pepetech/iot-gateway/models/iot-gateway-box.stl

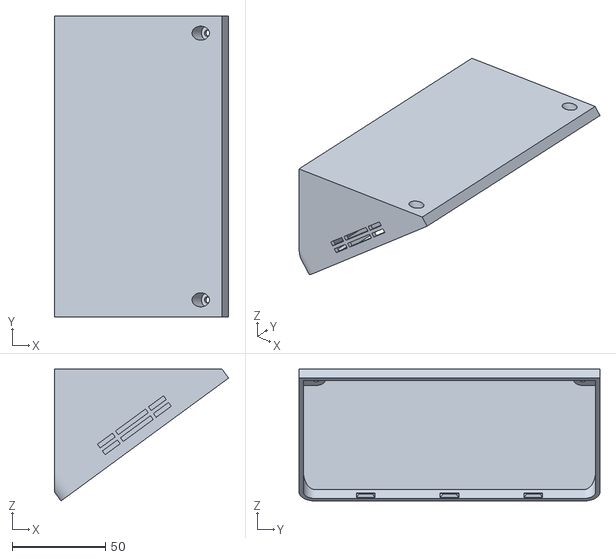
[picture p1: CAD file, 2019-12-28]
models/iot-gateway-box.stl
93.5 x 161.6 x 70.8
