pepetech/iot-gateway/models/iot-gateway-cover.stl

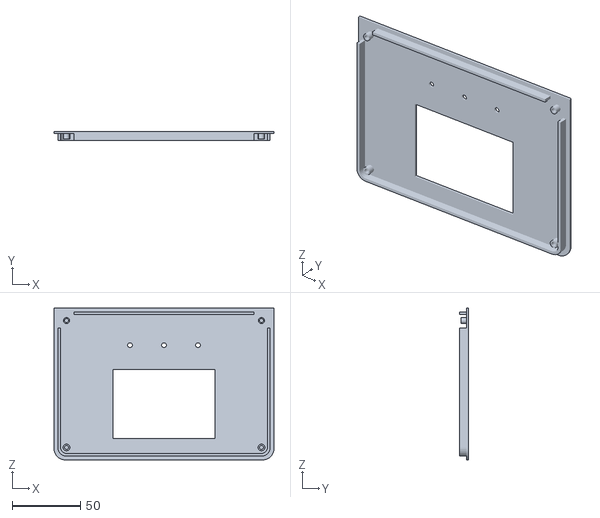
[picture p2: CAD file, 2019-12-28]
models/iot-gateway-cover.stl
161.6 x 6.70 x 111.6
