pepetech/iot-gateway/pcb/main/iot-gateway-main.pdf

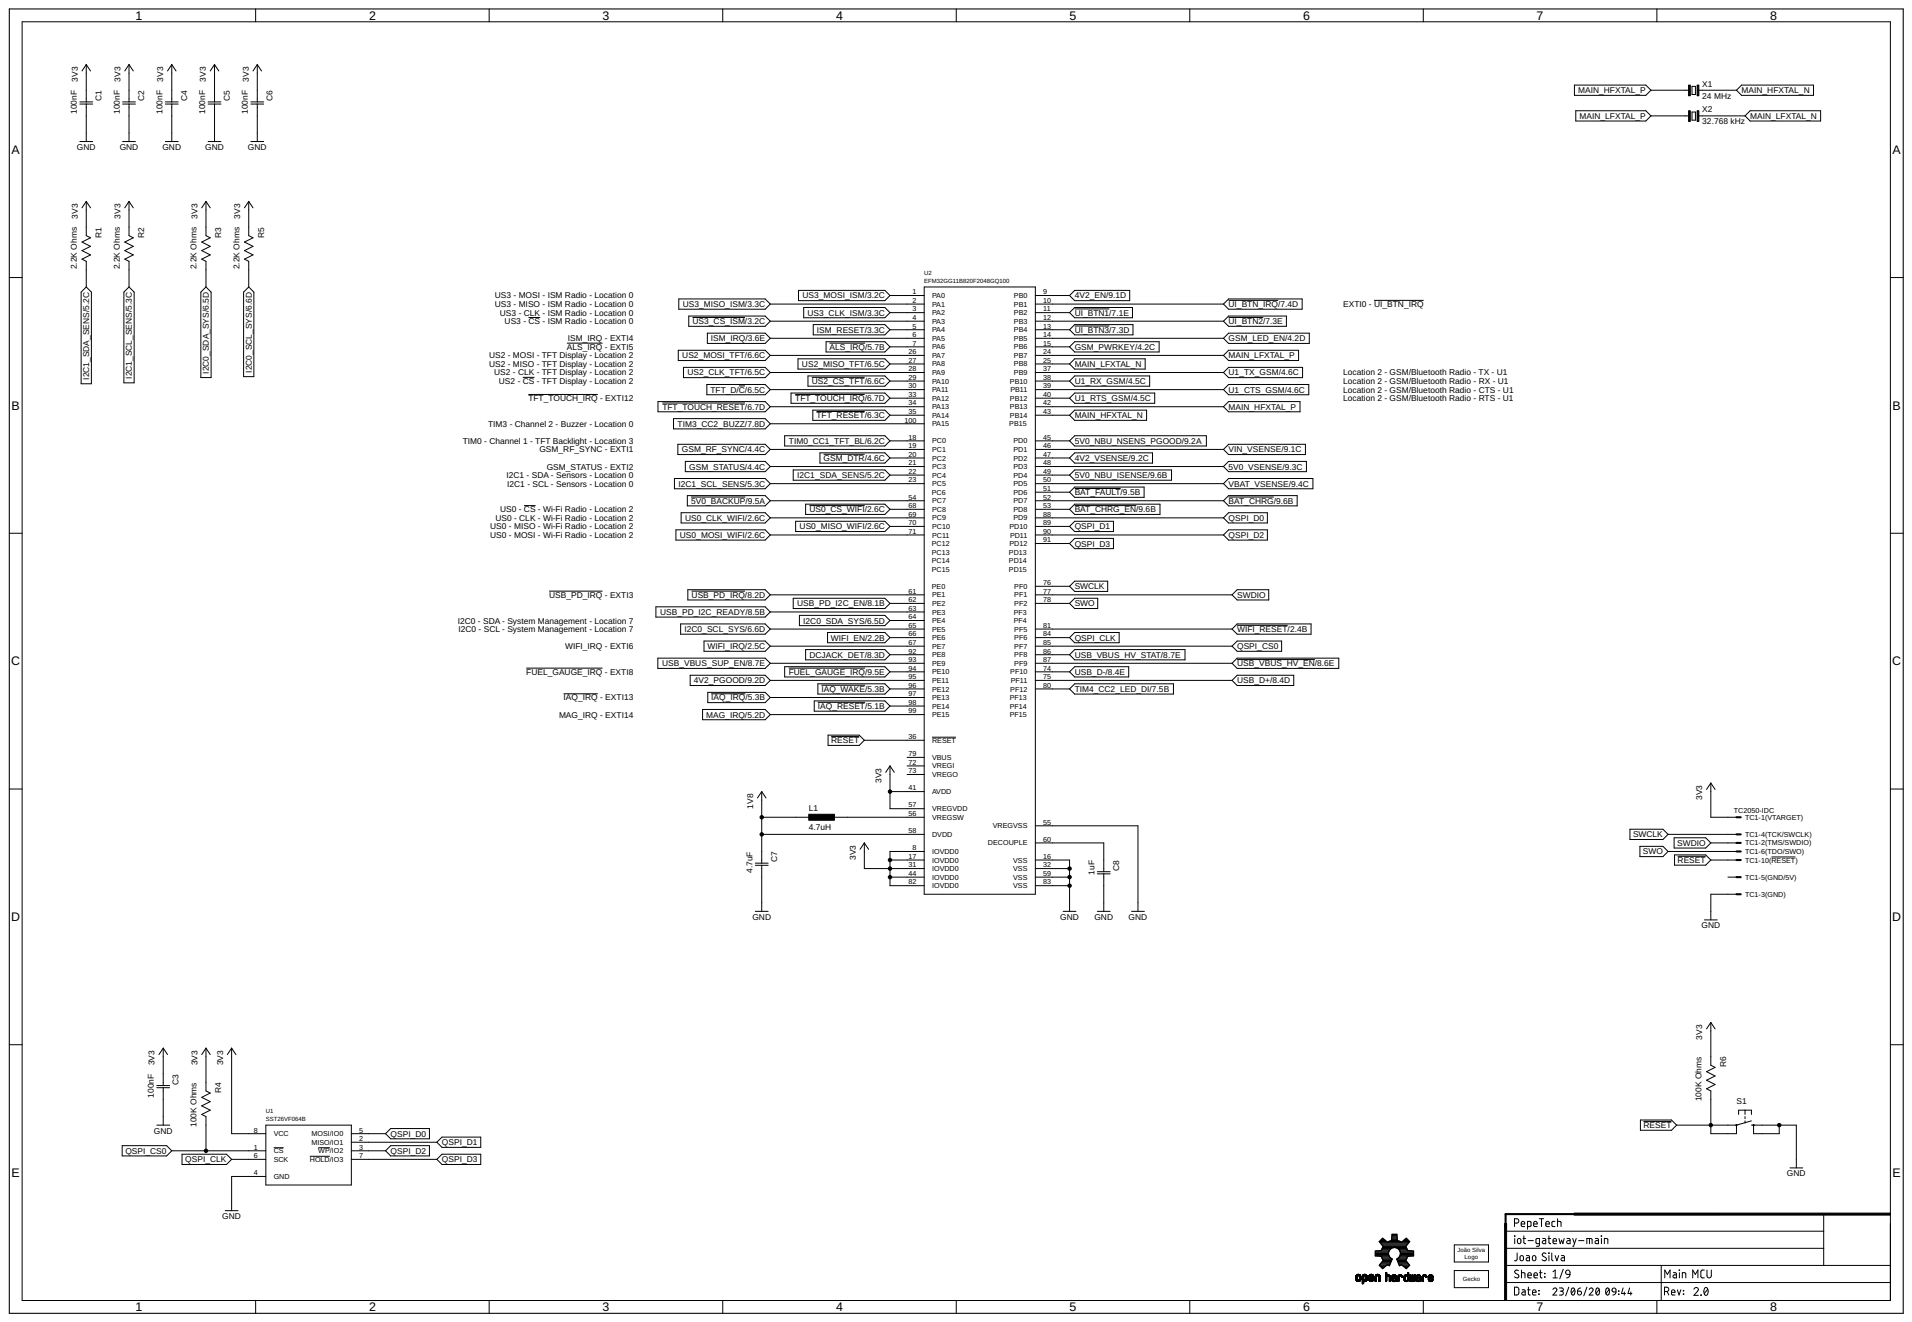
[picture p3: page 1]

US3 - MOSI - ISM Radio - Location 0
US3 - MISO - ISM Radio - Location 0
US3 - CLK - ISM Radio - Location 0
US3 - CS - ISM Radio - Location 0

US2 - MOSI - TFT Display - Location 2
US2 - MISO - TFT Display - Location 2
US2 - CLK - TFT Display - Location 2
US2 - CS - TFT Display - Location 2

Location 2 - GSM/Bluetooth Radio - TX - U1
Location 2 - GSM/Bluetooth Radio - RX - U1
Location 2 - GSM/Bluetooth Radio - CTS - U1
Location 2 - GSM/Bluetooth Radio - RTS - U1

TIM3 - Channel 2 - Buzzer - Location 0
TIM0 - Channel 1 - TFT Backlight - Location 3

US0 - CS - Wi-Fi Radio - Location 2
US0 - CLK - Wi-Fi Radio - Location 2
US0 - MISO - Wi-Fi Radio - Location 2
US0 - MOSI - Wi-Fi Radio - Location 2

I2C0 - SDA - System Management - Location 7
I2C0 - SCL - System Management - Location 7

TC2050-IDC
TC1-1(VTARGET) TC1-2(TMS/SWDIO) TC1-3(GND)

TC1-4(TCK/SWCLK) TC1-5(GND/5V) TC1-6(TDO/SWO) TC1-10(RESET)

31 | 32 VSS
44 | 59 VSS

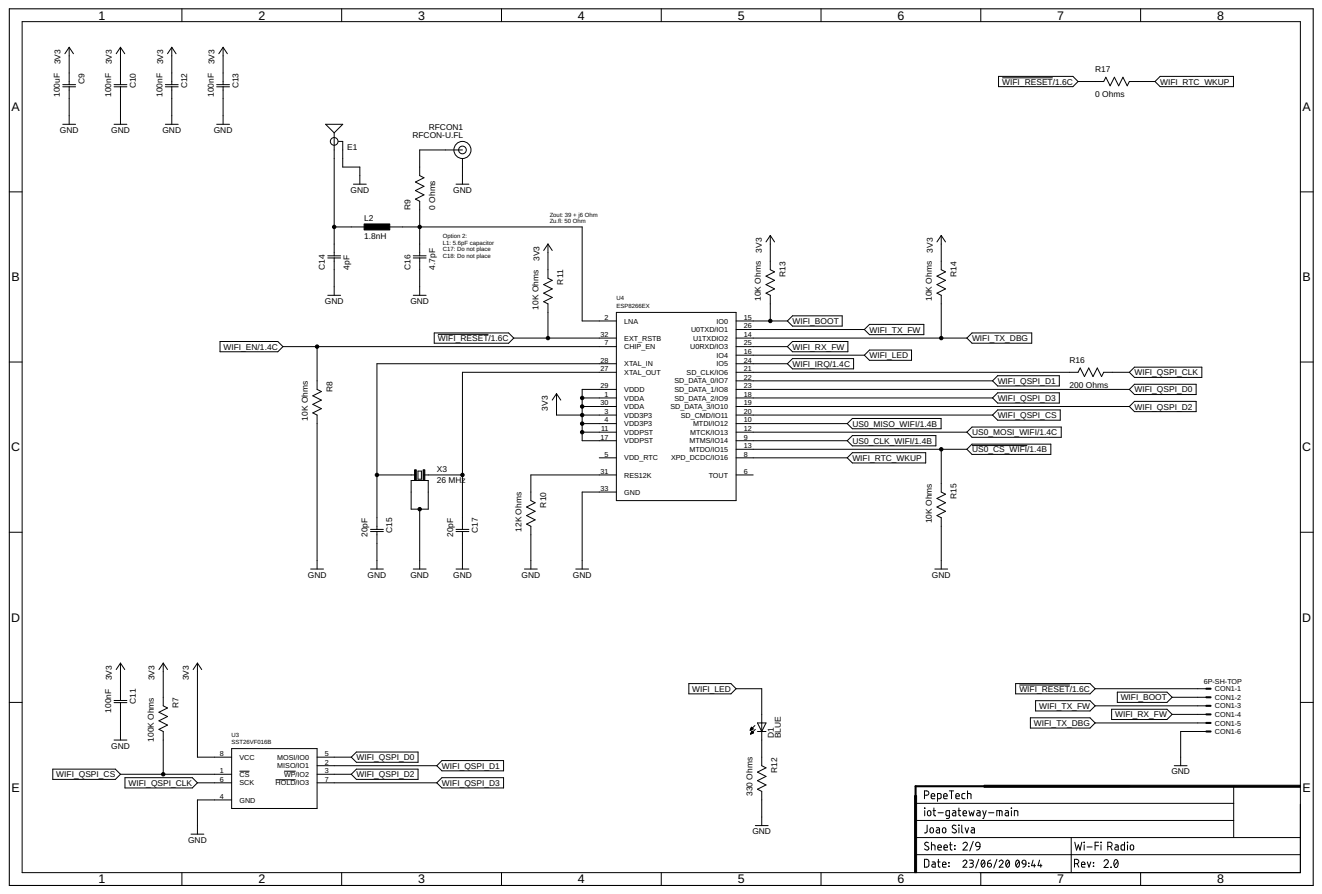
[picture p4: page 2]

Option 2: L1: 5.6pF capacitor C17: Do not place C18: Do not place

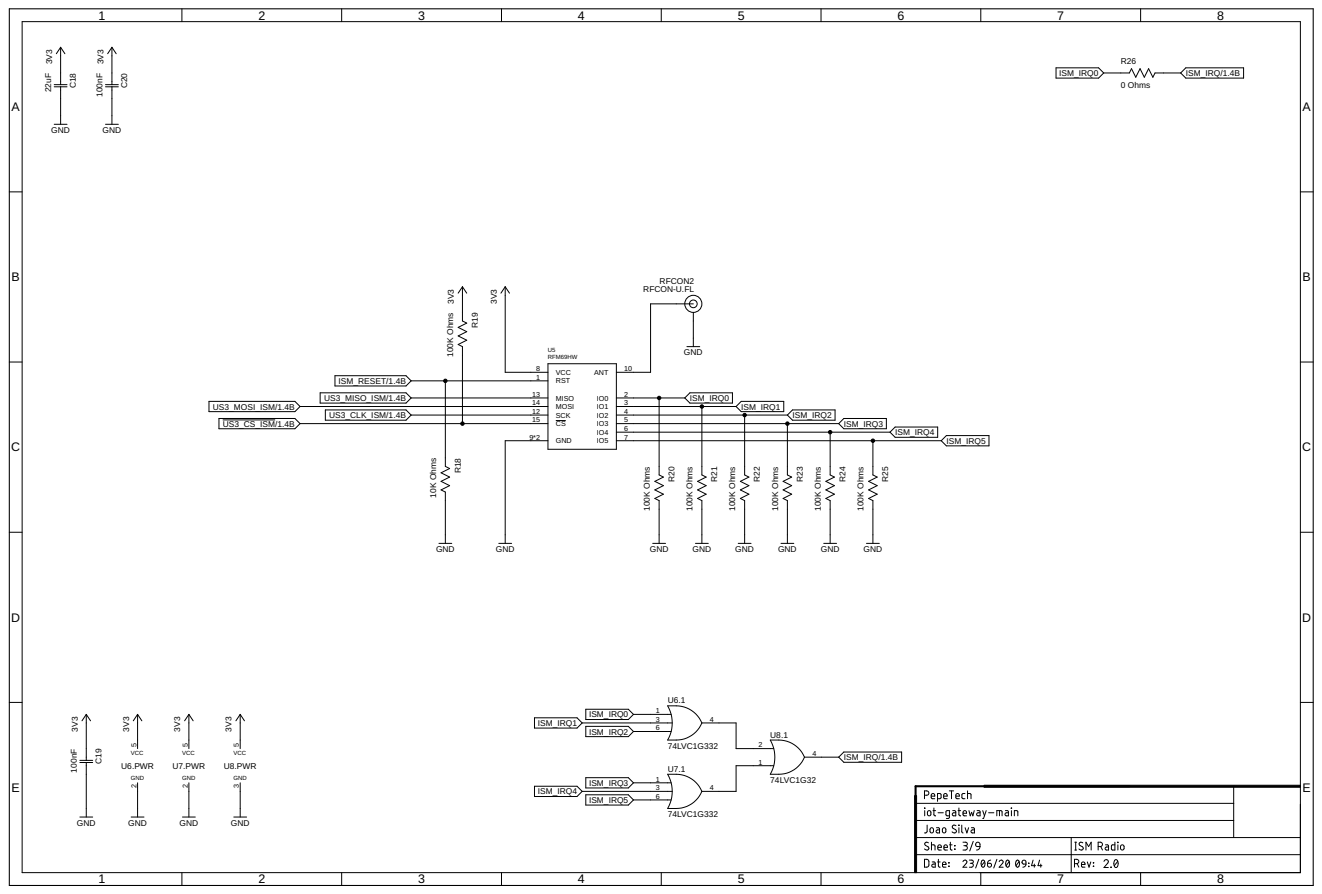
[picture p5: page 3]

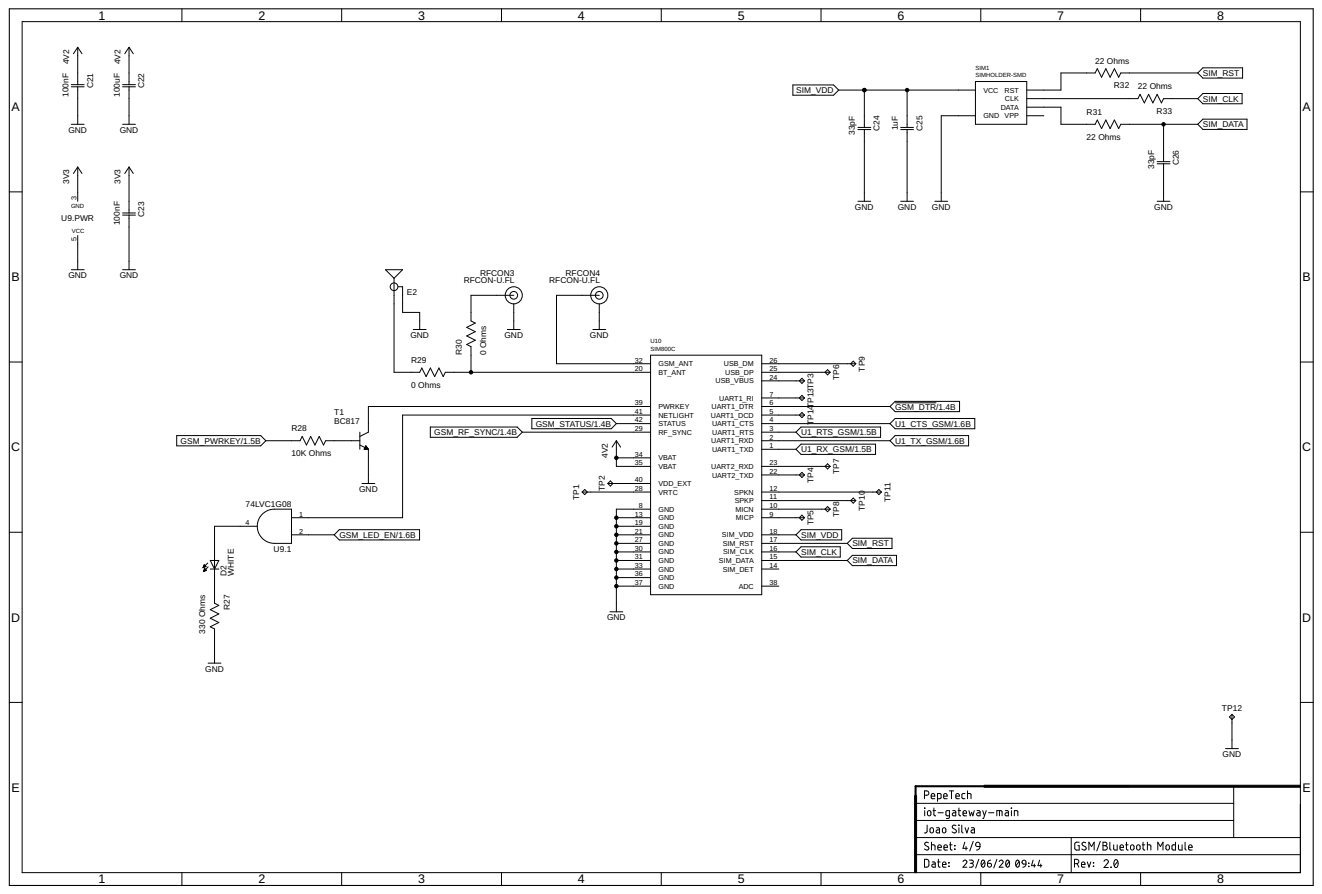
[picture p6: page 4]

SIMHOLDER-SMD
VCC RST CLK GND VPP DATA

RFCON3 RFCON4

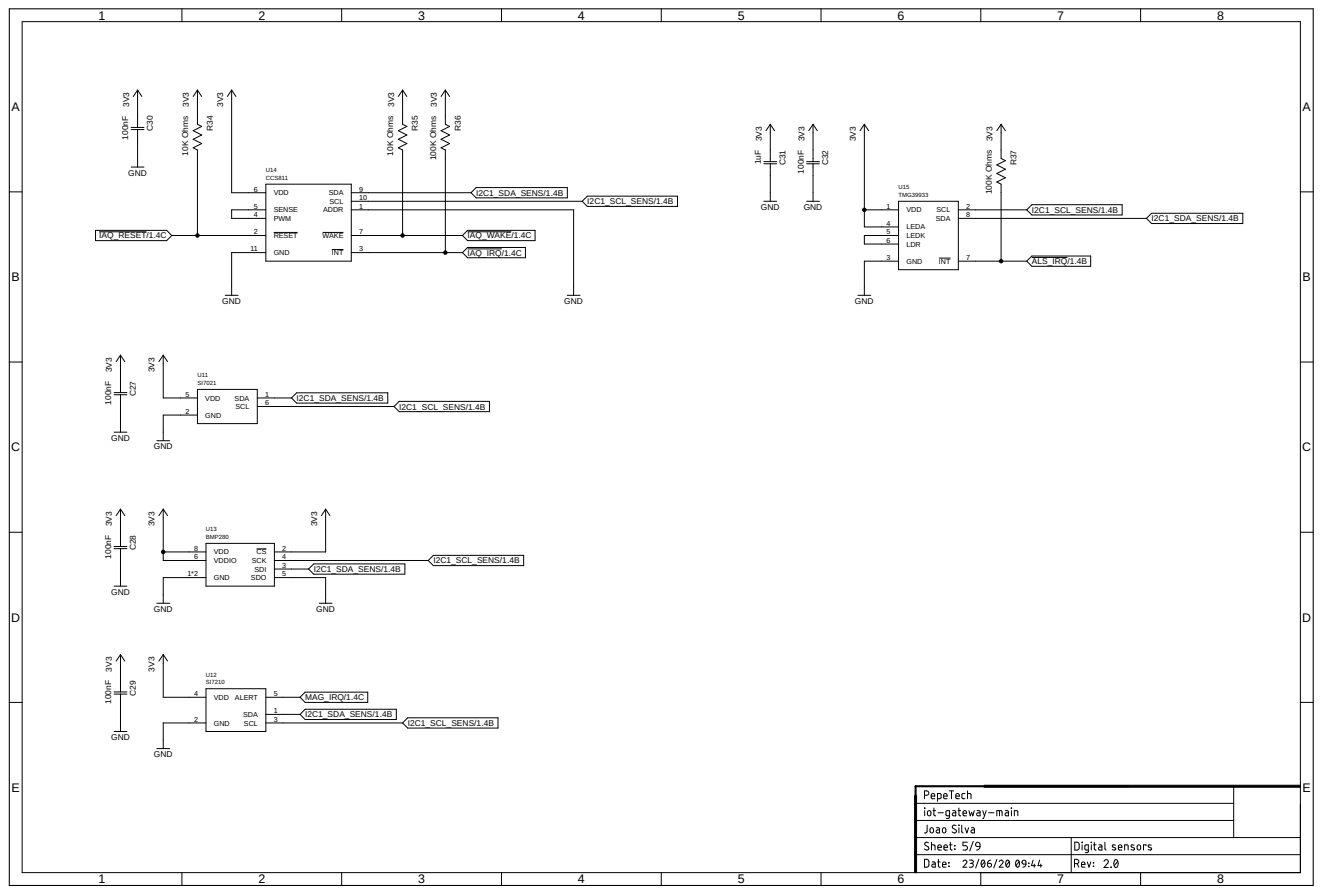
[picture p7: page 5]

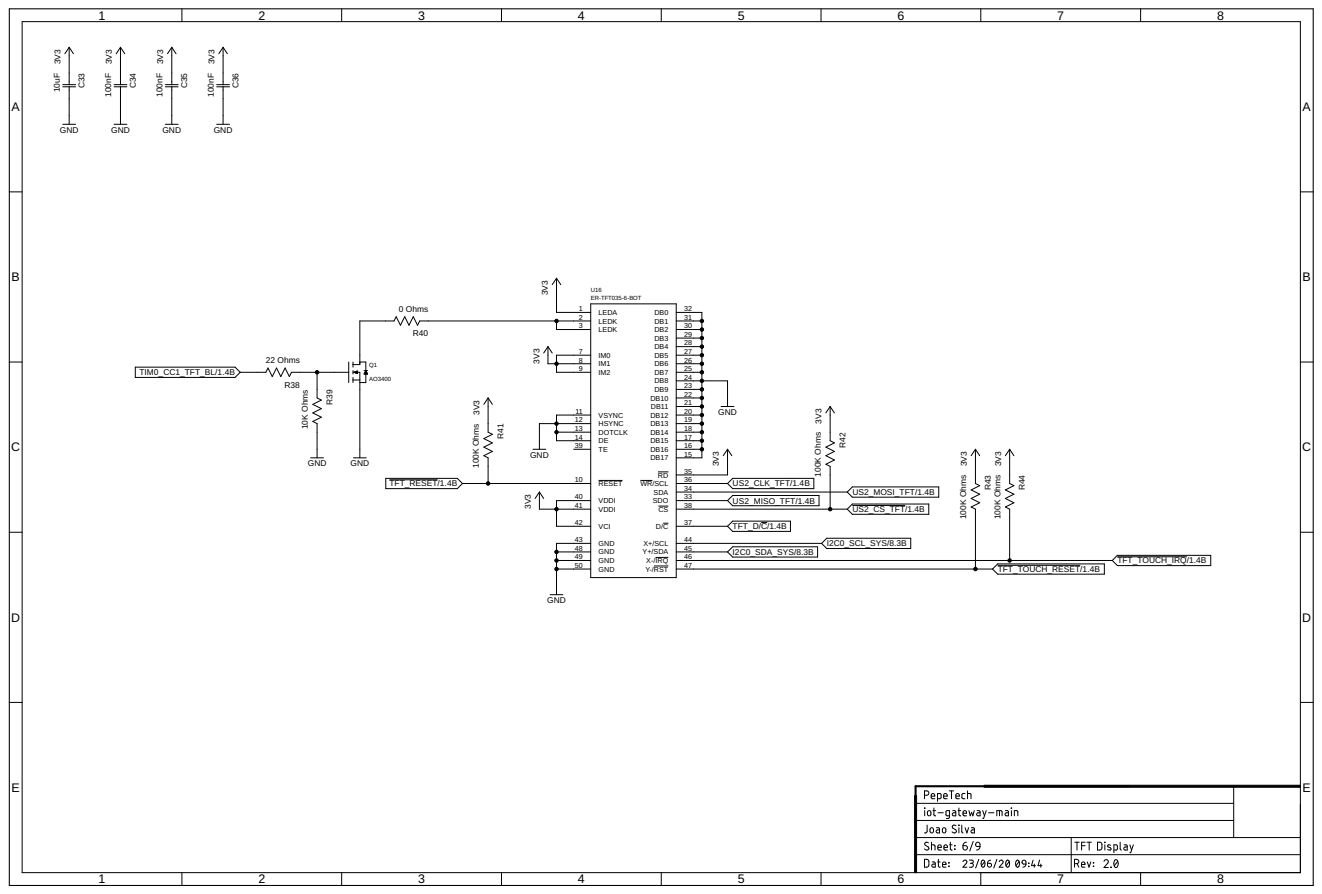
[picture p8: page 6]

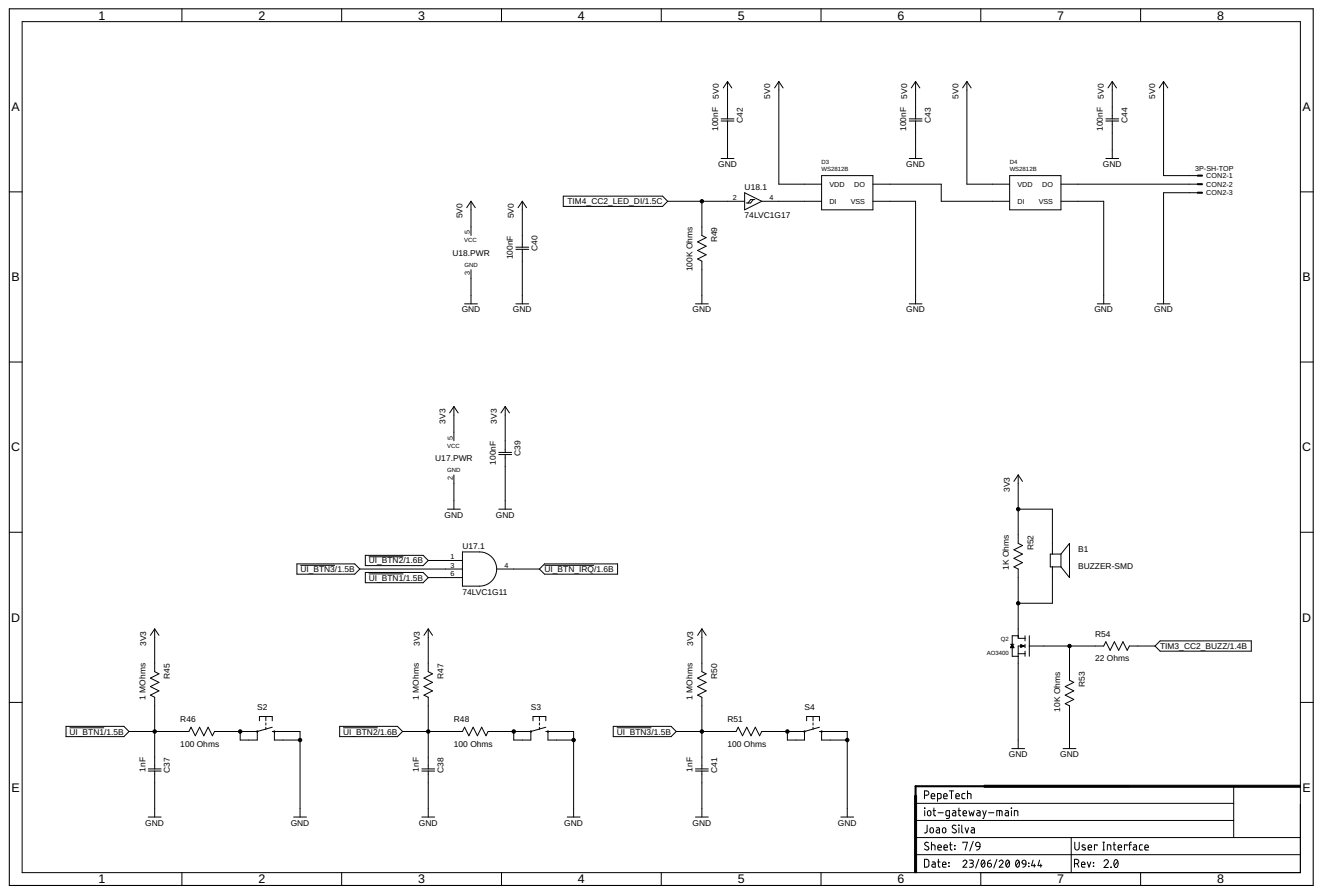
[picture p9: page 7]

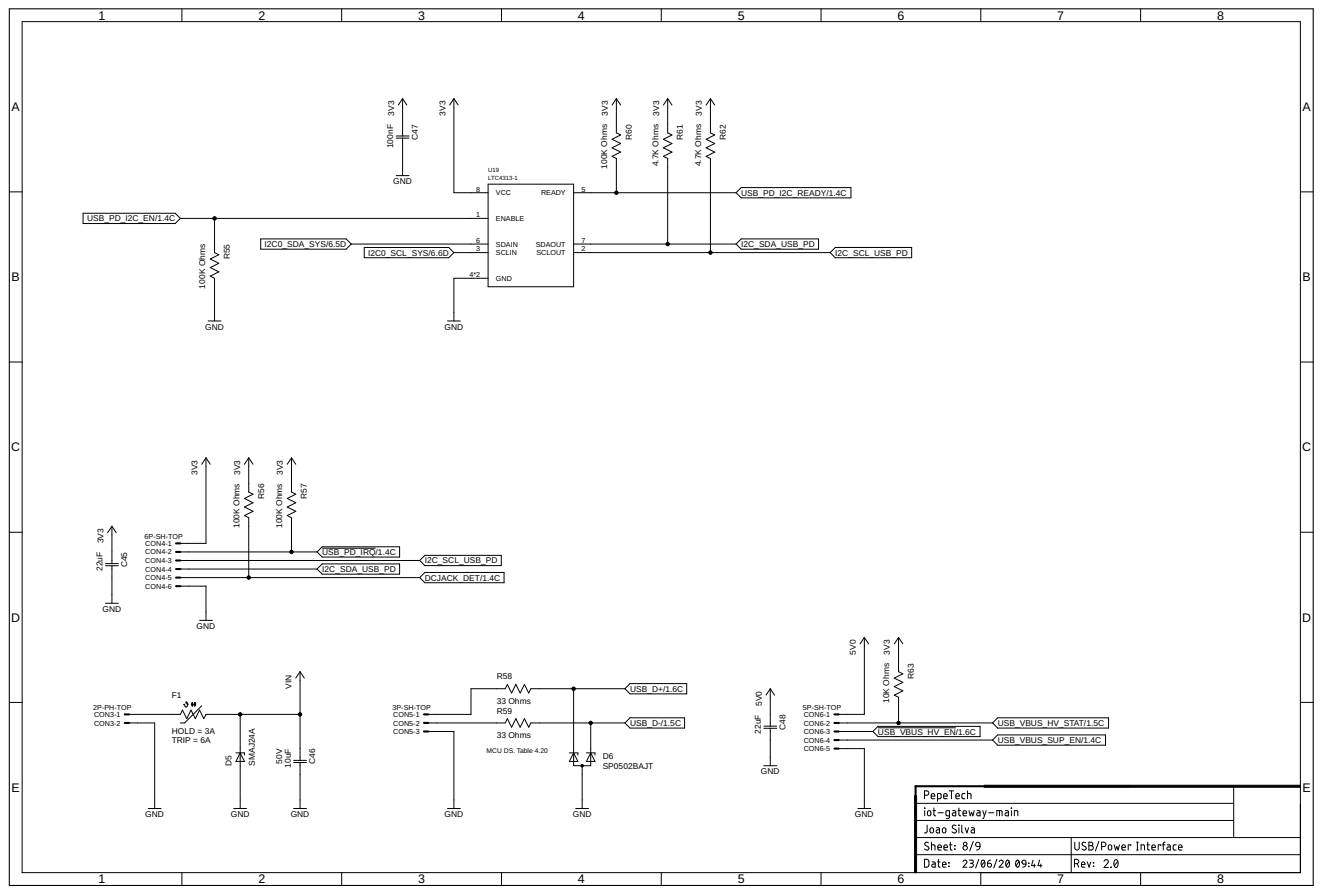
[picture p10: page 8]

MCU DS. Table 4.20 HOLD = 3A
TRIP = 6A

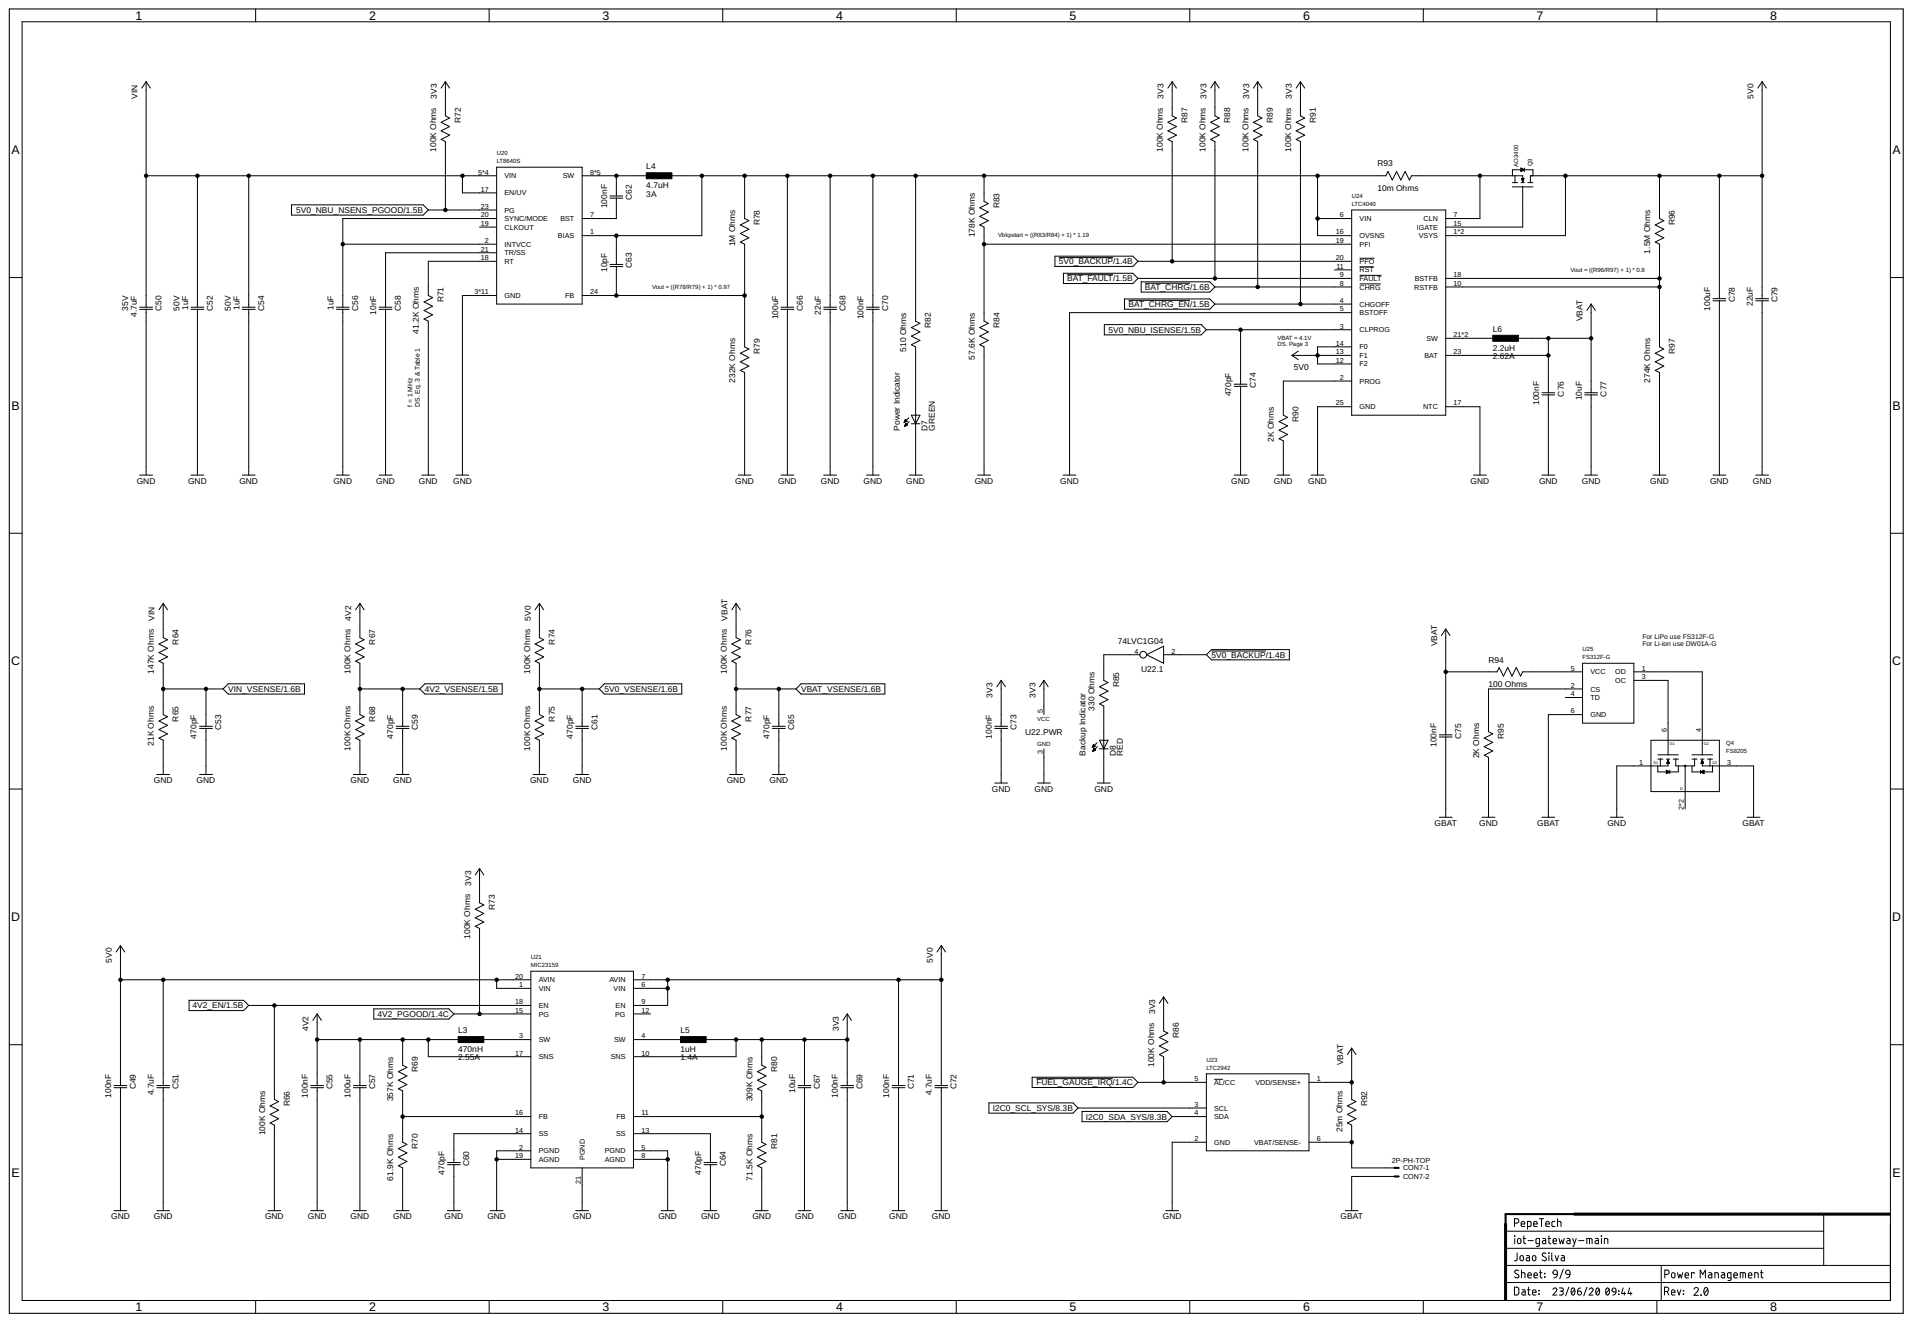
[picture p11: page 9]

4.7uF GND GND GND GND GND GND

f = 1 MHz DS. Eq. 3 & Table 1

For LiPo use FS312F-G
For Li-ion use DW01A-G

2K Ohms GND GBAT GND GBAT

100K Ohms GND GND GND
