pepetech/iot-gateway/pcb/usb-pd/iot-gateway-usb-pd.pdf

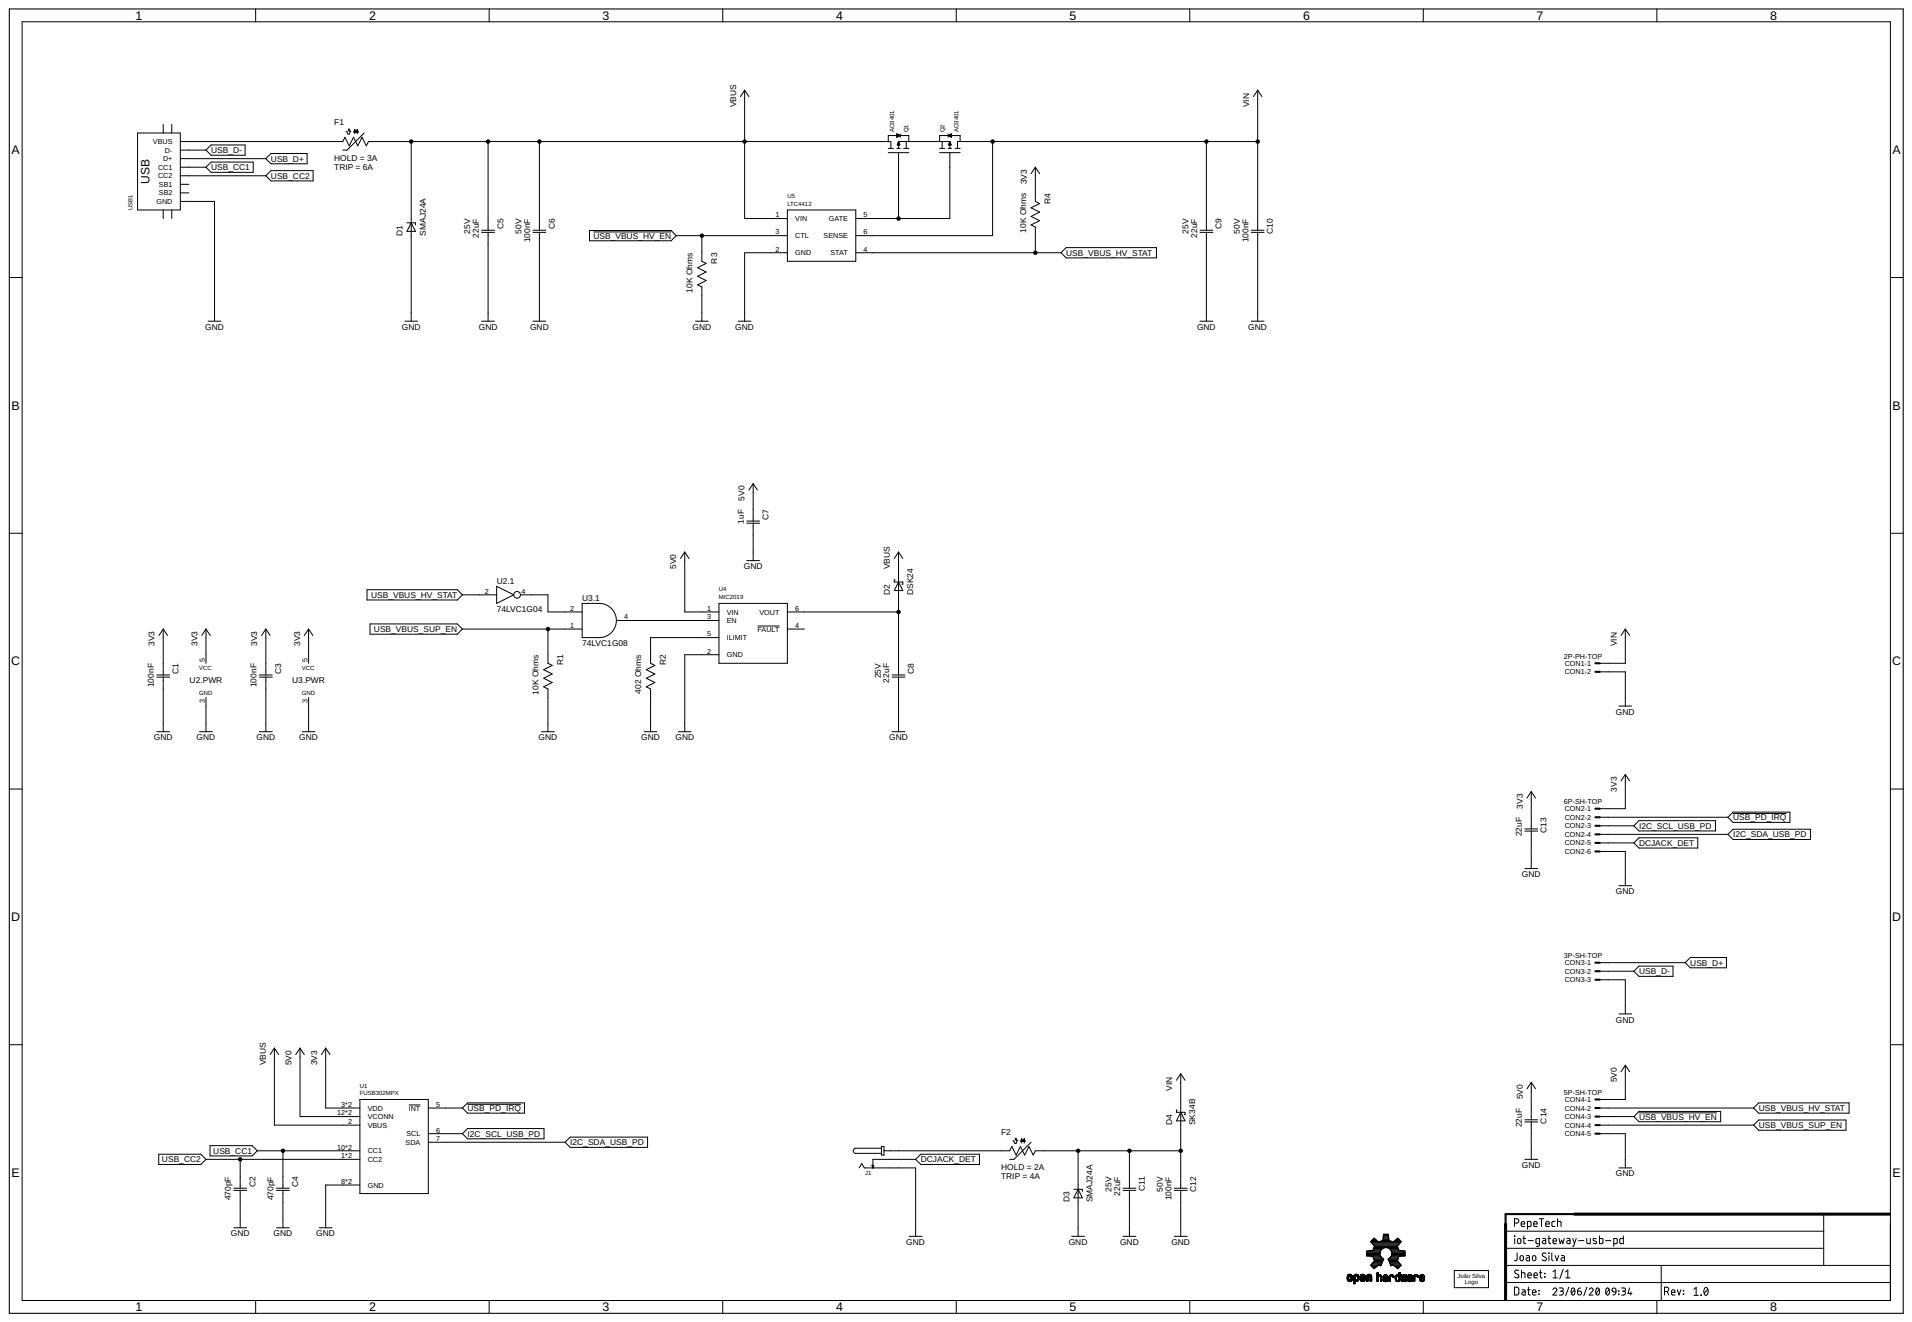
[picture p12: page 1]

10K Ohms GND GND GND
