pepetech/iot-gateway/pcb/main/iot-gateway-main.brd

## EAGLE design pcb/main/iot-gateway-main.brd (2020-08-31)

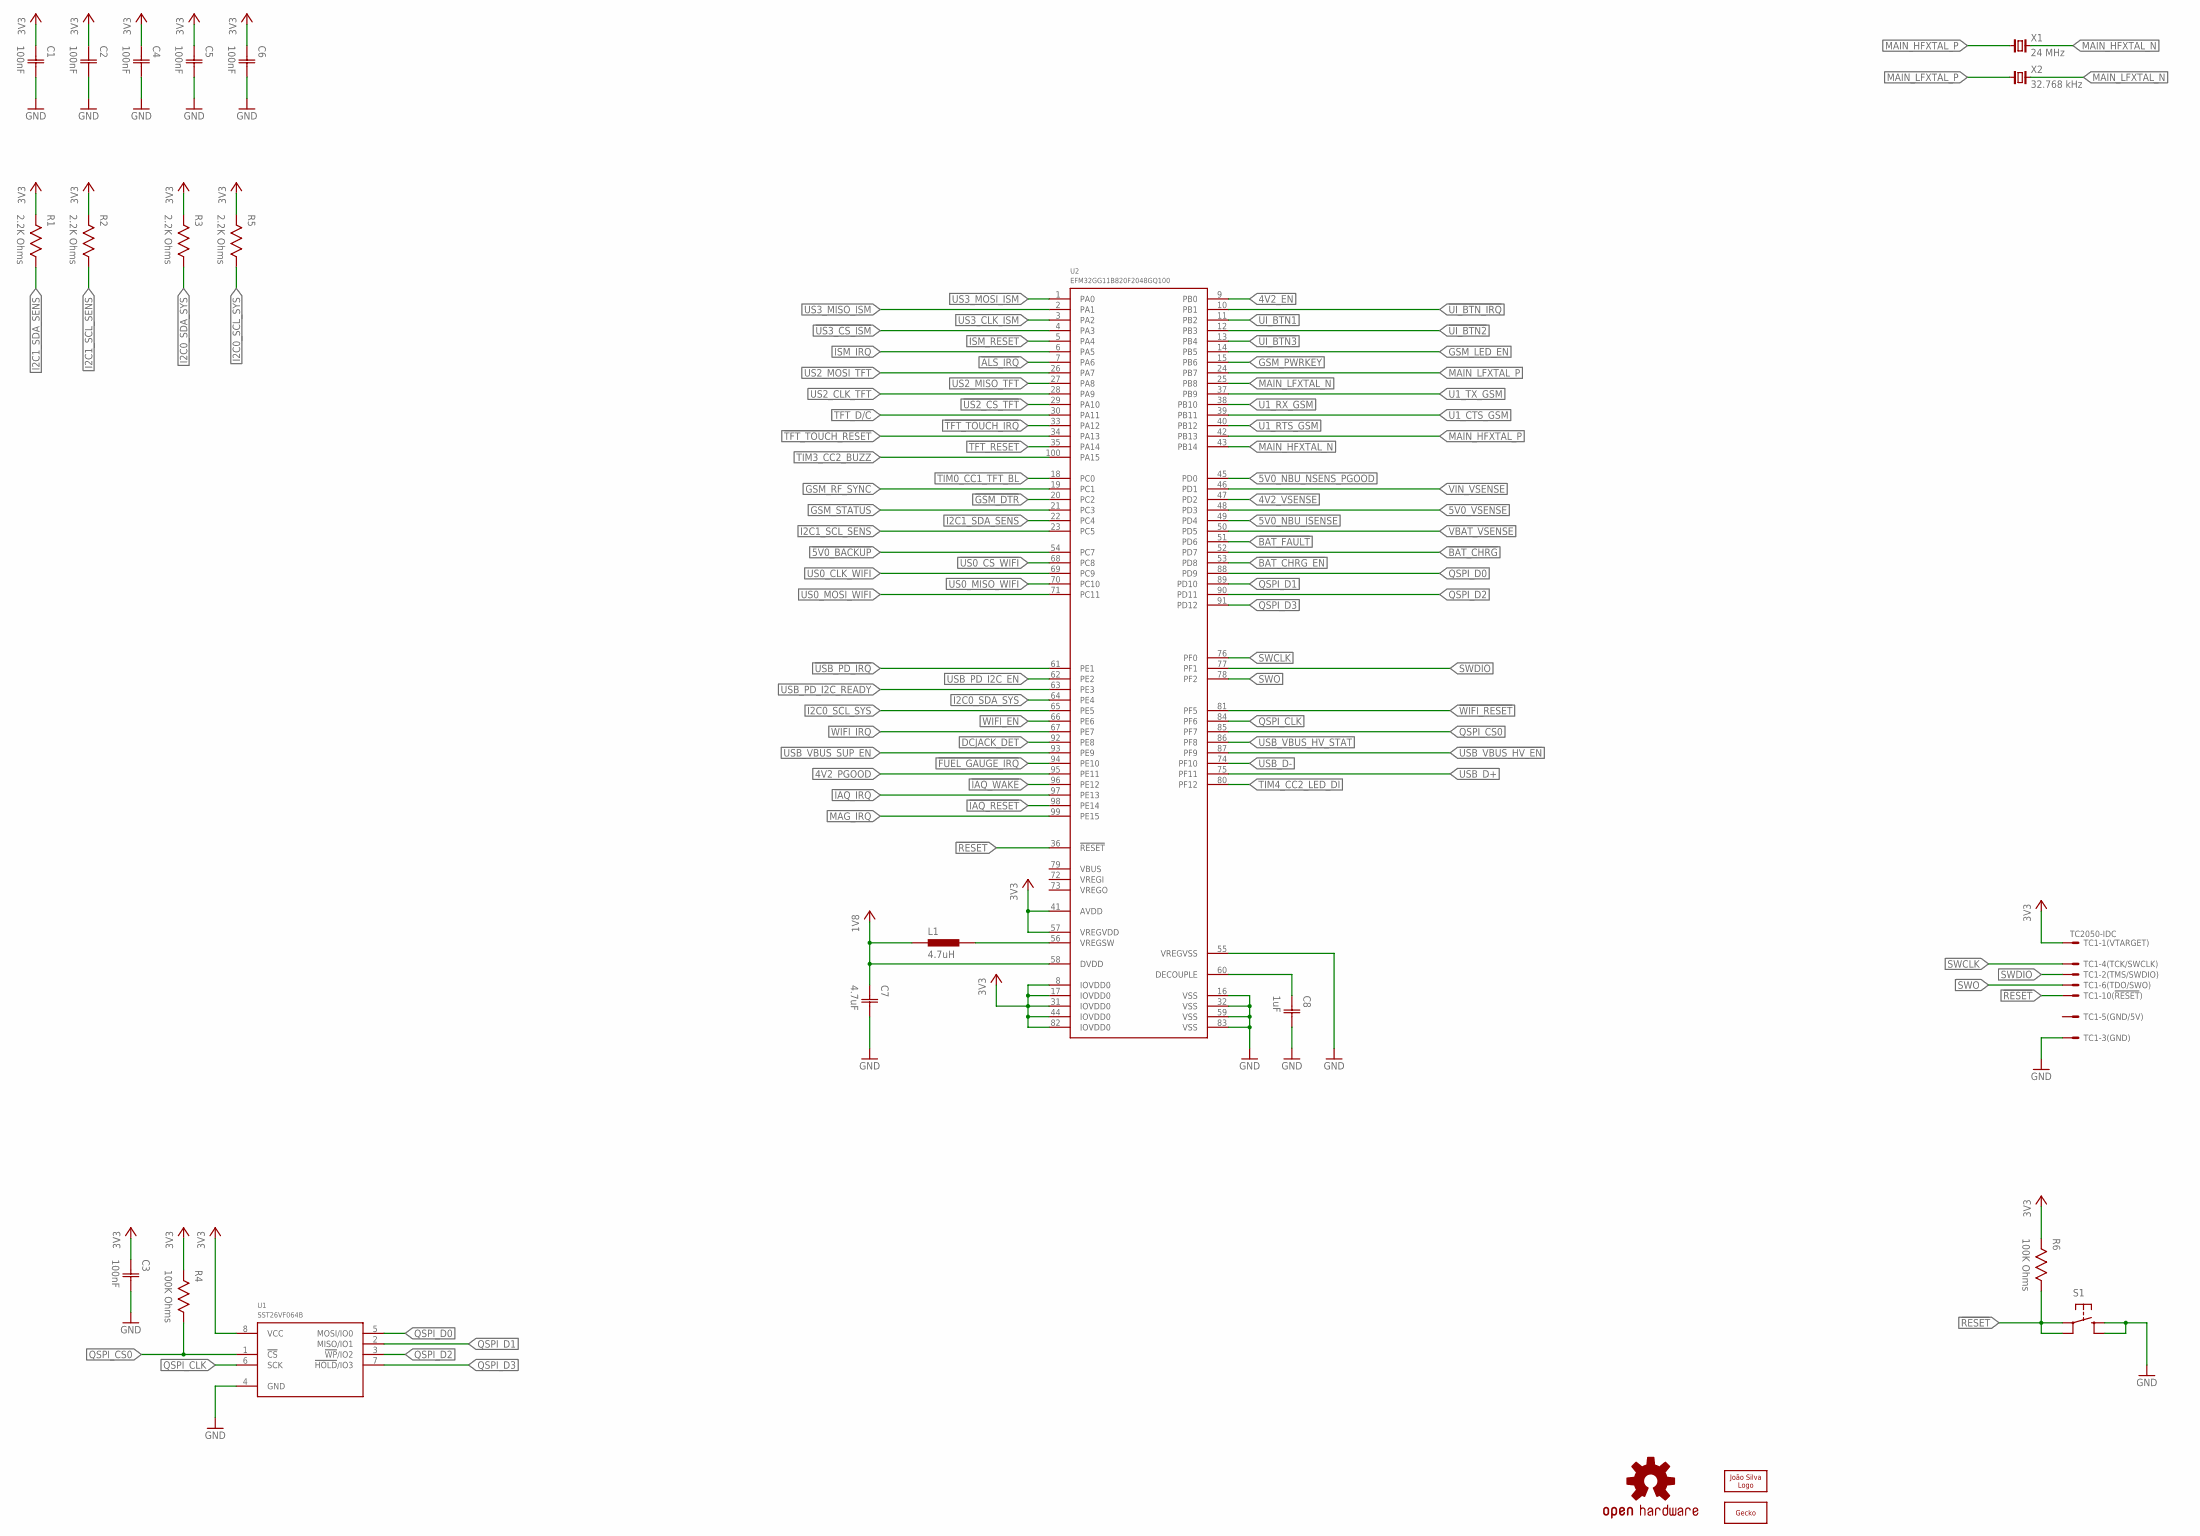
[picture p13: schematic iot-gateway-main.sch, sheet 1, Main MCU]

Parts:
C1, C2, C3, C4, C5, C6: 100nF; CAP0603
C7: 4.7uF; CAP0603
C8: 1uF; CAP0603
L1: 4.7uH; IND0603
LOGO1: OSHW-LOGOM; OSHW-LOGO-M
LOGO2: JS-10MM; JS_10MM
LOGO3: GECKO-14MM; GECKO_14MM
R1, R2, R3, R5: 2.2K Ohms; RES0603
R4, R6: 100K Ohms; RES0603
S1: TAC_SWITCHSMD; TAC_SW_SMD_RESET
TC1: TC2050-IDC
U1: SST26VF064B; WSOIC8
U2: EFM32GG11B820F2048GQ100; QFP100
X1: 24 MHz; 2-SMD-5032
X2: 32.768 kHz; 2-SMD-3215

Connections:
1V8: C7.1 (C1), L1.1, U2.58 (DVDD)
3V3: C1.1 (C1), C2.1 (C1), C3.1 (C1), C4.1 (C1), C5.1 (C1), C6.1 (C1), R1.2, R2.2, R3.2, R4.2, R5.2, R6.2, TC1.1, U1.8 (VCC), U2.8 (IOVDD0), U2.17 (IOVDD0), U2.31 (IOVDD0), U2.41 (AVDD), U2.44 (IOVDD0), U2.57 (VREGVDD), U2.82 (IOVDD0); also elsewhere on the board
4V2_EN: U2.9 (PB0); also elsewhere on the board
4V2_PGOOD: U2.95 (PE11); also elsewhere on the board
4V2_VSENSE: U2.47 (PD2); also elsewhere on the board
5V0_NBU_ISENSE: U2.49 (PD4); also elsewhere on the board
5V0_NBU_NSENS_PGOOD: U2.45 (PD0); also elsewhere on the board
5V0_VSENSE: U2.48 (PD3); also elsewhere on the board
!5V0_BACKUP: U2.54 (PC7); also elsewhere on the board
!ALS_IRQ: U2.7 (PA6); also elsewhere on the board
!BAT_CHRG: U2.52 (PD7); also elsewhere on the board
!BAT_CHRG_EN: U2.53 (PD8); also elsewhere on the board
!BAT_FAULT: U2.51 (PD6); also elsewhere on the board
!FUEL_GAUGE_IRQ: U2.94 (PE10); also elsewhere on the board
!GSM_DTR: U2.20 (PC2); also elsewhere on the board
!IAQ_IRQ: U2.97 (PE13); also elsewhere on the board
!IAQ_RESET: U2.98 (PE14); also elsewhere on the board
!IAQ_WAKE: U2.96 (PE12); also elsewhere on the board
!RESET: R6.1, S1.1, S1.2, TC1.10, U2.36 (!RESET)
!TFT_RESET: U2.35 (PA14); also elsewhere on the board
!TFT_TOUCH_IRQ: U2.33 (PA12); also elsewhere on the board
!TFT_TOUCH_RESET: U2.34 (PA13); also elsewhere on the board
!UI_BTN1: U2.11 (PB2); also elsewhere on the board
!UI_BTN2: U2.12 (PB3); also elsewhere on the board
!UI_BTN3: U2.13 (PB4); also elsewhere on the board
!UI_BTN_IRQ: U2.10 (PB1); also elsewhere on the board
!US0_CS_WIFI: U2.68 (PC8); also elsewhere on the board
!US2_CS_TFT: U2.29 (PA10); also elsewhere on the board
!US3_CS_ISM: U2.4 (PA3); also elsewhere on the board
!USB_PD_IRQ: U2.61 (PE1); also elsewhere on the board
!USB_VBUS_HV_EN: U2.87 (PF9); also elsewhere on the board
!WIFI_RESET: U2.81 (PF5); also elsewhere on the board
DCJACK_DET: U2.92 (PE8); also elsewhere on the board
GND: C1.2 (C2), C2.2 (C2), C3.2 (C2), C4.2 (C2), C5.2 (C2), C6.2 (C2), C7.2 (C2), C8.2 (C2), S1.3, S1.4, TC1.3, U1.4 (GND), U2.16 (VSS), U2.32 (VSS), U2.55 (VREGVSS), U2.59 (VSS), U2.83 (VSS); also elsewhere on the board
GSM_LED_EN: U2.14 (PB5); also elsewhere on the board
GSM_PWRKEY: U2.15 (PB6); also elsewhere on the board
GSM_RF_SYNC: U2.19 (PC1); also elsewhere on the board
GSM_STATUS: U2.21 (PC3); also elsewhere on the board
I2C0_SCL_SYS: R5.1, U2.65 (PE5); also elsewhere on the board
I2C0_SDA_SYS: R3.1, U2.64 (PE4); also elsewhere on the board
I2C1_SCL_SENS: R2.1, U2.23 (PC5); also elsewhere on the board
I2C1_SDA_SENS: R1.1, U2.22 (PC4); also elsewhere on the board
ISM_IRQ: U2.6 (PA5); also elsewhere on the board
ISM_RESET: U2.5 (PA4); also elsewhere on the board
MAG_IRQ: U2.99 (PE15); also elsewhere on the board
MAIN_HFXTAL_N: U2.43 (PB14), X1.2
MAIN_HFXTAL_P: U2.42 (PB13), X1.1
MAIN_LFXTAL_N: U2.25 (PB8), X2.2
MAIN_LFXTAL_P: U2.24 (PB7), X2.1
MAIN_VDD_CORE: C8.1 (C1), U2.60 (DECOUPLE)
MAIN_VREG_SW: L1.2, U2.56 (VREGSW)
QSPI_CLK: U1.6 (SCK), U2.84 (PF6)
QSPI_CS0: R4.1, U1.1 (!CS!), U2.85 (PF7)
QSPI_D0: U1.5 (MOSI/IO0), U2.88 (PD9)
QSPI_D1: U1.2 (MISO/IO1), U2.89 (PD10)
QSPI_D2: U1.3 (!WP!/IO2), U2.90 (PD11)
QSPI_D3: U1.7 (!HOLD!/IO3), U2.91 (PD12)
SWCLK: TC1.4, U2.76 (PF0)
SWDIO: TC1.2, U2.77 (PF1)
SWO: TC1.6, U2.78 (PF2)
TFT_D/!C!: U2.30 (PA11); also elsewhere on the board
TIM0_CC1_TFT_BL: U2.18 (PC0); also elsewhere on the board
TIM3_CC2_BUZZ: U2.100 (PA15); also elsewhere on the board
TIM4_CC2_LED_DI: U2.80 (PF12); also elsewhere on the board
U1_CTS_GSM: U2.39 (PB11); also elsewhere on the board
U1_RTS_GSM: U2.40 (PB12); also elsewhere on the board
U1_RX_GSM: U2.38 (PB10); also elsewhere on the board
U1_TX_GSM: U2.37 (PB9); also elsewhere on the board
US0_CLK_WIFI: U2.69 (PC9); also elsewhere on the board
US0_MISO_WIFI: U2.70 (PC10); also elsewhere on the board
US0_MOSI_WIFI: U2.71 (PC11); also elsewhere on the board
US2_CLK_TFT: U2.28 (PA9); also elsewhere on the board
US2_MISO_TFT: U2.27 (PA8); also elsewhere on the board
US2_MOSI_TFT: U2.26 (PA7); also elsewhere on the board
US3_CLK_ISM: U2.3 (PA2); also elsewhere on the board
US3_MISO_ISM: U2.2 (PA1); also elsewhere on the board
US3_MOSI_ISM: U2.1 (PA0); also elsewhere on the board
USB_D+: U2.75 (PF11); also elsewhere on the board
USB_D-: U2.74 (PF10); also elsewhere on the board
USB_PD_I2C_EN: U2.62 (PE2); also elsewhere on the board
USB_PD_I2C_READY: U2.63 (PE3); also elsewhere on the board
USB_VBUS_HV_STAT: U2.86 (PF8); also elsewhere on the board
USB_VBUS_SUP_EN: U2.93 (PE9); also elsewhere on the board
VBAT_VSENSE: U2.50 (PD5); also elsewhere on the board
VIN_VSENSE: U2.46 (PD1); also elsewhere on the board
WIFI_EN: U2.66 (PE6); also elsewhere on the board
WIFI_IRQ: U2.67 (PE7); also elsewhere on the board

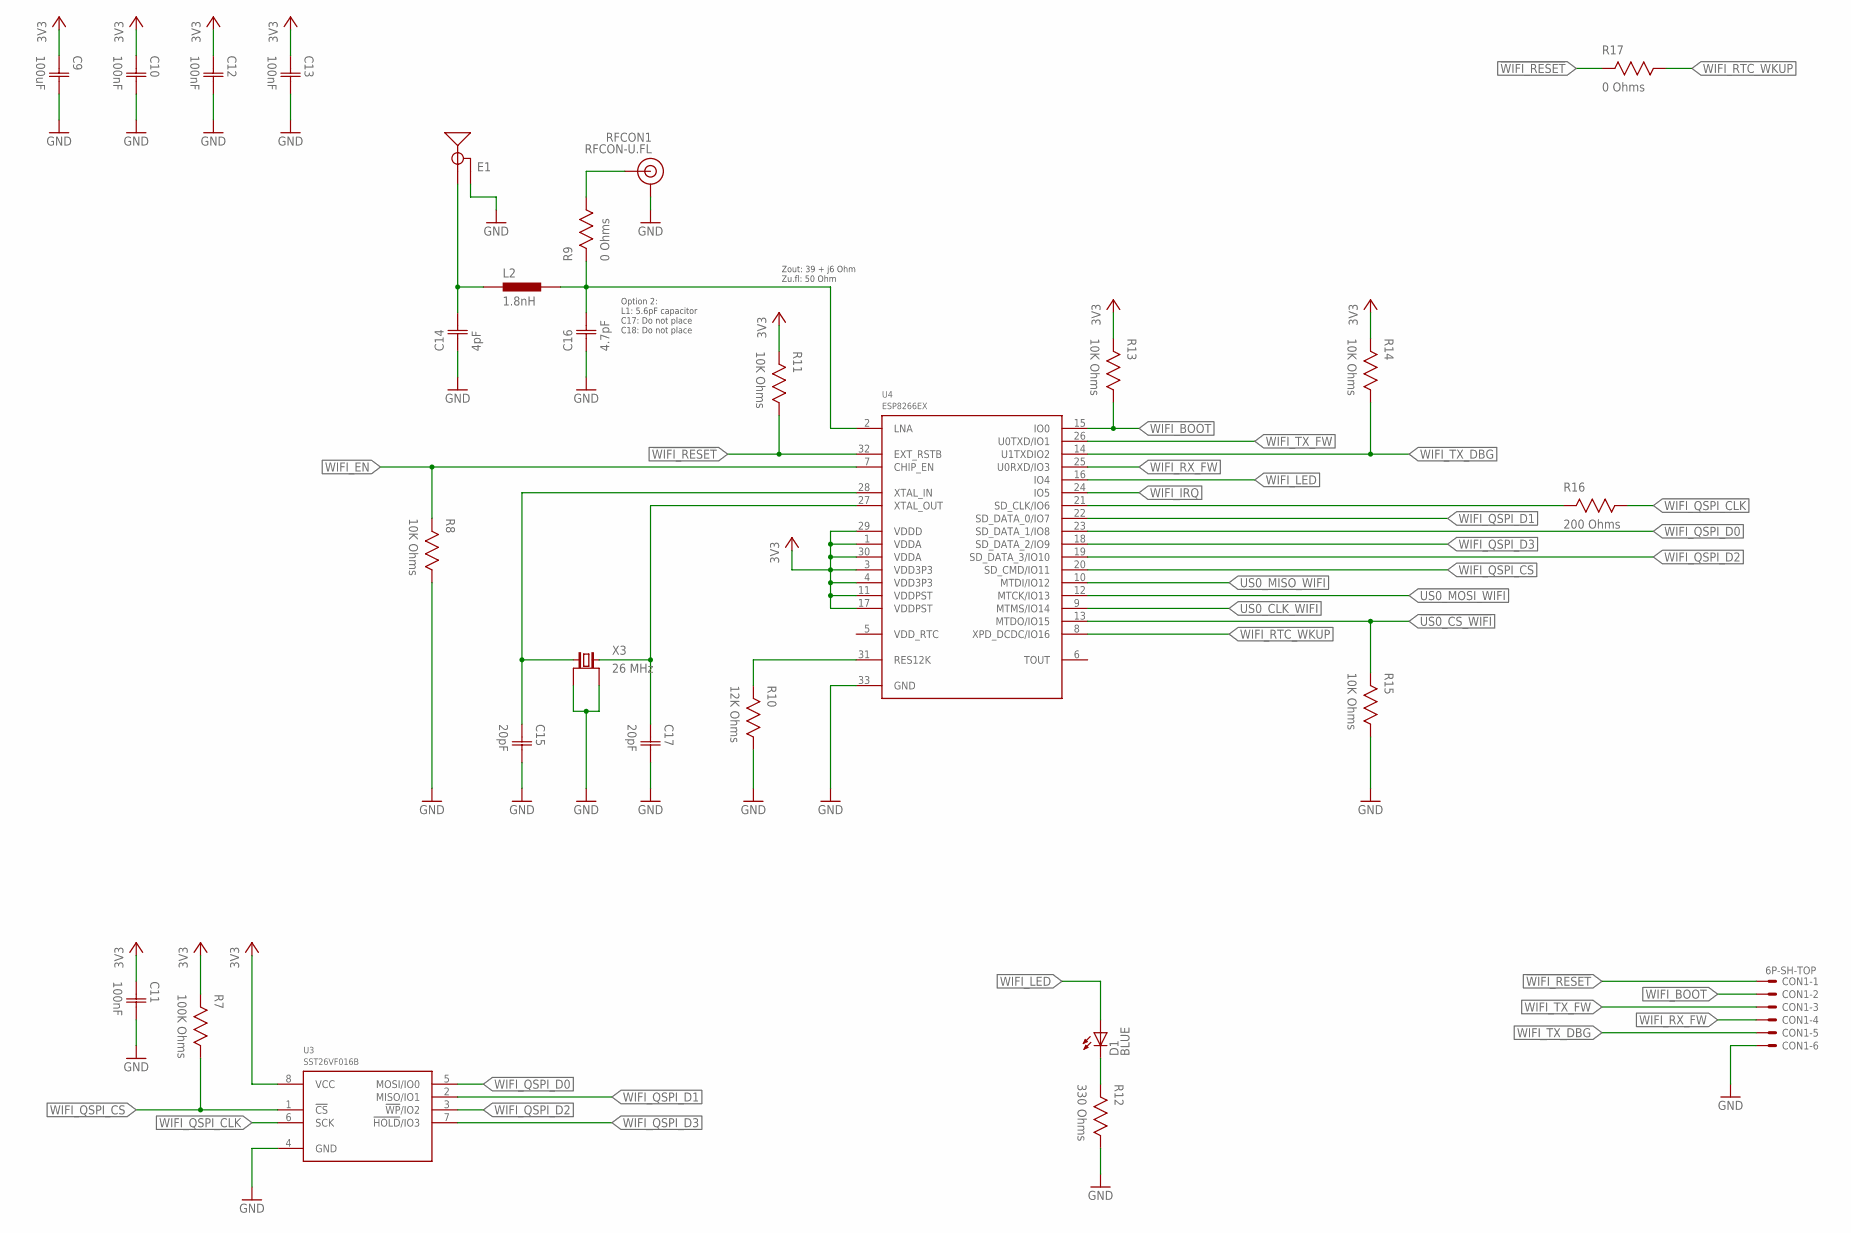
[picture p14: schematic iot-gateway-main.sch, sheet 2, Wi-Fi Radio]

Parts:
C9: 100uF; CAP1206
C10, C11, C12, C13: 100nF; CAP0603
C14: 4pF; CAP0603
C15, C17: 20pF; CAP0603
C16: 4.7pF; CAP0603
CON1: 6P-SH-TOP; SH-06-TOP
D1: BLUE; 1206_REV
E1: 2.4GHZTRACE-15.2MM; TRACE_ANTENNA_2.4GHZ_15.2MM
L2: 1.8nH; IND0603
R7: 100K Ohms; RES0603
R8, R11, R13, R14, R15: 10K Ohms; RES0603
R9, R17: 0 Ohms; RES0603
R10: 12K Ohms; RES0603
R12: 330 Ohms; RES0603
R16: 200 Ohms; RES0603
RFCON1: RFCON-U.FL; U.FL
U3: SST26VF016B; WSOIC8
U4: ESP8266EX; QFN32
X3: 26 MHz; 4-SMD-3225

Connections:
3V3: C9.1 (C1), C10.1 (C1), C11.1 (C1), C12.1 (C1), C13.1 (C1), R7.2, R11.2, R13.2, R14.2, U3.8 (VCC), U4.1 (VDDA), U4.3 (VDD3P3), U4.4 (VDD3P3), U4.11 (VDDPST), U4.17 (VDDPST), U4.29 (VDDD), U4.30 (VDDA); also elsewhere on the board
!US0_CS_WIFI: R15.2, U4.13 (MTDO/IO15); also elsewhere on the board
!WIFI_RESET: CON1.1, R11.1, R17.2, U4.32 (EXT_RSTB); also elsewhere on the board
GND: C9.2 (C2), C10.2 (C2), C11.2 (C2), C12.2 (C2), C13.2 (C2), C14.1 (C1), C15.2 (C2), C16.1 (C1), C17.2 (C2), CON1.6, E1.GND, R8.1, R10.1, R12.1, R15.1, RFCON1.P$1 (GND), RFCON1.P$2 (GND), U3.4 (GND), U4.33 (GND), X3.1 (GND), X3.3 (GND); also elsewhere on the board
unnamed: D1.C, R12.2
US0_CLK_WIFI: U4.9 (MTMS/IO14); also elsewhere on the board
US0_MISO_WIFI: U4.10 (MTDI/IO12); also elsewhere on the board
US0_MOSI_WIFI: U4.12 (MTCK/IO13); also elsewhere on the board
WIFI_ANT: C16.2 (C2), L2.2, R9.2, U4.2 (LNA)
WIFI_ANT_EXT: R9.1, RFCON1.P$3 (SIGNAL)
WIFI_ANT_FILT: C14.2 (C2), E1.ANT (SIGNAL), L2.1
WIFI_BIAS: R10.2, U4.31 (RES12K)
WIFI_BOOT: CON1.2, R13.1, U4.15 (IO0)
WIFI_EN: R8.2, U4.7 (CHIP_EN); also elsewhere on the board
WIFI_IRQ: U4.24 (IO5); also elsewhere on the board
WIFI_LED: D1.A, U4.16 (IO4)
WIFI_QSPI_CLK: R16.1, U3.6 (SCK)
WIFI_QSPI_CLK_FILT: R16.2, U4.21 (SD_CLK/IO6)
WIFI_QSPI_CS: R7.1, U3.1 (!CS!), U4.20 (SD_CMD/IO11)
WIFI_QSPI_D0: U3.5 (MOSI/IO0), U4.23 (SD_DATA_1/IO8)
WIFI_QSPI_D1: U3.2 (MISO/IO1), U4.22 (SD_DATA_0/IO7)
WIFI_QSPI_D2: U3.3 (!WP!/IO2), U4.19 (SD_DATA_3/IO10)
WIFI_QSPI_D3: U3.7 (!HOLD!/IO3), U4.18 (SD_DATA_2/IO9)
WIFI_RTC_WKUP: R17.1, U4.8 (XPD_DCDC/IO16)
WIFI_RX_FW: CON1.4, U4.25 (U0RXD/IO3)
WIFI_TX_DBG: CON1.5, R14.1, U4.14 (U1TXDIO2)
WIFI_TX_FW: CON1.3, U4.26 (U0TXD/IO1)
WIFI_XTAL_IN: C15.1 (C1), U4.28 (XTAL_IN), X3.2 (1)
WIFI_XTAL_OUT: C17.1 (C1), U4.27 (XTAL_OUT), X3.4 (2)

Notes on the sheet:
Option 2: L1: 5.6pF capacitor C17: Do not place C18: Do not place
Zout: 39 + j6 Ohm Zu.fl: 50 Ohm

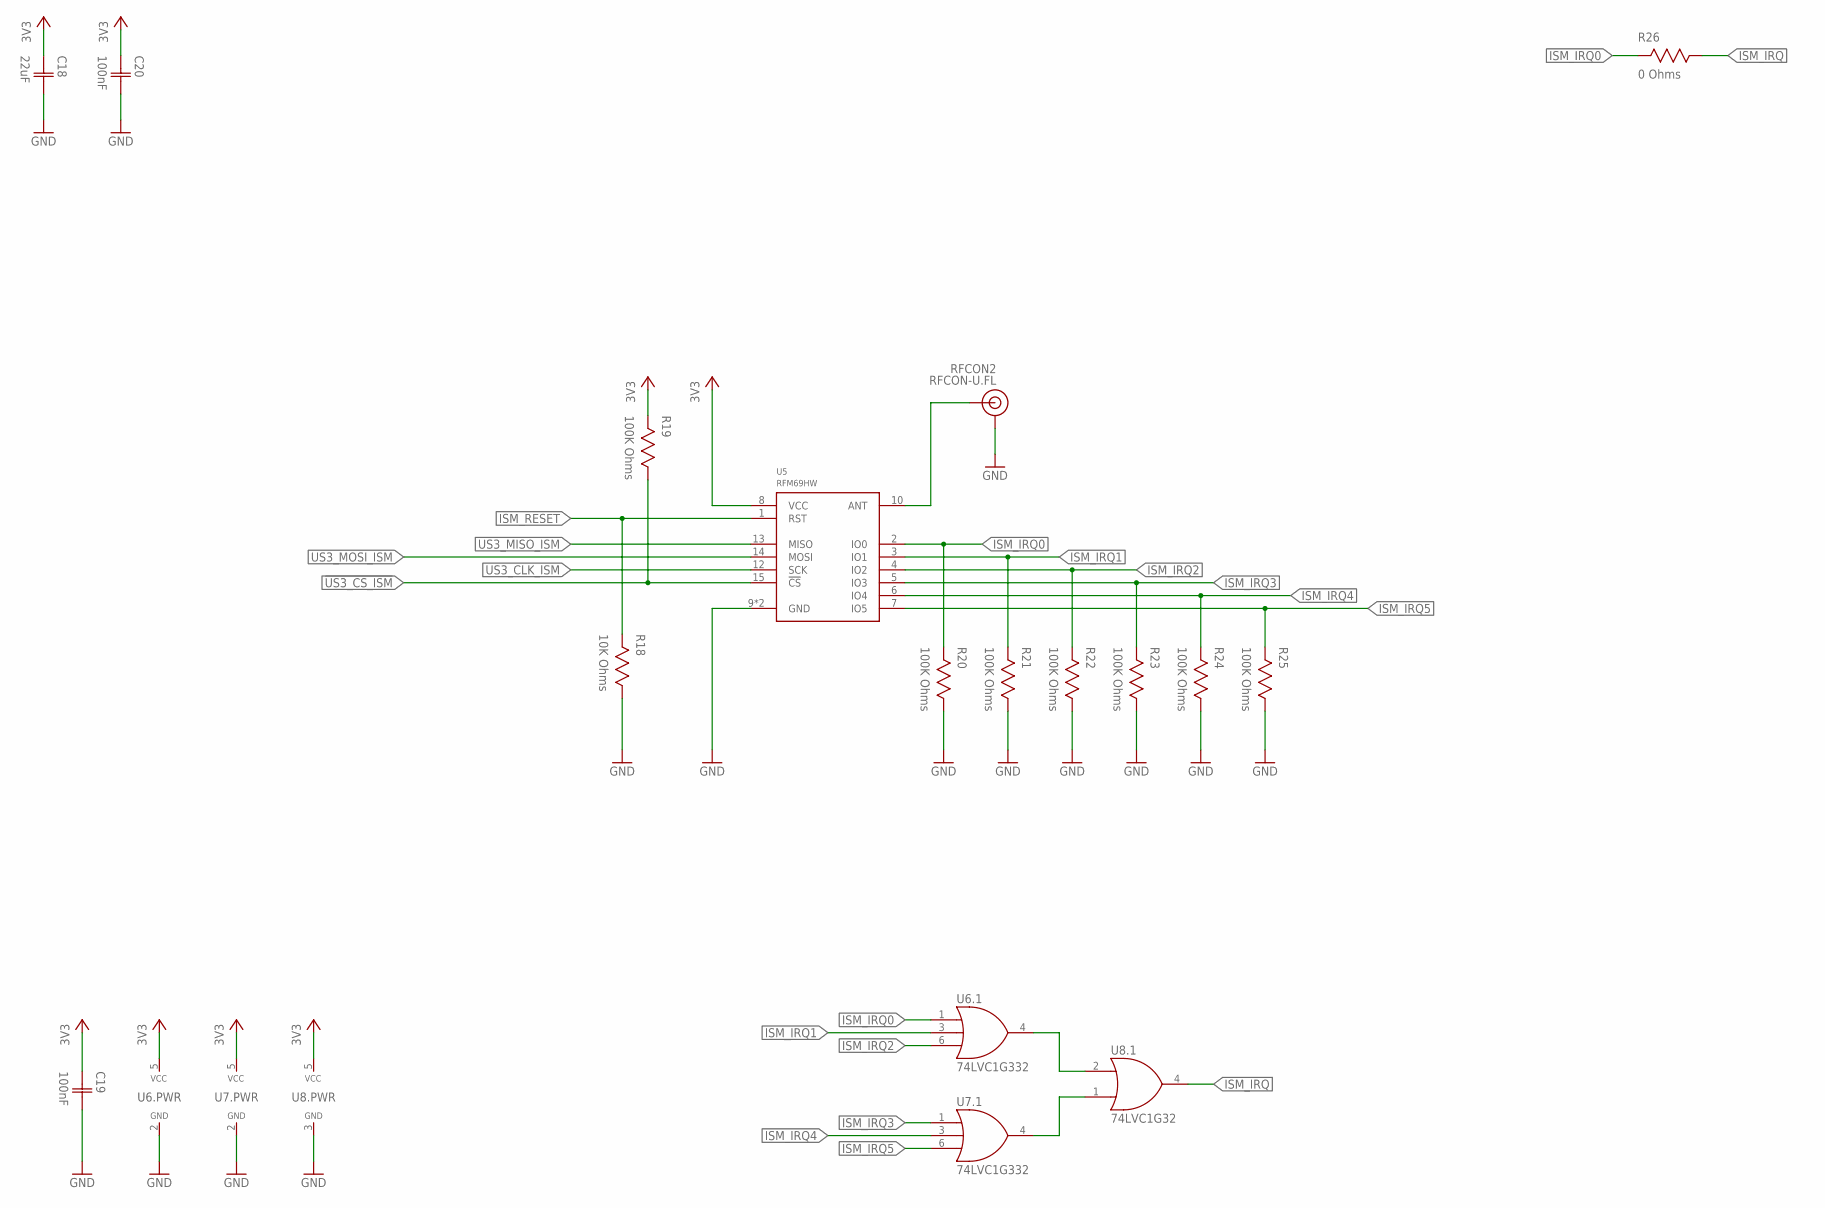
[picture p15: schematic iot-gateway-main.sch, sheet 3, ISM Radio]

Parts:
C18: 22uF; CAP1206
C19, C20: 100nF; CAP0603
R18: 10K Ohms; RES0603
R19, R20, R21, R22, R23, R24, R25: 100K Ohms; RES0603
R26: 0 Ohms; RES0603
RFCON2: RFCON-U.FL; U.FL
U5: RFM69HW; RFM69XW-XXXS2
U6, U7: 74LVC1G332; SC70-6
U8: 74LVC1G32; SC70-5

Connections:
3V3: C18.1 (C1), C19.1 (C1), C20.1 (C1), R19.2, U5.8 (VCC), U6.5 (VCC), U7.5 (VCC), U8.5 (VCC); also elsewhere on the board
!US3_CS_ISM: R19.1, U5.15 (!CS); also elsewhere on the board
GND: C18.2 (C2), C19.2 (C2), C20.2 (C2), R18.1, R20.1, R21.1, R22.1, R23.1, R24.1, R25.1, RFCON2.P$1 (GND), RFCON2.P$2 (GND), U5.9 (GND), U5.11 (GND), U6.2 (GND), U7.2 (GND), U8.3 (GND); also elsewhere on the board
ISM_IRQ: R26.1, U8.4 (Y); also elsewhere on the board
ISM_IRQ0: R20.2, R26.2, U5.2 (IO0), U6.1 (A)
ISM_IRQ1: R21.2, U5.3 (IO1), U6.3 (B)
ISM_IRQ2: R22.2, U5.4 (IO2), U6.6 (C)
ISM_IRQ3: R23.2, U5.5 (IO3), U7.1 (A)
ISM_IRQ4: R24.2, U5.6 (IO4), U7.3 (B)
ISM_IRQ5: R25.2, U5.7 (IO5), U7.6 (C)
ISM_IRQ012: U6.4 (Y), U8.2 (A)
ISM_IRQ345: U7.4 (Y), U8.1 (B)
ISM_RESET: R18.2, U5.1 (RST); also elsewhere on the board
unnamed: RFCON2.P$3 (SIGNAL), U5.10 (ANT)
US3_CLK_ISM: U5.12 (SCK); also elsewhere on the board
US3_MISO_ISM: U5.13 (MISO); also elsewhere on the board
US3_MOSI_ISM: U5.14 (MOSI); also elsewhere on the board

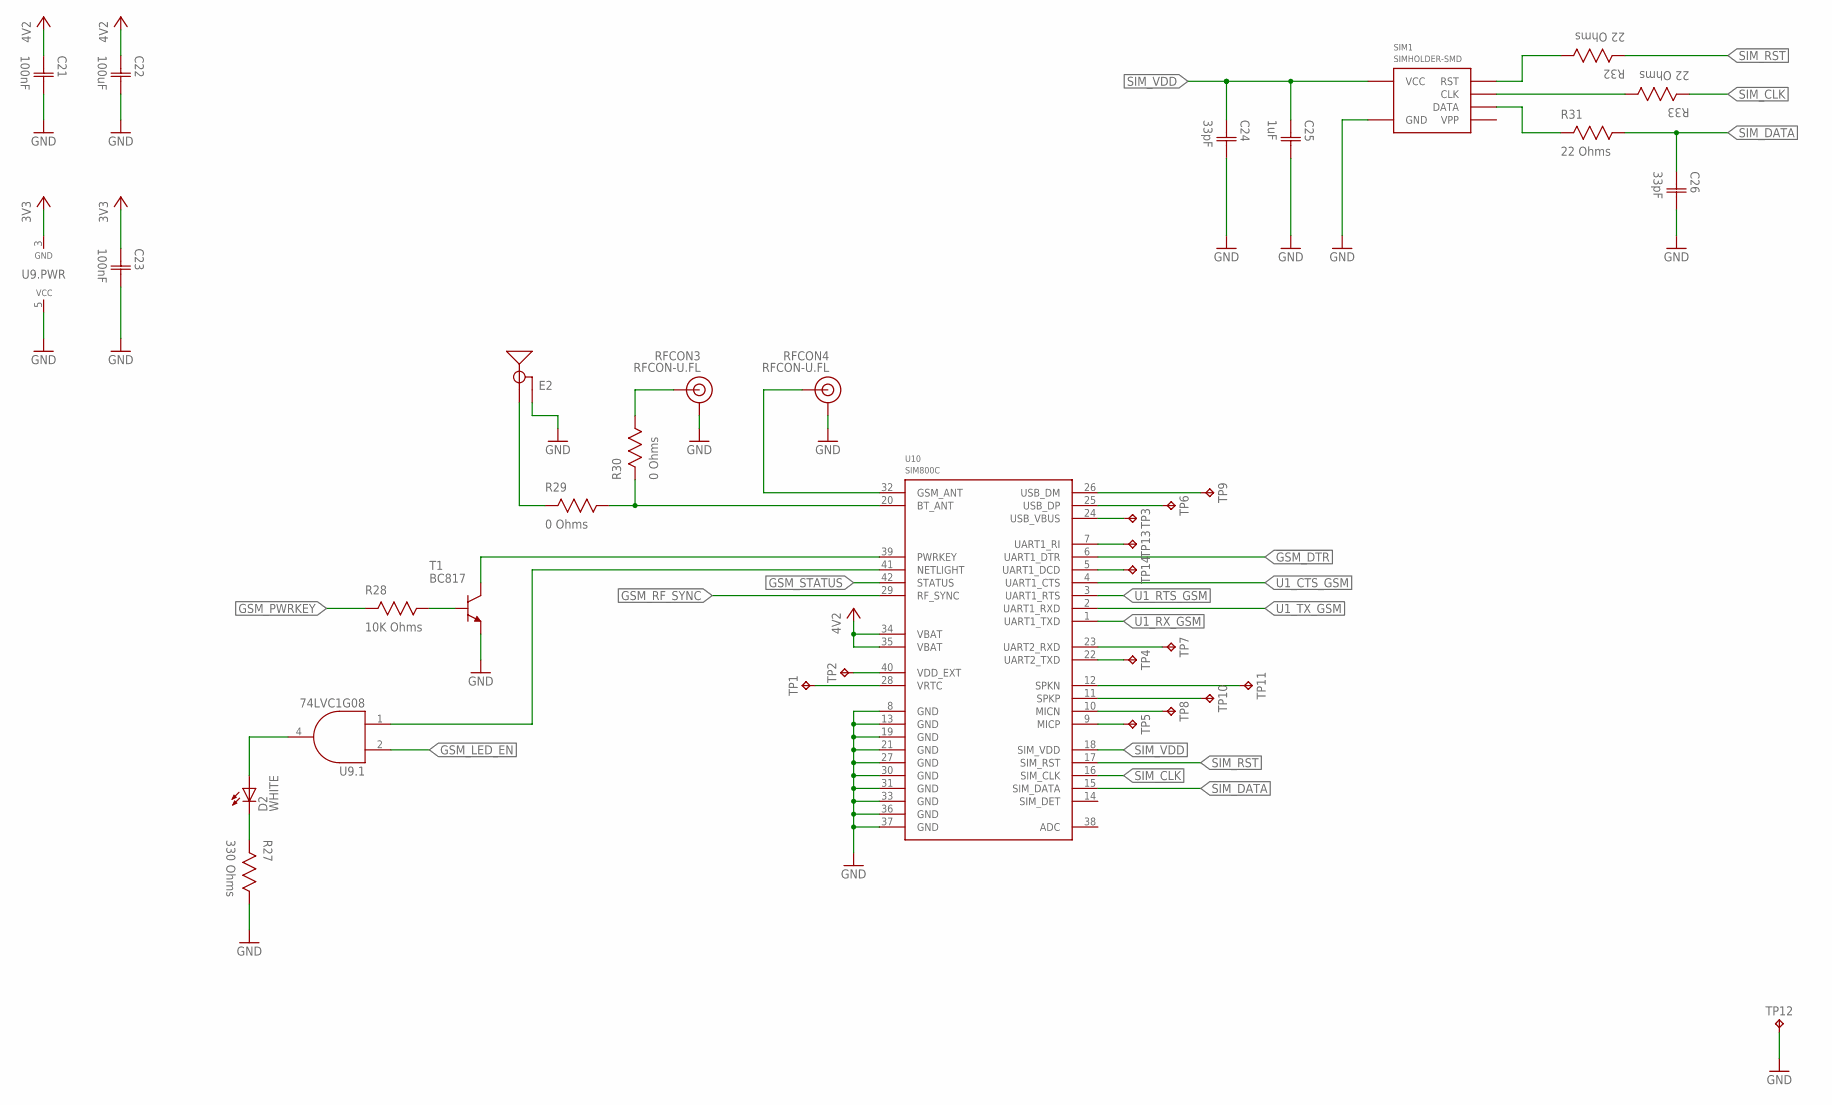
[picture p16: schematic iot-gateway-main.sch, sheet 4, GSM/Bluetooth Module]

Parts:
C21, C23: 100nF; CAP0603
C22: 100uF; CAP1206
C24, C26: 33pF; CAP0603
C25: 1uF; CAP0603
D2: WHITE; 1206_REV
E2: 2.4GHZTRACE-15.2MM; TRACE_ANTENNA_2.4GHZ_15.2MM
R27: 330 Ohms; RES0603
R28: 10K Ohms; RES0603
R29, R30: 0 Ohms; RES0603
R31, R32, R33: 22 Ohms; RES0603
RFCON3, RFCON4: RFCON-U.FL; U.FL
SIM1: SIMHOLDER-SMD
T1: BC817; SOT23
TP1, TP2, TP3, TP4, TP5, TP6, TP7, TP8, TP9, TP10, TP11, TP12, TP13, TP14: TESTPOINT-1.27MM; PAD1.27MM
U9: 74LVC1G08; SC70-5
U10: SIM800C

Connections:
3V3: C23.1 (C1), U9.3 (GND); also elsewhere on the board
4V2: C21.1 (C1), C22.1 (C1), U10.34 (VBAT), U10.35 (VBAT); also elsewhere on the board
!GSM_DCD: TP14.TP, U10.5 (UART1_DCD)
!GSM_DTR: U10.6 (UART1_DTR); also elsewhere on the board
!GSM_PWRKEY: T1.3 (C), U10.39 (PWRKEY)
!GSM_RING: TP13.TP, U10.7 (UART1_RI)
BT_ANT: R29.1, R30.2, U10.20 (BT_ANT)
BT_ANT_EXT: R30.1, RFCON3.P$3 (SIGNAL)
BT_ANT_INT: E2.ANT (SIGNAL), R29.2
GND: C21.2 (C2), C22.2 (C2), C23.2 (C2), C24.2 (C2), C25.2 (C2), C26.2 (C2), E2.GND, R27.1, RFCON3.P$1 (GND), RFCON3.P$2 (GND), RFCON4.P$1 (GND), RFCON4.P$2 (GND), SIM1.C5 (GND), T1.2 (E), TP12.TP, U9.5 (VCC), U10.8 (GND), U10.13 (GND), U10.19 (GND), U10.21 (GND), U10.27 (GND), U10.30 (GND), U10.31 (GND), U10.33 (GND), U10.36 (GND), U10.37 (GND); also elsewhere on the board
GSM_2V8: TP2.TP, U10.40 (VDD_EXT)
GSM_ANT: RFCON4.P$3 (SIGNAL), U10.32 (GSM_ANT)
GSM_LED: D2.A, U9.4 (Y)
GSM_LED_EN: U9.2 (A); also elsewhere on the board
GSM_MIC+: TP5.TP, U10.9 (MICP)
GSM_MIC-: TP8.TP, U10.10 (MICN)
GSM_NETLIGHT: U9.1 (B), U10.41 (NETLIGHT)
GSM_PWRKEY: R28.2; also elsewhere on the board
GSM_RF_SYNC: U10.29 (RF_SYNC); also elsewhere on the board
GSM_SPK+: TP10.TP, U10.11 (SPKP)
GSM_SPK-: TP11.TP, U10.12 (SPKN)
GSM_STATUS: U10.42 (STATUS); also elsewhere on the board
GSM_UART2_RX: TP7.TP, U10.23 (UART2_RXD)
GSM_UART2_TX: TP4.TP, U10.22 (UART2_TXD)
GSM_USB_D+: TP6.TP, U10.25 (USB_DP)
GSM_USB_D-: TP9.TP, U10.26 (USB_DM)
GSM_USB_VBUS: TP3.TP, U10.24 (USB_VBUS)
GSM_VRTC: TP1.TP, U10.28 (VRTC)
unnamed: D2.C, R27.2
unnamed: R28.1, T1.1 (B)
SIM_CLK: R33.2, U10.16 (SIM_CLK)
SIM_CLK_FILT: R33.1, SIM1.C3 (CLK)
SIM_DATA: C26.1 (C1), R31.1, U10.15 (SIM_DATA)
SIM_DATA_FILT: R31.2, SIM1.C7 (DATA)
SIM_RST: R32.2, U10.17 (SIM_RST)
SIM_RST_FILT: R32.1, SIM1.C2 (RST)
SIM_VDD: C24.1 (C1), C25.1 (C1), SIM1.C1 (VCC), U10.18 (SIM_VDD)
U1_CTS_GSM: U10.4 (UART1_CTS); also elsewhere on the board
U1_RTS_GSM: U10.3 (UART1_RTS); also elsewhere on the board
U1_RX_GSM: U10.1 (UART1_TXD); also elsewhere on the board
U1_TX_GSM: U10.2 (UART1_RXD); also elsewhere on the board

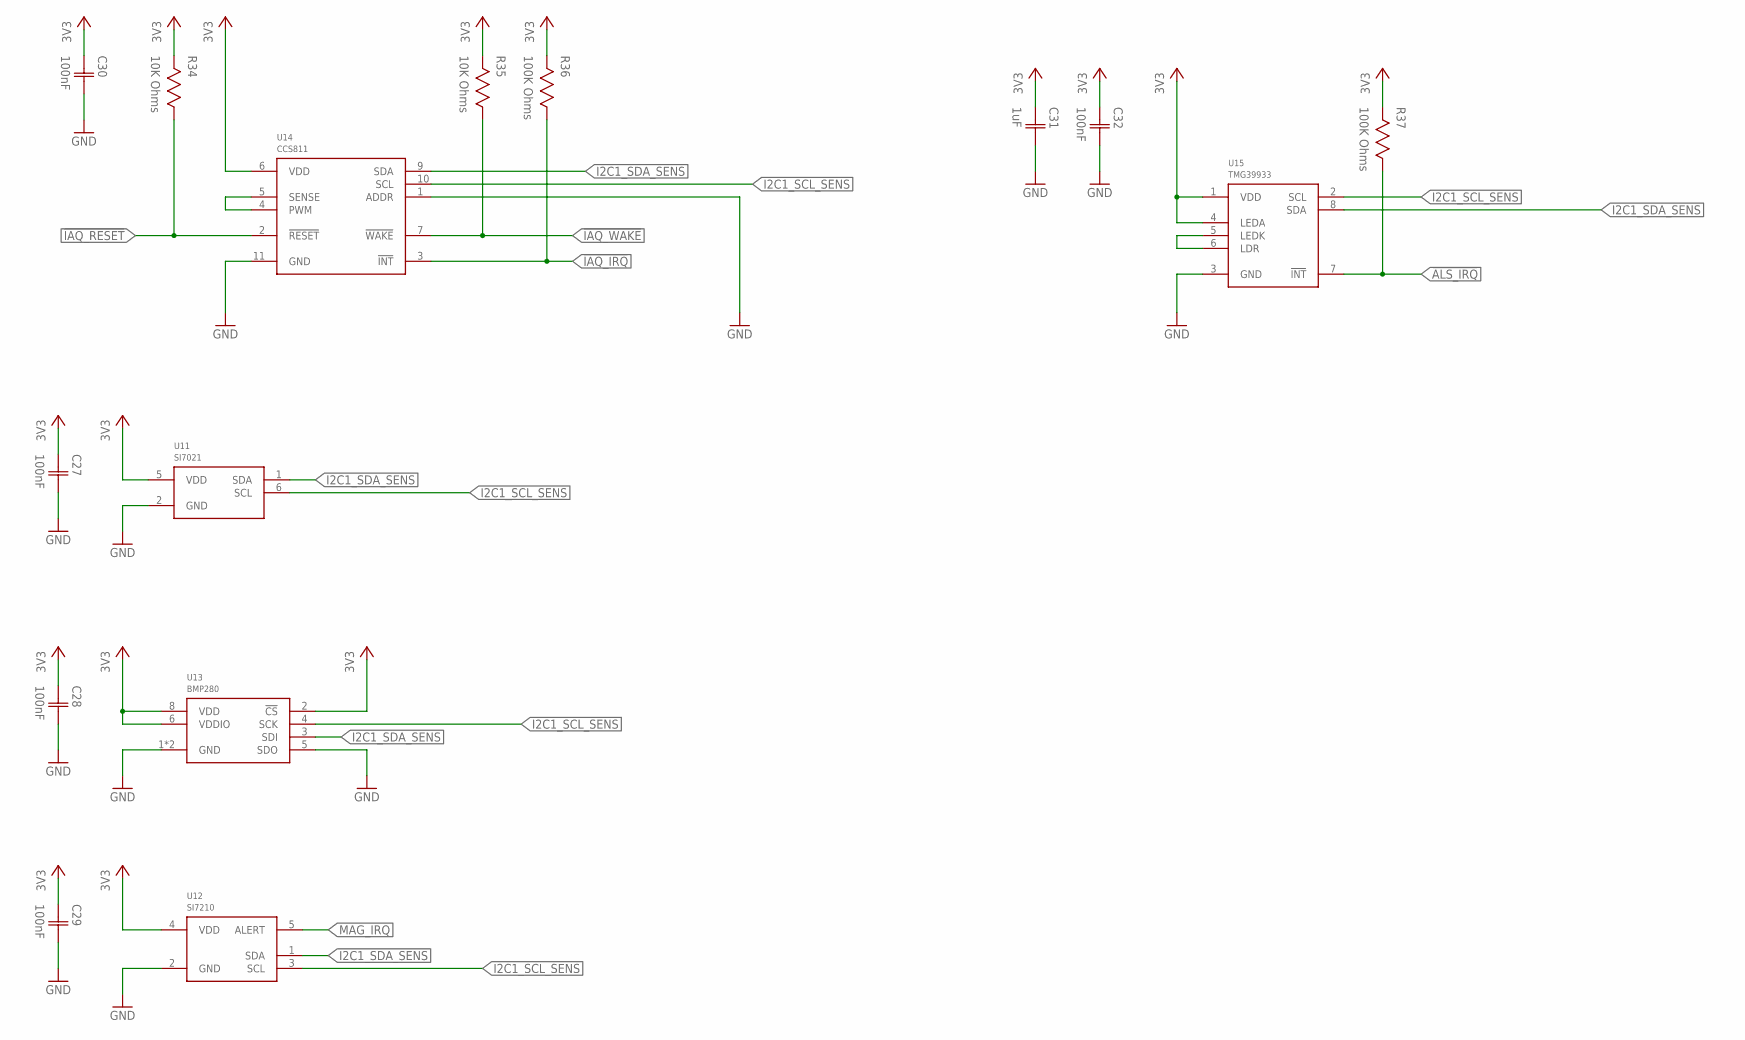
[picture p17: schematic iot-gateway-main.sch, sheet 5, Digital sensors]

Parts:
C27, C28, C29, C30, C32: 100nF; CAP0603
C31: 1uF; CAP0603
R34, R35: 10K Ohms; RES0603
R36, R37: 100K Ohms; RES0603
U11: SI7021; DFN6
U12: SI7210; SOT23-5
U13: BMP280
U14: CCS811; LGA10
U15: TMG39933; LGA8

Connections:
3V3: C27.1 (C1), C28.1 (C1), C29.1 (C1), C30.1 (C1), C31.1 (C1), C32.1 (C1), R34.2, R35.2, R36.2, R37.2, U11.5 (VDD), U12.4 (VDD), U13.2 (!CS), U13.6 (VDDIO), U13.8 (VDD), U14.6 (VDD), U15.1 (VDD), U15.4 (LEDA); also elsewhere on the board
!ALS_IRQ: R37.1, U15.7 (!INT); also elsewhere on the board
!IAQ_IRQ: R36.1, U14.3 (!INT); also elsewhere on the board
!IAQ_RESET: R34.1, U14.2 (!RESET); also elsewhere on the board
!IAQ_WAKE: R35.1, U14.7 (!WAKE); also elsewhere on the board
CCS811_HEATER_PWM: U14.4 (PWM), U14.5 (SENSE)
GND: C27.2 (C2), C28.2 (C2), C29.2 (C2), C30.2 (C2), C31.2 (C2), C32.2 (C2), U11.2 (GND), U12.2 (GND), U13.1 (GND), U13.5 (SDO), U13.7 (GND), U14.1 (ADDR), U14.11 (GND), U15.3 (GND); also elsewhere on the board
I2C1_SCL_SENS: U11.6 (SCL), U12.3 (SCL), U13.4 (SCK), U14.10 (SCL), U15.2 (SCL); also elsewhere on the board
I2C1_SDA_SENS: U11.1 (SDA), U12.1 (SDA), U13.3 (SDI), U14.9 (SDA), U15.8 (SDA); also elsewhere on the board
MAG_IRQ: U12.5 (ALERT); also elsewhere on the board
unnamed: U15.5 (LEDK), U15.6 (LDR)

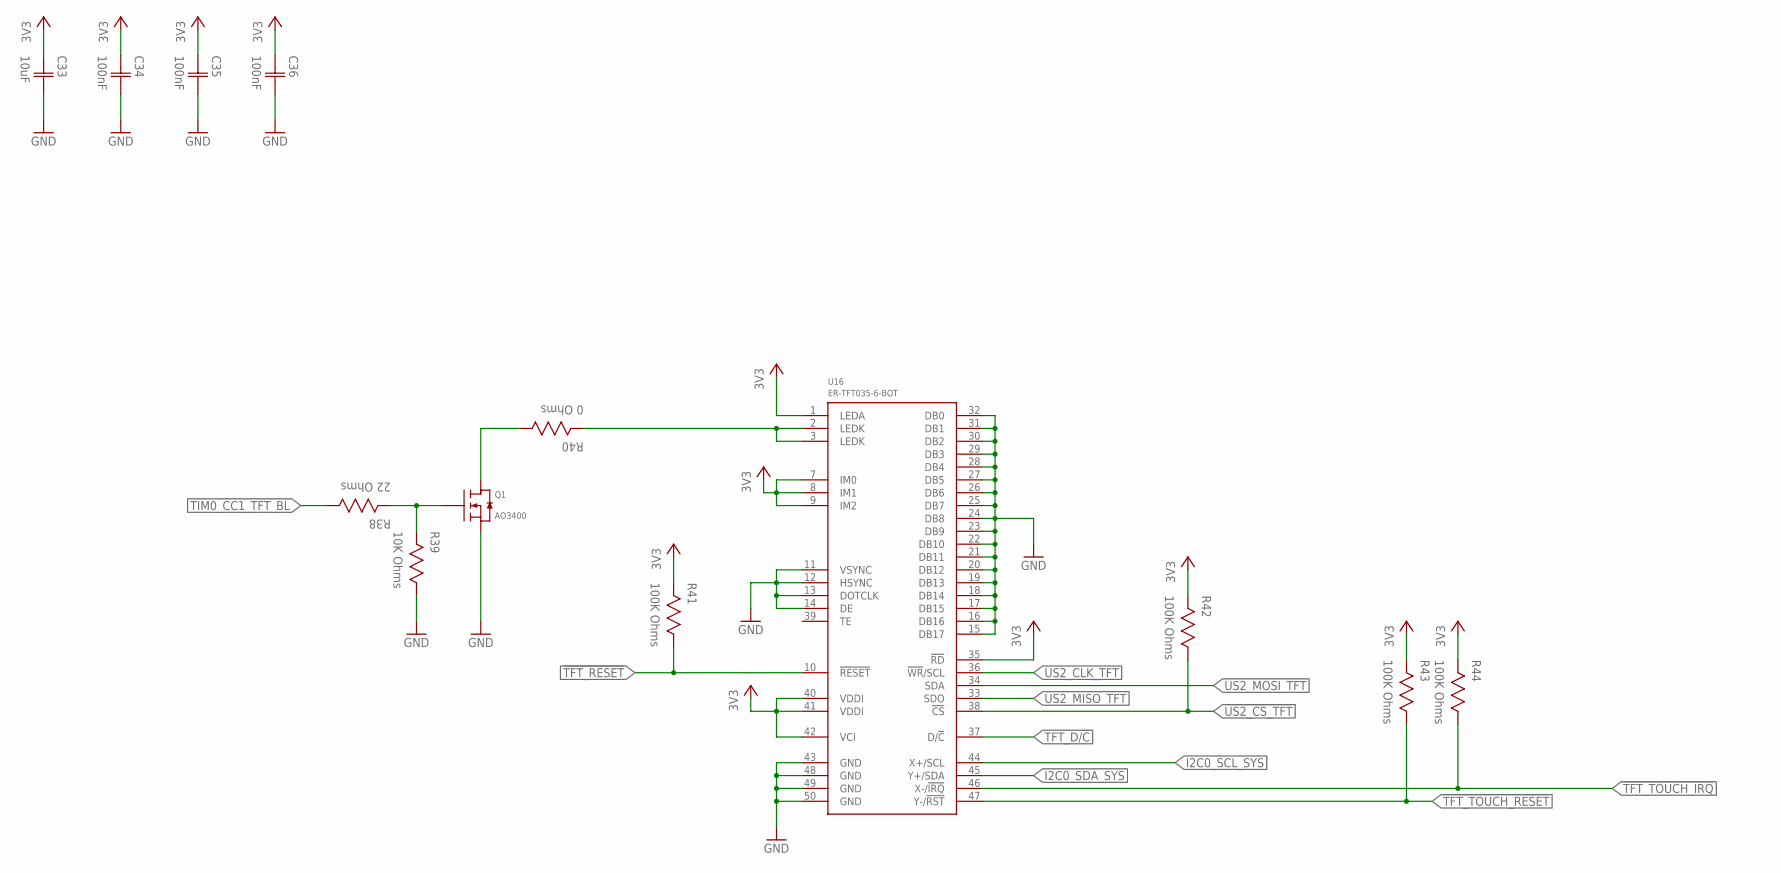
[picture p18: schematic iot-gateway-main.sch, sheet 6, TFT Display]

Parts:
C33: 10uF; CAP0603
C34, C35, C36: 100nF; CAP0603
Q1: AO3400; SOT23
R38: 22 Ohms; RES0603
R39: 10K Ohms; RES0603
R40: 0 Ohms; RES0603
R41, R42, R43, R44: 100K Ohms; RES0603
U16: ER-TFT035-6-BOT; FPC-50P-TFT-BOT

Connections:
3V3: C33.1 (C1), C34.1 (C1), C35.1 (C1), C36.1 (C1), R41.2, R42.2, R43.2, R44.2, U16.1 (LEDA), U16.7 (IM0), U16.8 (IM1), U16.9 (IM2), U16.35 (!RD), U16.40 (VDDI), U16.41 (VDDI), U16.42 (VCI); also elsewhere on the board
!TFT_RESET: R41.1, U16.10 (!RESET); also elsewhere on the board
!TFT_TOUCH_IRQ: R44.1, U16.46 (X-/!IRQ!); also elsewhere on the board
!TFT_TOUCH_RESET: R43.1, U16.47 (Y-/!RST!); also elsewhere on the board
!US2_CS_TFT: R42.1, U16.38 (!CS); also elsewhere on the board
GND: C33.2 (C2), C34.2 (C2), C35.2 (C2), C36.2 (C2), Q1.2 (S), R39.1, U16.11 (VSYNC), U16.12 (HSYNC), U16.13 (DOTCLK), U16.14 (DE), U16.15 (DB17), U16.16 (DB16), U16.17 (DB15), U16.18 (DB14), U16.19 (DB13), U16.20 (DB12), U16.21 (DB11), U16.22 (DB10), U16.23 (DB9), U16.24 (DB8), U16.25 (DB7), U16.26 (DB6), U16.27 (DB5), U16.28 (DB4), U16.29 (DB3), U16.30 (DB2), U16.31 (DB1), U16.32 (DB0), U16.43 (GND), U16.48 (GND), U16.49 (GND), U16.50 (GND); also elsewhere on the board
I2C0_SCL_SYS: U16.44 (X+/SCL); also elsewhere on the board
I2C0_SDA_SYS: U16.45 (Y+/SDA); also elsewhere on the board
unnamed: Q1.1 (G), R38.2, R39.2
TFT_BACKLIGHT_DRIVER: Q1.3 (D), R40.1
TFT_BACKLIGHT_PWM: R40.2, U16.2 (LEDK), U16.3 (LEDK)
TFT_D/!C!: U16.37 (D/!C!); also elsewhere on the board
TIM0_CC1_TFT_BL: R38.1; also elsewhere on the board
US2_CLK_TFT: U16.36 (!WR!/SCL); also elsewhere on the board
US2_MISO_TFT: U16.33 (SDO); also elsewhere on the board
US2_MOSI_TFT: U16.34 (SDA); also elsewhere on the board
