pepetech/iot-gateway/pcb/main/iot-gateway-main.brd

## EAGLE design pcb/main/iot-gateway-main.brd (continued)

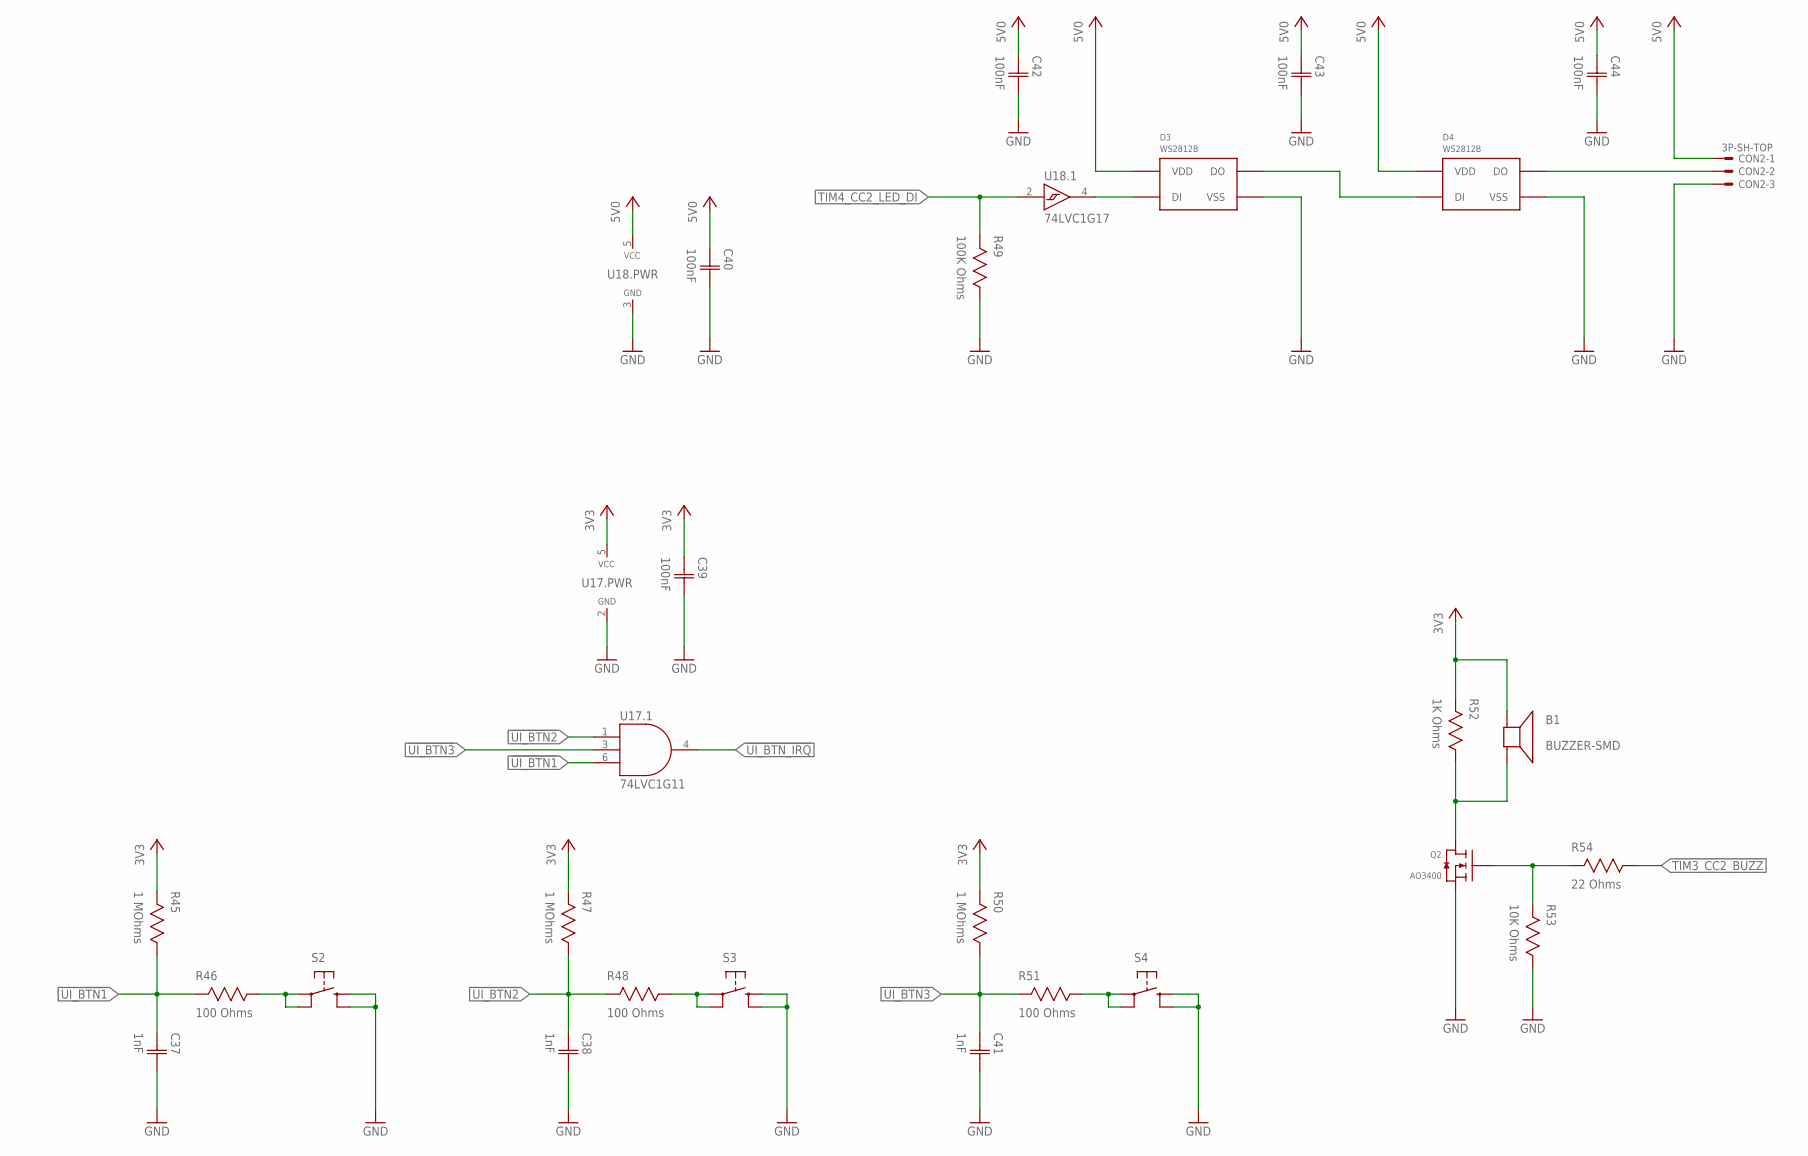
[picture p19: schematic iot-gateway-main.sch, sheet 7, User Interface]

Parts:
B1: BUZZER-SMD; SMD
C37, C38, C41: 1nF; CAP0603
C39, C40, C42, C43, C44: 100nF; CAP0603
CON2: 3P-SH-TOP; SH-03-TOP
D3, D4: WS2812B; WS2812B-SMD5050
Q2: AO3400; SOT23
R45, R47, R50: 1 MOhms; RES0603
R46, R48, R51: 100 Ohms; RES0603
R49: 100K Ohms; RES0603
R52: 1K Ohms; RES0603
R53: 10K Ohms; RES0603
R54: 22 Ohms; RES0603
S2, S3, S4: TAC_SWITCHSMD_4.5X4.5; TAC_SW_SMD_4.5X4.5
U17: 74LVC1G11; SC70-6
U18: 74LVC1G17; SC70-5

Connections:
3V3: B1.1 (+), C39.1 (C1), R45.2, R47.2, R50.2, R52.2, U17.5 (VCC); also elsewhere on the board
5V0: C40.1 (C1), C42.1 (C1), C43.1 (C1), C44.1 (C1), CON2.1, D3.1 (VDD), D4.1 (VDD), U18.5 (VCC); also elsewhere on the board
!UI_BTN1: C37.1 (C1), R45.1, R46.2, U17.6 (C); also elsewhere on the board
!UI_BTN2: C38.1 (C1), R47.1, R48.2, U17.1 (A); also elsewhere on the board
!UI_BTN3: C41.1 (C1), R50.1, R51.2, U17.3 (B); also elsewhere on the board
!UI_BTN_IRQ: U17.4 (Y); also elsewhere on the board
BUZZ_DRV: B1.2 (-), Q2.3 (D), R52.1
EXT_LED_DI: CON2.2, D4.2 (DO)
GND: C37.2 (C2), C38.2 (C2), C39.2 (C2), C40.2 (C2), C41.2 (C2), C42.2 (C2), C43.2 (C2), C44.2 (C2), CON2.3, D3.3 (VSS), D4.3 (VSS), Q2.2 (S), R49.1, R53.1, S2.3, S2.4, S3.3, S3.4, S4.3, S4.4, U17.2 (GND), U18.3 (GND); also elsewhere on the board
LED1_DI: D3.4 (DI), U18.4 (Y)
LED2_DI: D3.2 (DO), D4.4 (DI)
unnamed: Q2.1 (G), R53.2, R54.2
unnamed: R46.1, S2.1, S2.2
unnamed: R51.1, S4.1, S4.2
unnamed: R48.1, S3.1, S3.2
TIM3_CC2_BUZZ: R54.1; also elsewhere on the board
TIM4_CC2_LED_DI: R49.2, U18.2 (A); also elsewhere on the board

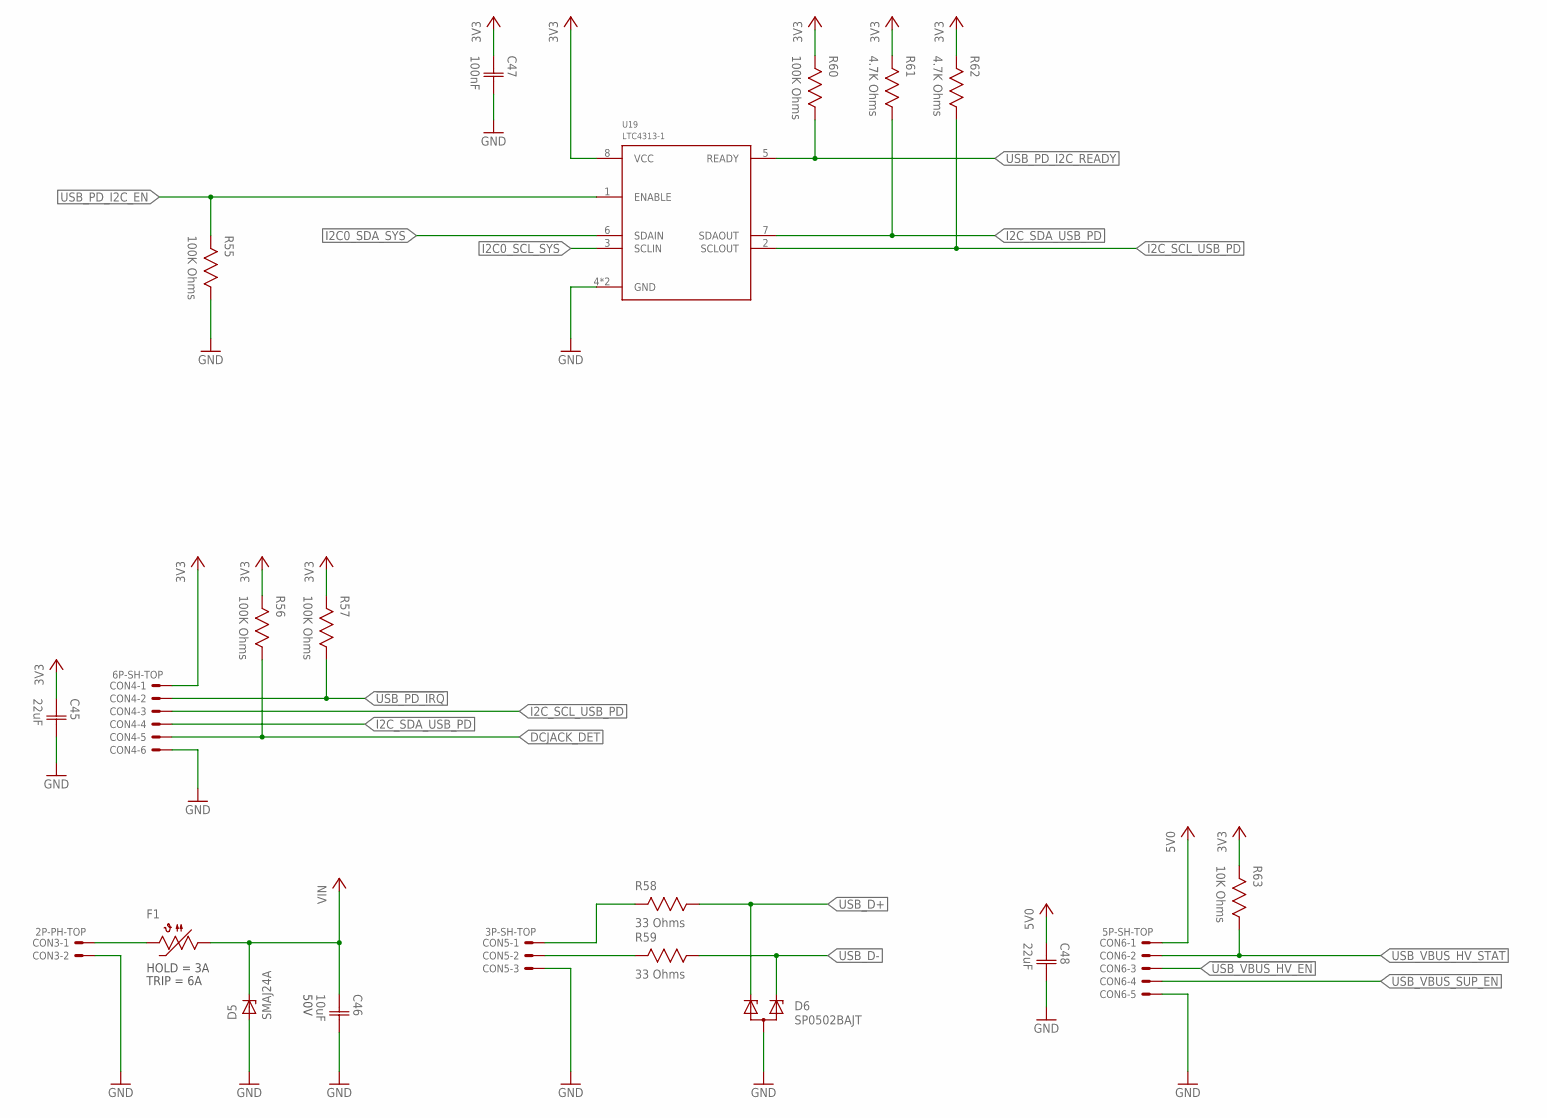
[picture p20: schematic iot-gateway-main.sch, sheet 8, USB/Power Interface]

Parts:
C45, C48: 22uF; CAP1206
C46: 10uF; CAP1206; VOLTAGE 50V
C47: 100nF; CAP0603
CON3: 2P-PH-TOP; PH-02-TOP
CON4: 6P-SH-TOP; SH-06-TOP
CON5: 3P-SH-TOP; SH-03-TOP
CON6: 5P-SH-TOP; SH-05-TOP
D5: SMAJ24A; DO214AC
D6: SP0502BAJT; SC70-3
F1: 2.6A Hold; 1206
R55, R56, R57, R60: 100K Ohms; RES0603
R58, R59: 33 Ohms; RES0603
R61, R62: 4.7K Ohms; RES0603
R63: 10K Ohms; RES0603
U19: LTC4313-1; DFN8

Connections:
3V3: C45.1 (C1), C47.1 (C1), CON4.1, R56.2, R57.2, R60.2, R61.2, R62.2, R63.2, U19.8 (VCC); also elsewhere on the board
5V0: C48.1 (C1), CON6.1; also elsewhere on the board
!USB_PD_IRQ: CON4.2, R57.1; also elsewhere on the board
!USB_VBUS_HV_EN: CON6.3; also elsewhere on the board
DCJACK_DET: CON4.5, R56.1; also elsewhere on the board
GND: C45.2 (C2), C46.2 (C2), C47.2 (C2), C48.2 (C2), CON3.2, CON4.6, CON5.3, CON6.5, D5.A, D6.3 (A), R55.1, U19.4 (GND), U19.9 (GND); also elsewhere on the board
I2C0_SCL_SYS: U19.3 (SCLIN); also elsewhere on the board
I2C0_SDA_SYS: U19.6 (SDAIN); also elsewhere on the board
I2C_SCL_USB_PD: CON4.3, R62.1, U19.2 (SCLOUT)
I2C_SDA_USB_PD: CON4.4, R61.1, U19.7 (SDAOUT)
unnamed: CON5.2, R59.2
unnamed: CON5.1, R58.2
USB_D+: D6.1 (C1), R58.1; also elsewhere on the board
USB_D-: D6.2 (C2), R59.1; also elsewhere on the board
USB_PD_I2C_EN: R55.2, U19.1 (ENABLE); also elsewhere on the board
USB_PD_I2C_READY: R60.1, U19.5 (READY); also elsewhere on the board
USB_VBUS_HV_STAT: CON6.2, R63.1; also elsewhere on the board
USB_VBUS_SUP_EN: CON6.4; also elsewhere on the board
VIN: C46.1 (C1), D5.C, F1.1; also elsewhere on the board
VIN_UNFUSED: CON3.1, F1.2

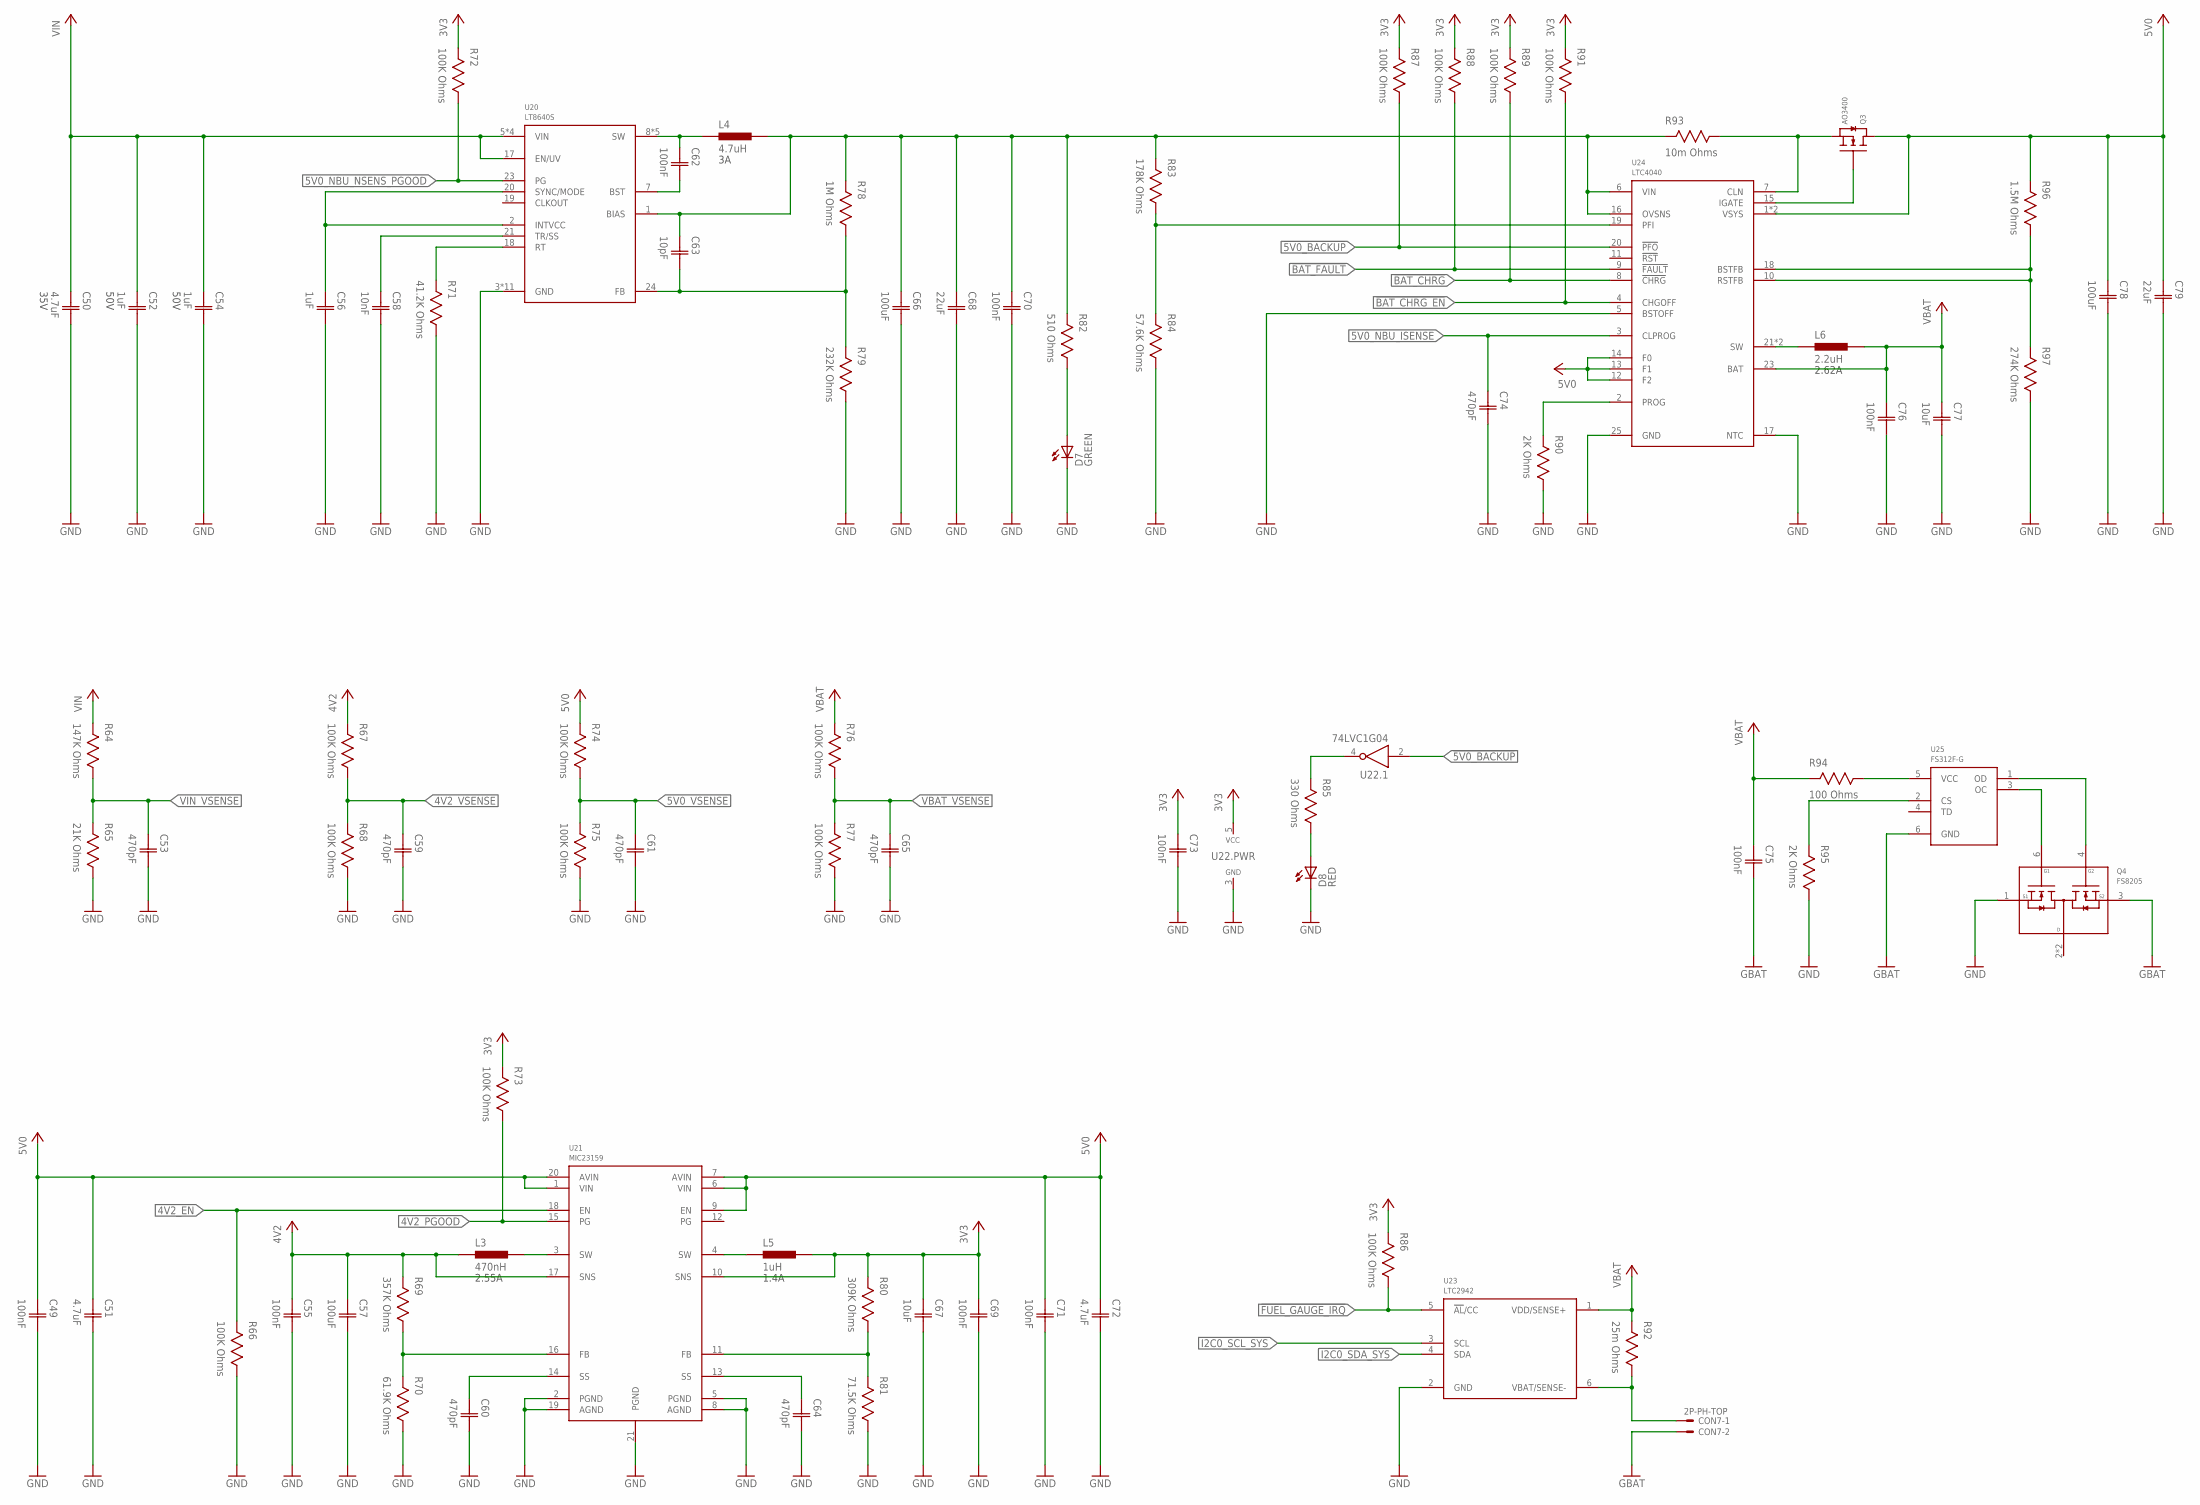
[picture p21: schematic iot-gateway-main.sch, sheet 9, Power Management]

Parts:
C49, C55, C62, C69, C70, C71, C73, C75, C76: 100nF; CAP0603
C50: 4.7uF; CAP0603; VOLTAGE 35V
C51, C72: 4.7uF; CAP0603
C52, C54: 1uF; CAP0603; VOLTAGE 50V
C53, C59, C60, C61, C64, C65, C74: 470pF; CAP0603
C56: 1uF; CAP0603
C57, C66, C78: 100uF; CAP1206
C58: 10nF; CAP0603
C63: 10pF; CAP0603
C67, C77: 10uF; CAP0603
C68, C79: 22uF; CAP1206
CON7: 2P-PH-TOP; PH-02-TOP
D7: LED1206-REV; 1206_REV
D8: RED; 1206_REV
L3: 470nH; IND3225
L4: 4.7uH; IND0606
L5: 1uH; IND0805
L6: 2.2uH; IND0505
Q3: AO3400; SOT23
Q4: FS8205; SOT23-6
R64: 147K Ohms; RES0603
R65: 21K Ohms; RES0603
R66, R67, R68, R72, R73, R74, R75, R76, R77, R86, R87, R88, R89, R91: 100K Ohms; RES0603
R69: 357K Ohms; RES0603
R70: 61.9K Ohms; RES0603
R71: 41.2K Ohms; RES0603
R78: 1M Ohms; RES0603
R79: 232K Ohms; RES0603
R80: 309K Ohms; RES0603
R81: 71.5K Ohms; RES0603
R82: 510 Ohms; RES0603
R83: 178K Ohms; RES0603
R84: 57.6K Ohms; RES0603
R85: 330 Ohms; RES0603
R90, R95: 2K Ohms; RES0603
R92: 25m Ohms; RES1206
R93: 10m Ohms; RES1206
R94: 100 Ohms; RES0603
R96: 1.5M Ohms; RES0603
R97: 274K Ohms; RES0603
U20: LT8640S; QFN24_CORNER
U21: MIC23159; VQFN20
U22: 74LVC1G04; SC70-5
U23: LTC2942; DFN6
U24: LTC4040; QFN24_ASYM
U25: FS312F-G; SOT23-6

Connections:
3V3: C67.1 (C1), C69.1 (C1), C73.1 (C1), L5.2, R72.2, R73.2, R80.2, R86.2, R87.2, R88.2, R89.2, R91.2, U21.10 (SNS), U22.5 (VCC); also elsewhere on the board
3V3_FB: R80.1, R81.2, U21.11 (FB)
3V3_SS: C64.1 (C1), U21.13 (SS)
3V3_SW: L5.1, U21.4 (SW)
4V2: C55.1 (C1), C57.1 (C1), L3.1, R67.2, R69.2, U21.17 (SNS); also elsewhere on the board
4V2_EN: R66.2, U21.18 (EN); also elsewhere on the board
4V2_FB: R69.1, R70.2, U21.16 (FB)
4V2_PGOOD: R73.1, U21.15 (PG); also elsewhere on the board
4V2_SS: C60.1 (C1), U21.14 (SS)
4V2_SW: L3.2, U21.3 (SW)
4V2_VSENSE: C59.1 (C1), R67.1, R68.2; also elsewhere on the board
5V0: C49.1 (C1), C51.1 (C1), C71.1 (C1), C72.1 (C1), C78.1 (C1), C79.1 (C1), Q3.3 (D), R74.2, R96.2, U21.1 (VIN), U21.6 (VIN), U21.7 (AVIN), U21.9 (EN), U21.20 (AVIN), U24.1 (VSYS), U24.12 (F2), U24.13 (F1), U24.14 (F0), U24.24 (VSYS); also elsewhere on the board
5V0_BACKUP: R85.2, U22.4 (Y)
5V0_FB: R96.1, R97.2, U24.10 (RSTFB), U24.18 (BSTFB)
5V0_GATE: Q3.1 (G), U24.15 (IGATE)
5V0_NBU: Q3.2 (S), R93.1, U24.7 (CLN)
5V0_NBU_ISENSE: C74.1 (C1), U24.3 (CLPROG); also elsewhere on the board
5V0_NBU_NSENS: C63.1 (C1), C66.1 (C1), C68.1 (C1), C70.1 (C1), L4.2, R78.2, R82.2, R83.2, R93.2, U20.1 (BIAS), U24.6 (VIN), U24.16 (OVSNS)
5V0_NBU_NSENS_BST: C62.2 (C2), U20.7 (BST)
5V0_NBU_NSENS_FB: C63.2 (C2), R78.1, R79.2, U20.24 (FB)
5V0_NBU_NSENS_INTVCC: C56.1 (C1), U20.2 (INTVCC), U20.20 (SYNC/MODE)
5V0_NBU_NSENS_PGOOD: R72.1, U20.23 (PG); also elsewhere on the board
5V0_NBU_NSENS_RT: R71.2, U20.18 (RT)
5V0_NBU_NSENS_SS: C58.1 (C1), U20.21 (TR/SS)
5V0_NBU_NSENS_SW: C62.1 (C1), L4.1, U20.8 (SW), U20.9 (SW), U20.10 (SW), U20.11 (SW), U20.12 (SW)
5V0_VSENSE: C61.1 (C1), R74.1, R75.2; also elsewhere on the board
!5V0_BACKUP: R87.1, U22.2 (A), U24.20 (!PFO); also elsewhere on the board
!BAT_CHRG: R89.1, U24.8 (!CHRG); also elsewhere on the board
!BAT_CHRG_EN: R91.1, U24.4 (CHGOFF); also elsewhere on the board
!BAT_FAULT: R88.1, U24.9 (!FAULT); also elsewhere on the board
!FUEL_GAUGE_IRQ: R86.1, U23.5 (!AL!/CC); also elsewhere on the board
BAT_CHRG_PROG: R90.2, U24.2 (PROG)
BAT_OC: Q4.6 (G1), U25.3 (OC)
BAT_OD: Q4.4 (G2), U25.1 (OD)
BAT_PROT_CS: R95.2, U25.2 (CS)
BAT_PROT_VCC: R94.1, U25.5 (VCC)
GBAT: C75.2 (C2), CON7.2, Q4.3 (S2), U25.6 (GND)
GND: C49.2 (C2), C50.2 (C2), C51.2 (C2), C52.2 (C2), C53.2 (C2), C54.2 (C2), C55.2 (C2), C56.2 (C2), C57.2 (C2), C58.2 (C2), C59.2 (C2), C60.2 (C2), C61.2 (C2), C64.2 (C2), C65.2 (C2), C66.2 (C2), C67.2 (C2), C68.2 (C2), C69.2 (C2), C70.2 (C2), C71.2 (C2), C72.2 (C2), C73.2 (C2), C74.2 (C2), C76.2 (C2), C77.2 (C2), C78.2 (C2), C79.2 (C2), D7.C, D8.C, Q4.1 (S1), R65.1, R66.1, R68.1, R70.1, R71.1, R75.1, R77.1, R79.1, R81.1, R84.1, R90.1, R95.1, R97.1, U20.3 (GND), U20.16 (GND), U20.22 (GND), U20.25 (GND), U20.26 (GND), U20.27 (GND), U20.28 (GND), U20.29 (GND), U20.30 (GND), U20.31 (GND), U20.32 (GND), U21.2 (PGND), U21.5 (PGND), U21.8 (AGND), U21.19 (AGND), U21.21 (PGND), U22.3 (GND), U23.2 (GND), U24.5 (BSTOFF), U24.17 (NTC), U24.25 (GND); also elsewhere on the board
I2C0_SCL_SYS: U23.3 (SCL); also elsewhere on the board
I2C0_SDA_SYS: U23.4 (SDA); also elsewhere on the board
unnamed: D7.A, R82.1
unnamed: D8.A, R85.1
PF_THRESH: R83.1, R84.2, U24.19 (PFI)
VBAT: C75.1 (C1), C76.1 (C1), C77.1 (C1), L6.2, R76.2, R92.2, R94.2, U23.1 (VDD/SENSE+), U24.23 (BAT)
VBAT_NSENS: CON7.1, R92.1, U23.6 (VBAT/SENSE-)
VBAT_SW: L6.1, U24.21 (SW), U24.22 (SW)
VBAT_VSENSE: C65.1 (C1), R76.1, R77.2; also elsewhere on the board
VIN: C50.1 (C1), C52.1 (C1), C54.1 (C1), R64.2, U20.5 (VIN), U20.6 (VIN), U20.13 (VIN), U20.14 (VIN), U20.17 (EN/UV); also elsewhere on the board
VIN_VSENSE: C53.1 (C1), R64.1, R65.2; also elsewhere on the board

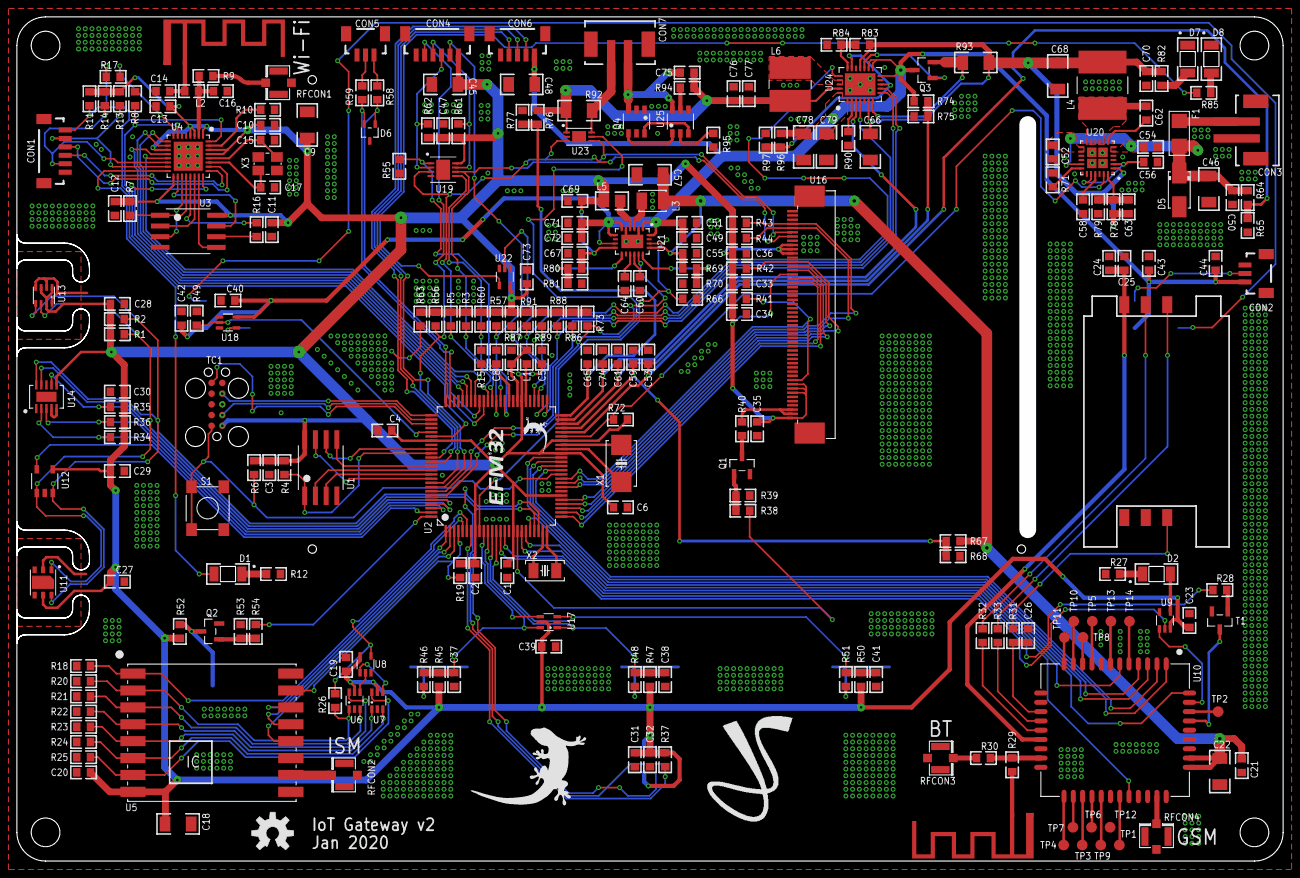
[picture p22: board iot-gateway-main.brd from above]

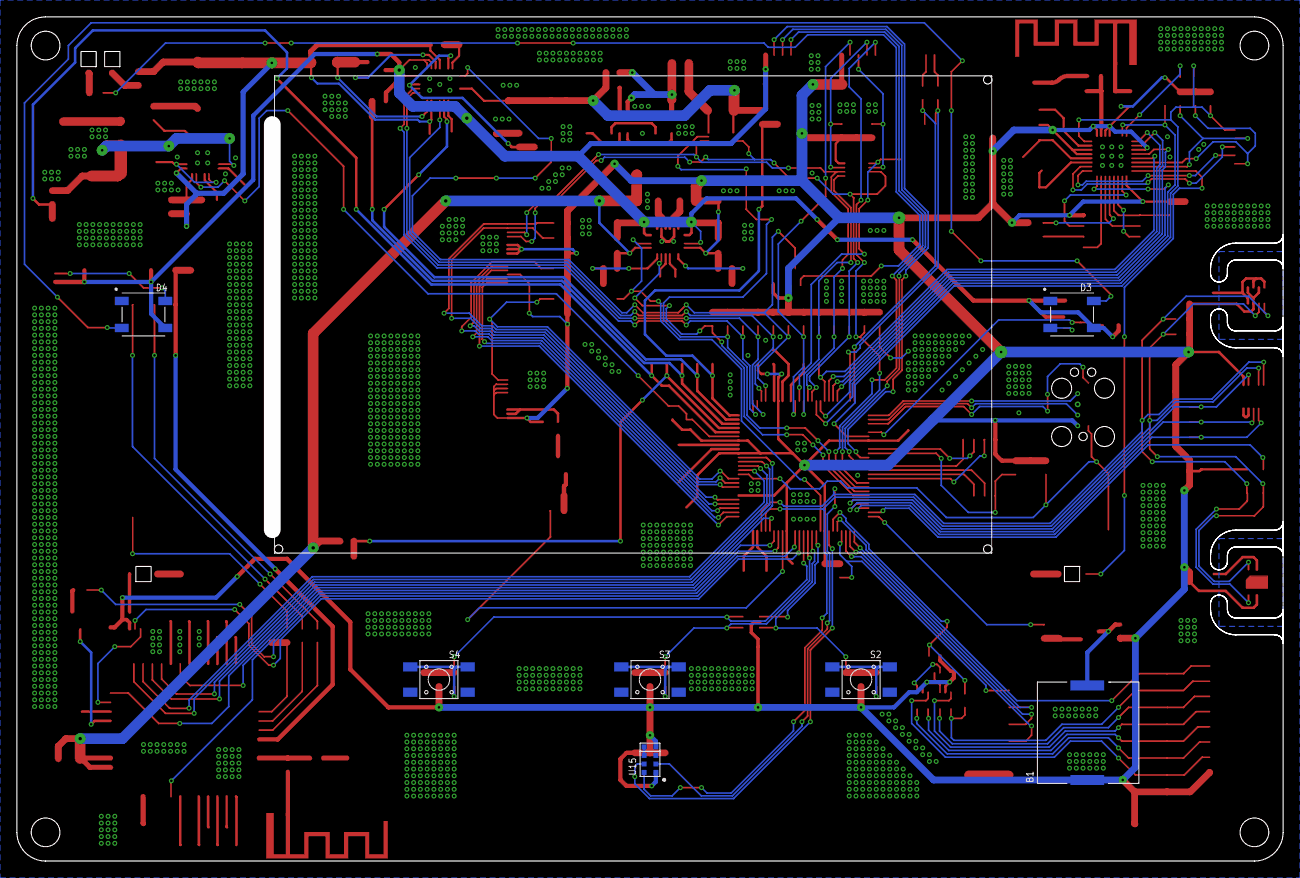
[picture p23: board iot-gateway-main.brd from below]

Board: 2 copper layers, 150.0 x 100.0 mm, 261 parts (8 on the bottom side), 195 nets.
