pepetech/iot-gateway/pcb/usb-pd/iot-gateway-usb-pd.brd

## EAGLE design pcb/usb-pd/iot-gateway-usb-pd.brd (2019-12-28)

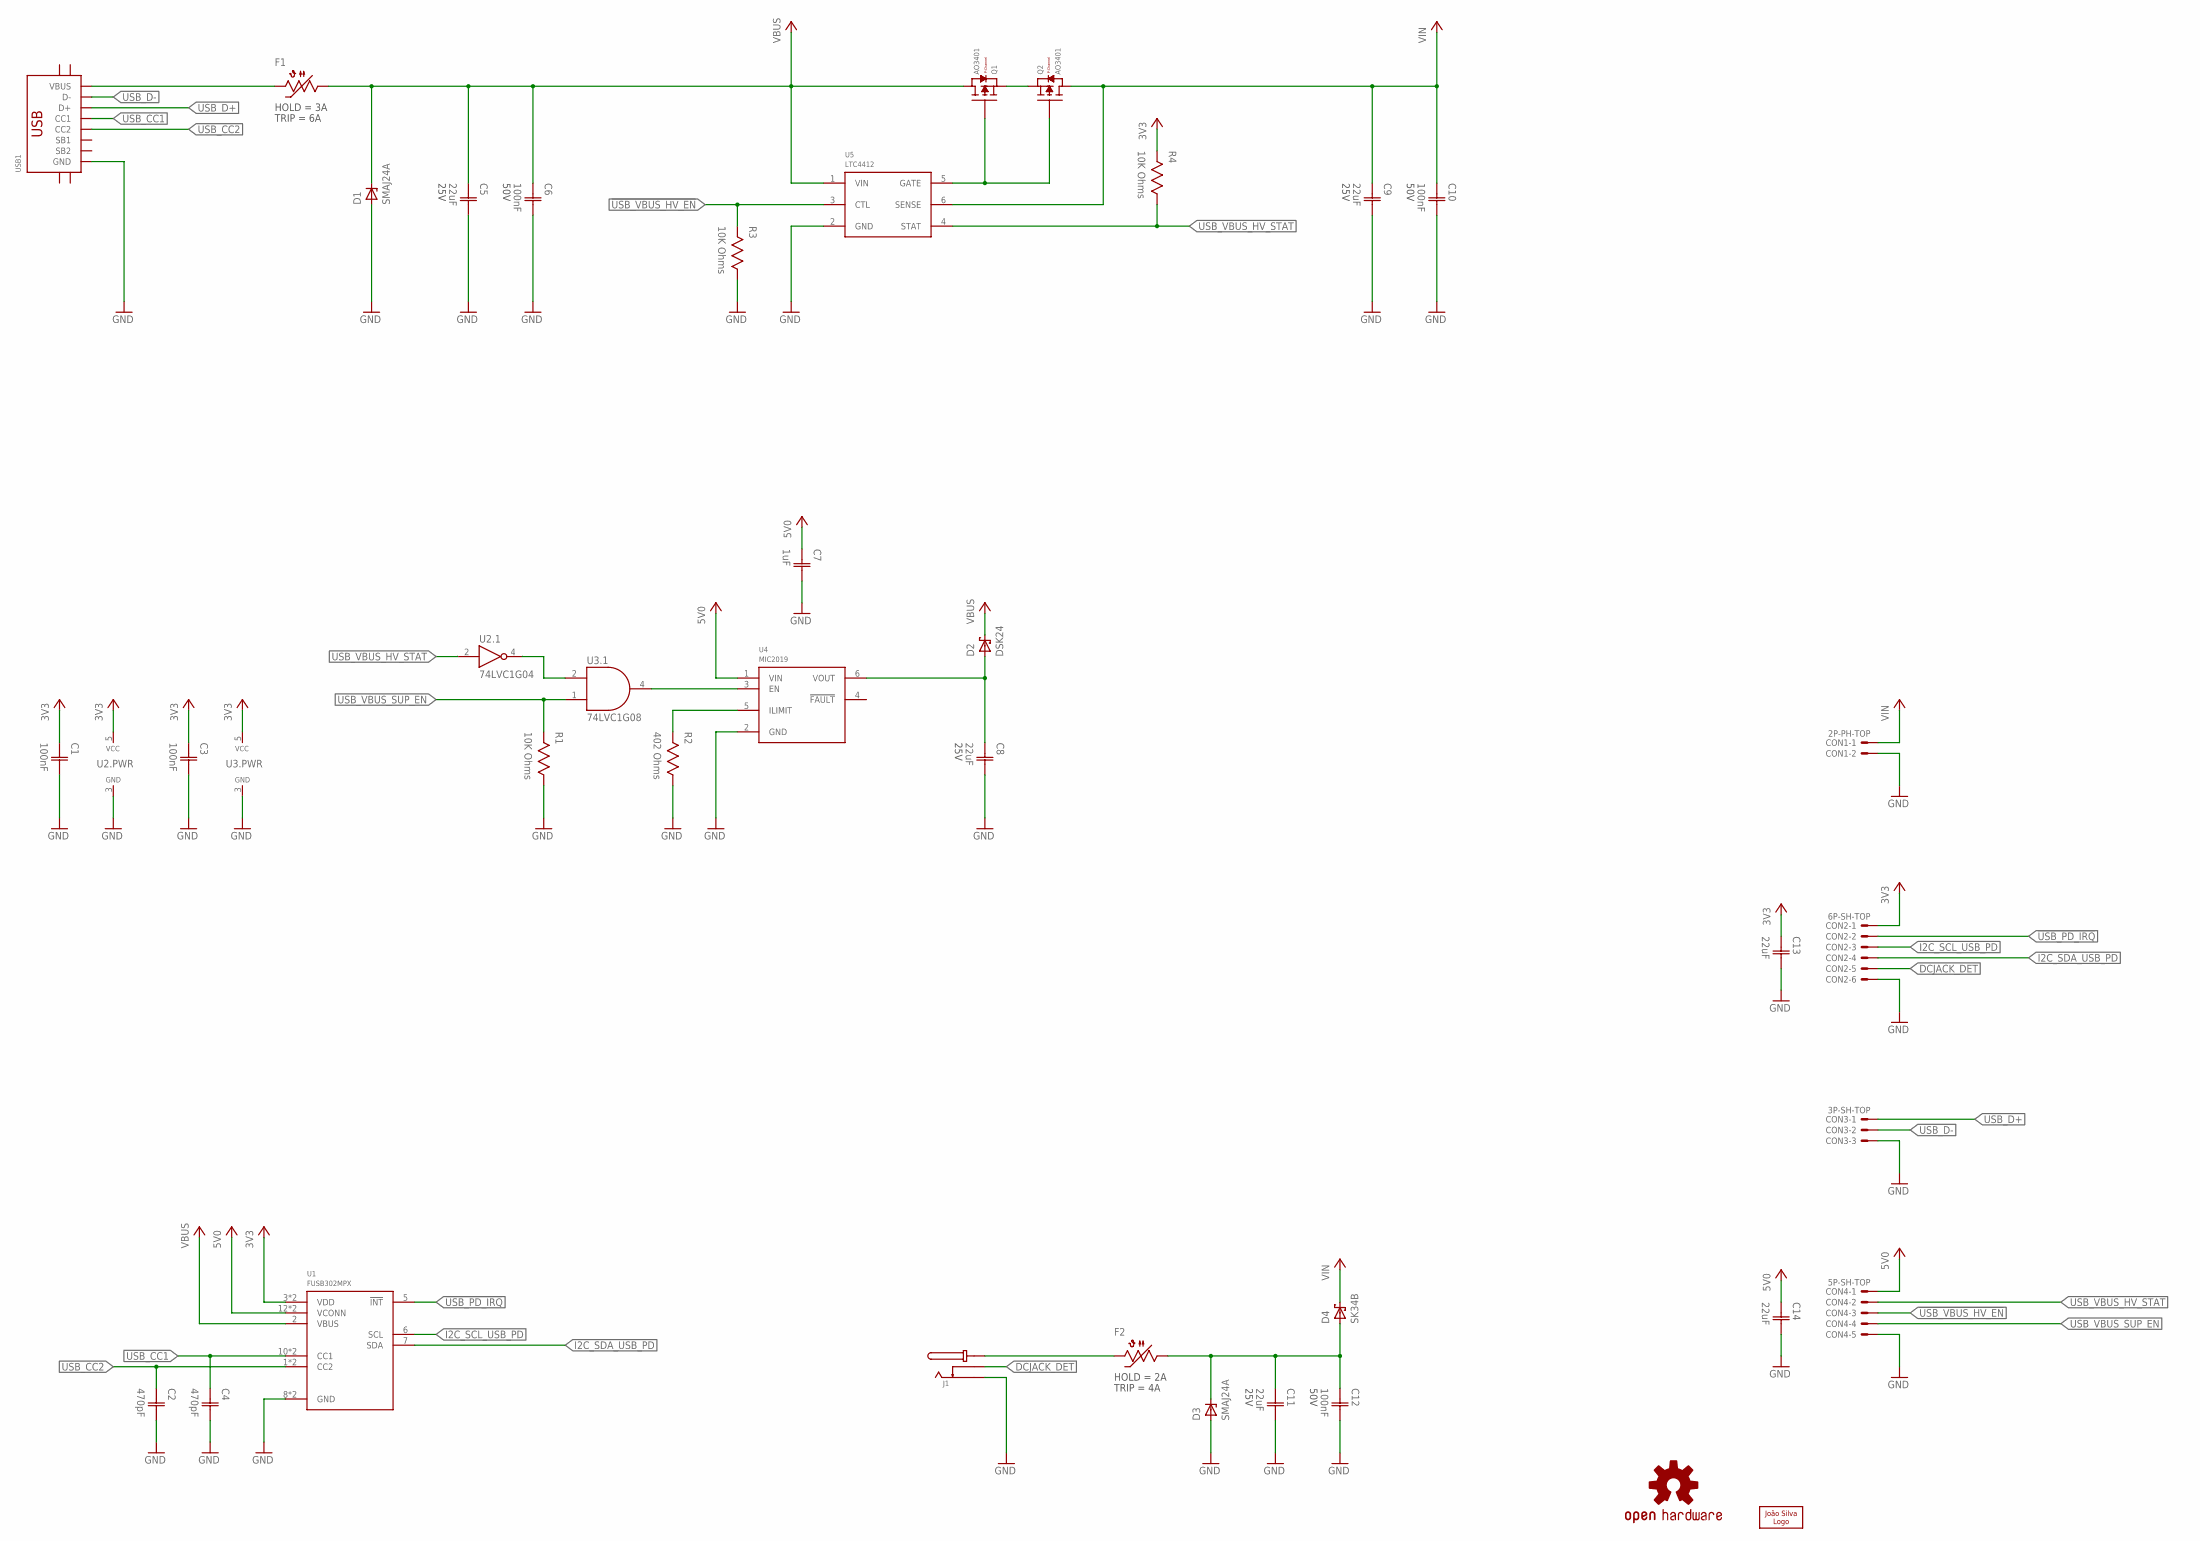
[picture p24: schematic iot-gateway-usb-pd.sch]

Parts:
C1, C3: 100nF; CAP0603
C2, C4: 470pF; CAP0603
C5, C8, C9, C11: 22uF; CAP1206; VOLTAGE 25V
C6, C10, C12: 100nF; CAP0603; VOLTAGE 50V
C7: 1uF; CAP0603
C13, C14: 22uF; CAP1206
CON1: 2P-PH-TOP; PH-02-TOP
CON2: 6P-SH-TOP; SH-06-TOP
CON3: 3P-SH-TOP; SH-03-TOP
CON4: 5P-SH-TOP; SH-05-TOP
D1, D3: SMAJ24A; DO214AC
D2: DSK24; SOD-123F
D4: SK34B; DO214AA
F1, F2: PTC1206; 1206
J1: DCJACK; DC-050
LOGO1: OSHW-LOGOS; OSHW-LOGO-S
LOGO2: JS-5MM; JS_5MM
Q1, Q2: AO3401; SOT23
R1, R3, R4: 10K Ohms; RES0603
R2: 402 Ohms; RES0603
U1: FUSB302MPX; QFN14
U2: 74LVC1G04; SC70-5
U3: 74LVC1G08; SC70-5
U4: MIC2019; SOT23-6
U5: LTC4412; SOT23-6
USB1: USB-C-16P-SMD-FLAT-SIDE-TYPE-2

Connections:
3V3: C1.1 (C1), C3.1 (C1), C13.1 (C1), CON2.1, R4.2, U1.3 (VDD), U1.4 (VDD), U2.5 (VCC), U3.5 (VCC)
5V0: C7.1 (C1), C14.1 (C1), CON4.1, U1.12 (VCONN), U1.13 (VCONN), U4.1 (VIN)
!USB_PD_IRQ: CON2.2, U1.5 (!INT)
!USB_VBUS_HV_EN: CON4.3, R3.2, U5.3 (CTL)
!USB_VBUS_HV_STAT: U2.4 (Y), U3.2 (A)
DCJACK_DET: CON2.5, J1.DT
GND: C1.2 (C2), C2.2 (C2), C3.2 (C2), C4.2 (C2), C5.2 (C2), C6.2 (C2), C7.2 (C2), C8.2 (C2), C9.2 (C2), C10.2 (C2), C11.2 (C2), C12.2 (C2), C13.2 (C2), C14.2 (C2), CON1.2, CON2.6, CON3.3, CON4.5, D1.A, D3.A, J1.O, R1.1, R2.1, R3.1, U1.8 (GND), U1.9 (GND), U2.3 (GND), U3.3 (GND), U4.2 (GND), U5.2 (GND), USB1.A1/B12 (GND), USB1.B1/A12 (GND)
I2C_SCL_USB_PD: CON2.3, U1.6 (SCL)
I2C_SDA_USB_PD: CON2.4, U1.7 (SDA)
unnamed: Q1.2 (S), Q2.2 (S)
unnamed: Q1.1 (G), Q2.1 (G), U5.5 (GATE)
unnamed: R2.2, U4.5 (ILIMIT)
USB_CC1: C4.1 (C1), U1.10 (CC1), U1.11 (CC1), USB1.A5 (CC1)
USB_CC2: C2.1 (C1), U1.1 (CC2), U1.14 (CC2), USB1.B5 (CC2)
USB_D+: CON3.1, USB1.A6 (D+), USB1.B6 (D+)
USB_D-: CON3.2, USB1.A7 (D-), USB1.B7 (D-)
USB_VBUS_HV_STAT: CON4.2, R4.1, U2.2 (A), U5.4 (STAT)
USB_VBUS_SUP_EN: CON4.4, R1.2, U3.1 (B)
USB_VBUS_SUP_EN_Q: U3.4 (Y), U4.3 (EN)
VBUS: C5.1 (C1), C6.1 (C1), D1.C, D2.C, F1.1, Q1.3 (D), U1.2 (VBUS), U5.1 (VIN)
VBUS_SRC: C8.1 (C1), D2.A, U4.6 (VOUT)
VBUS_UNFUSED: F1.2, USB1.A4/B9 (VBUS), USB1.B4/A9 (VBUS)
VIN: C9.1 (C1), C10.1 (C1), CON1.1, D4.C, Q2.3 (D), U5.6 (SENSE)
VJACK: C11.1 (C1), C12.1 (C1), D3.C, D4.A, F2.1
VJACK_UNFUSED: F2.2, J1.C, J1.C' (C)

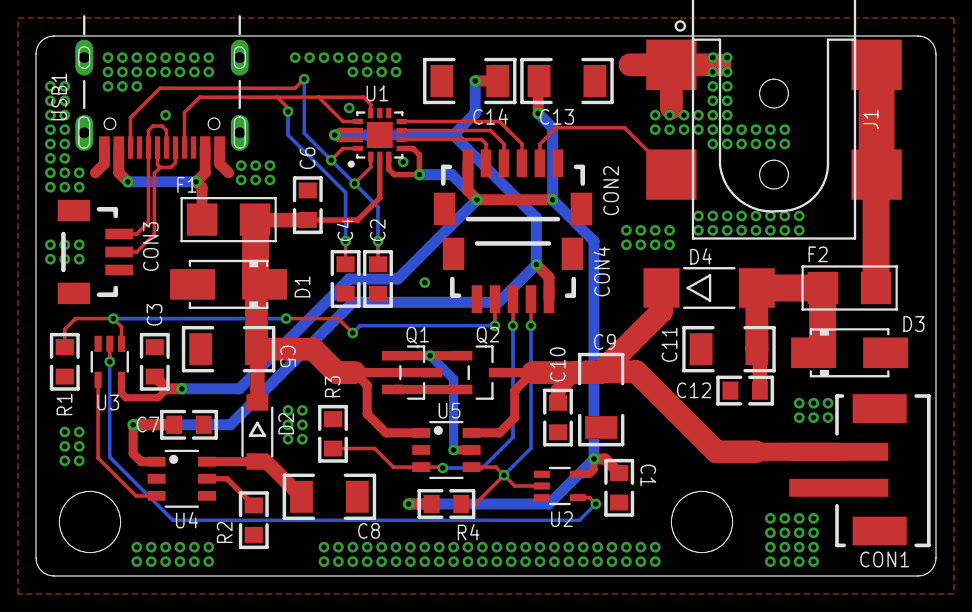
[picture p25: board iot-gateway-usb-pd.brd from above]

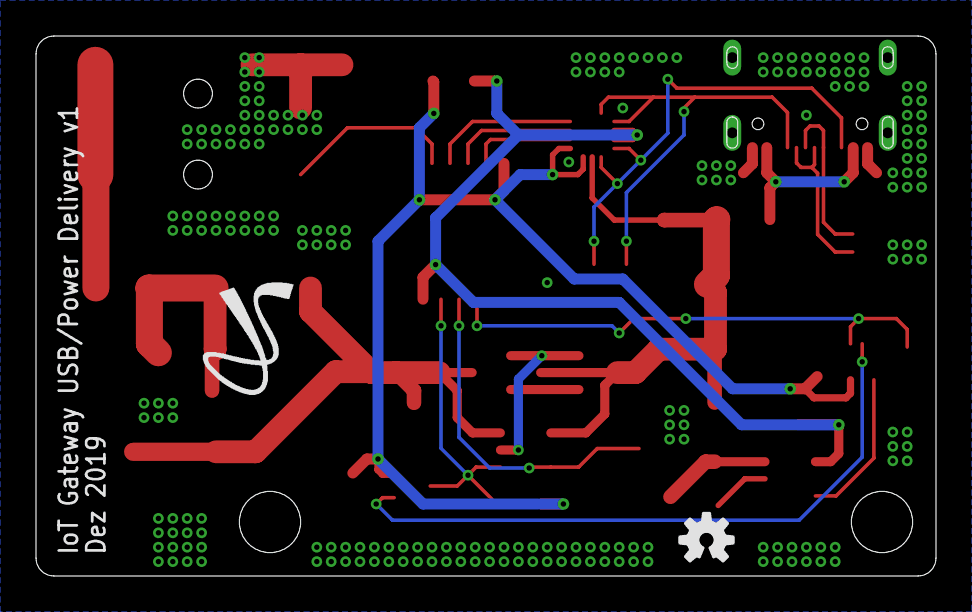
[picture p26: board iot-gateway-usb-pd.brd from below]

Board: 2 copper layers, 50.0 x 30.0 mm, 39 parts (2 on the bottom side), 25 nets.
