pepetech/iot-gateway/pcb/iot-gateway.brd

## EAGLE design pcb/iot-gateway.brd (2019-12-14)

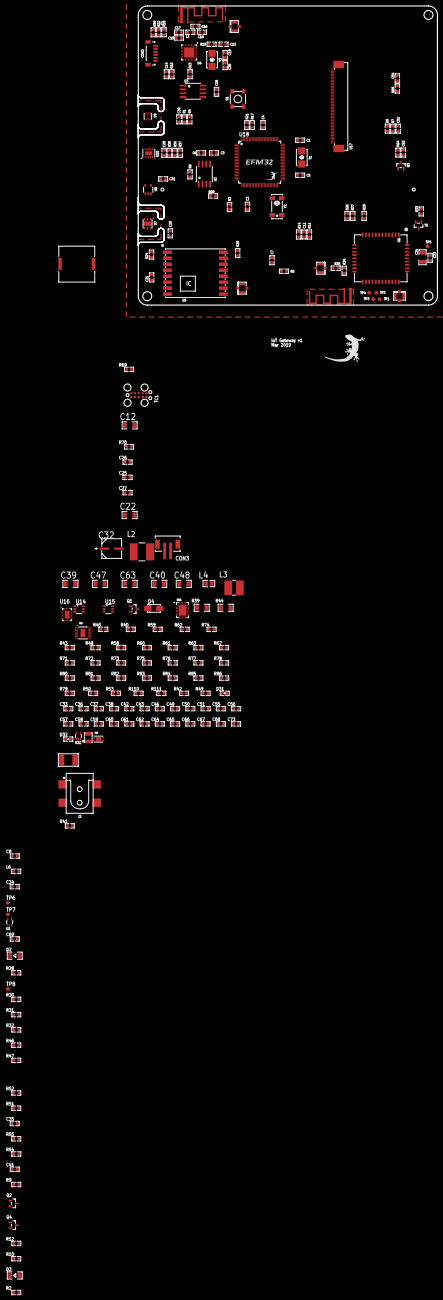
[picture p27: board iot-gateway.brd from above]

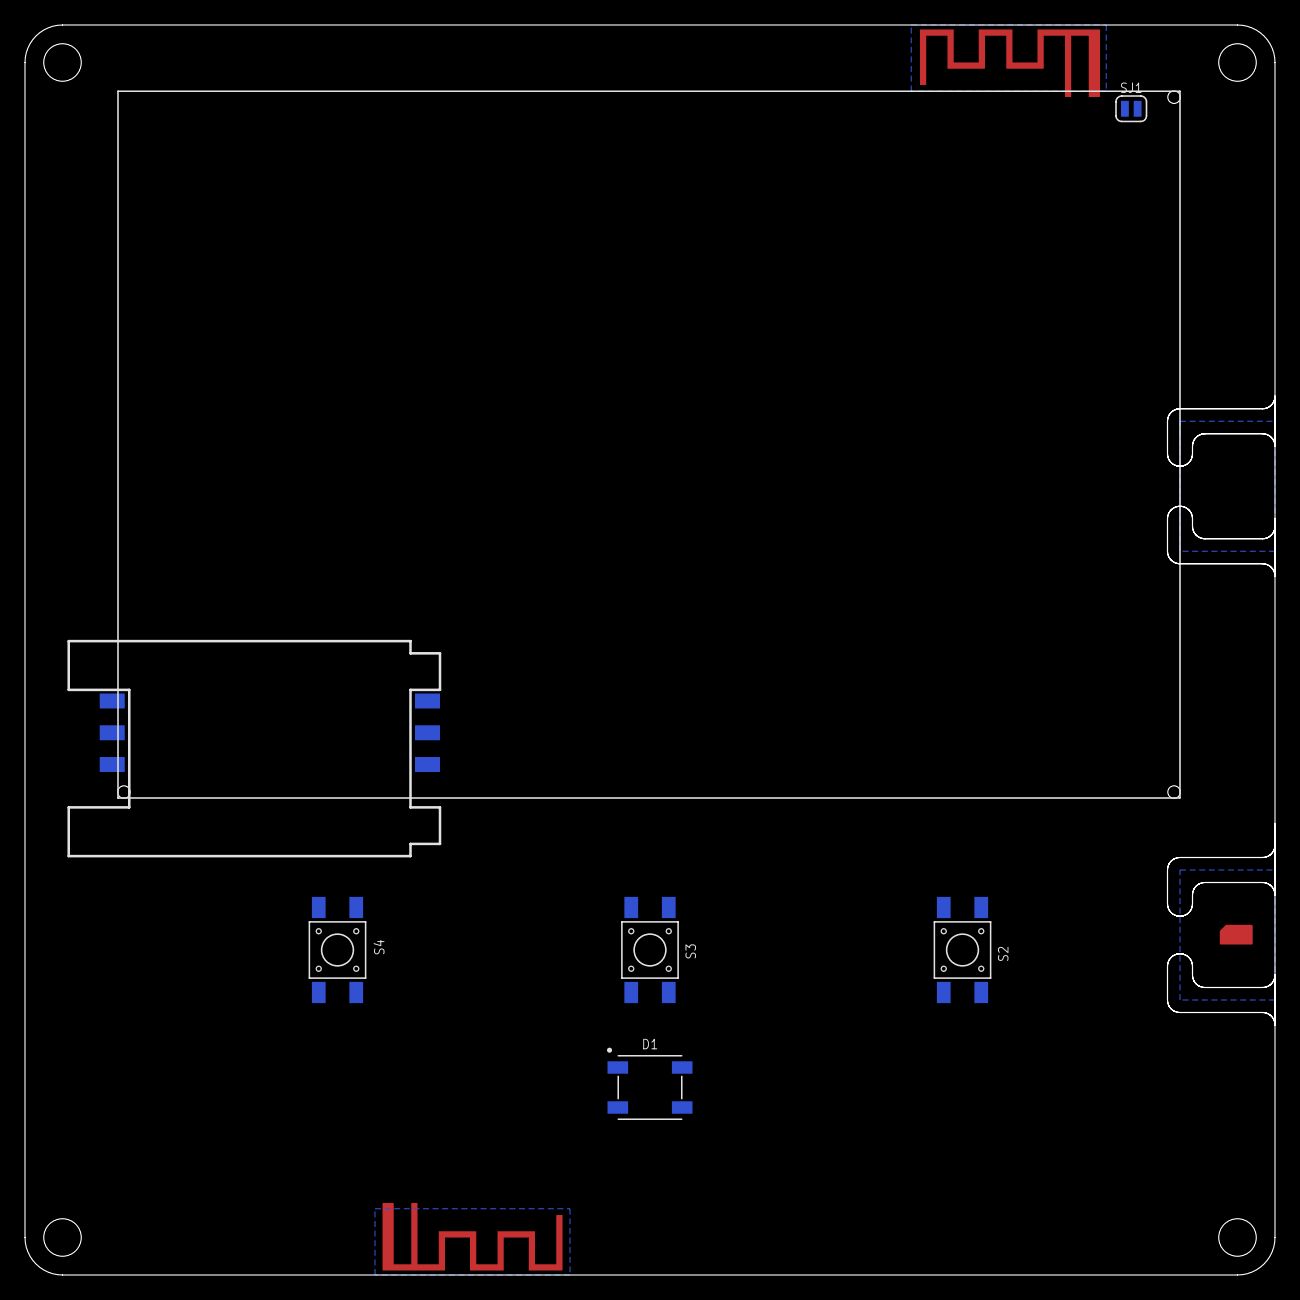
[picture p28: board iot-gateway.brd from below]

Board: 2 copper layers, 100.0 x 100.0 mm, 216 parts (7 on the bottom side), 138 nets, no tracks yet.

Parts:
B1: BUZZER-SMD; SMD
C1, C2, C3, C4, C5, C6, C7, C13, C14, C15, C16, C21, C23, C28, C29, C30, C31, C36, C42, C43, C50, C51, C52, C53, C54, C56, C61, C62, C69, C73: 100nF; CAP0603
C8, C25, C38: 1uF; CAP0603
C11, C35, C41: 1nF; CAP0603
C12, C22, C24, C39, C47, C63: 100uF; CAP1206
C17: 4pF; CAP0603
C18: 4.7pF; CAP0603
C19, C20: 20pF; CAP0603
C26, C27: 33pF; CAP0603
C32: 100uF; AL-CAP-CASE-D
C33, C34, C55, C60: 4.7uF; CAP0603
C37: 10nF; CAP0603
C40, C48: 22uF; CAP1206
C46: 10pF; CAP0603
C49, C57: 10uF; CAP0603
C58, C59, C64, C65, C66, C67, C68: 470pF; CAP0603
CON2: 6P-SH-TOP; SH-06-TOP
CON3: 2P-PH-TOP; PH-02-TOP
D1: WS2812B; WS2812B-SMD5050
D2, D3: LED1206; 1206
D4: SMAJ24A; DO214AC
D31: GREEN; 0603
D32: RED; 0603
E1, E2: 2.4GHZTRACE-15.2MM; TRACE_ANTENNA_2.4GHZ_15.2MM
F1: 2.6A Hold; 1812
J2: DCJACK; DC-050
L1: 1.8nH; IND0603
L2: 4.7uH; IND0606
L3: 2.2uH; IND0505
L4: 1uH; IND0805
L5: 470nH; IND3225
L6: 4.7uH; IND0603
Q1, Q2, Q3, Q4: AO3400; SOT23
R1, R4, R6, R7, R9, R12, R17, R18, R20, R21, R22, R24, R31, R33, R36, R37: 10K Ohms; RES0603
R2, R28, R111: 330 Ohms; RES0603
R3, R10, R26, R27, R29, R30: 22 Ohms; RES0603
R5, R68: 1K Ohms; RES0603
R8, R15, R25, R32, R38, R41, R46, R47, R60, R63, R66, R67, R69, R70, R71, R72, R75, R76, R77, R78, R81, R82, R83, R84, R85, R86: 100K Ohms; RES0603
R11, R51, R54: 1 MOhms; RES0603
R14, R50, R52, R53, R55: 100 Ohms; RES0603
R16, R34, R35, R64: 0 Ohms; RES0603
R19: 12K Ohms; RES0603
R23: 200 Ohms; RES0603
R39: 25m Ohms; RES1206
R40: 18.2K Ohms; RES0603
R42: 1M Ohms; RES0603
R43: 243K Ohms; RES0603
R44: 12m Ohms; RES1206
R45: 1.69M Ohms; RES0603
R48: 324K Ohms; RES0603
R49: 2K Ohms; RES0603
R58: 309K Ohms; RES0603
R59: 71.5K Ohms; RES0603
R61: 178K Ohms; RES0603
R62: 60.4K Ohms; RES0603
R73: 357K Ohms; RES0603
R74: 61.9K Ohms; RES0603
R79: 21K Ohms; RES0603
R80: 147K Ohms; RES0603
R110: 510 Ohms; RES0603
RFCON1, RFCON2, RFCON3, RFCON4: RFCON-U.FL; U.FL
S1: TAC_SW_SMD_RESET
S2, S3, S4: TAC_SW_SMD_4.5X4.5
SIM1: SIMHOLDER-SMD
SJ1: SJ_S
T5: BC817; SOT23
TC1: TC2050-IDC
TP1, TP2, TP3, TP4, TP5, TP6, TP7, TP8: TESTPOINT-1.27MM; PAD1.27MM
U1: 74LVC1G08; SC70-5
U2: SST26VF064B; WSOIC8
U3: SST26VF016B; WSOIC8
U4: ESP8266EX; QFN32
U5: RFM69HW; RFM69XW-XXXS2
U6: SIM800C
U7: SI7021; DFN6
U8: SI7210; SOT23-5
U9: BMP280
U10: CCS811; LGA10
U11: LT4040; QFN24_ASYM
U12: LT8610; MSOP16_EP
U13: LTC2942; DFN6
U14: FS312F-G; SOT23-6
U15: FS8205; SOT23-6
U16: MIC23159; VQFN20
U17: ER-TFT035-6-BOT; FPC-50P-TFT-BOT
U18: EFM32GG11B820F2048GQ100; QFP100
U21: 74LVC1G04; SC70-5
U$1: GECKO-14MM; GECKO_14MM
Y1: 8 MHz; 2-SMD-5032
Y2: 32.768 kHz; CM200S
Y3: 24 MHz; 2-SMD-5032

Connections:
1V8: C34.1, L6.1, U18.58
3V3: B1.1, C1.1, C2.1, C3.1, C4.1, C5.1, C6.1, C12.1, C13.1, C14.1, C15.1, C16.1, C21.1, C22.1, C28.1, C29.1, C30.1, C31.1, C52.1, C53.1, C54.1, C57.1, C69.1, C73.1, L4.2, R1.2, R4.2, R6.2, R7.2, R8.2, R11.2, R15.2, R18.2, R20.2, R22.2, R25.2, R32.2, R36.2, R37.2, R38.2, R41.2, R46.2, R47.2, R51.2, R54.2, R58.2, R60.2, R63.2, R66.2, R67.2, R68.2, R69.2, R71.2, R72.2, R75.2, R77.2, TC1.1, U1.3, U2.8, U3.8, U4.1, U4.3, U4.4, U4.11, U4.17, U4.29, U4.30, U5.8, U7.5, U8.4, U9.2, U9.6, U9.8, U10.6, U16.10, U17.1, U17.7, U17.8, U17.9, U17.35, U17.40, U17.41, U17.42, U18.8, U18.17, U18.31, U18.41, U18.44, U18.57, U18.82, U21.5
3V3_FB: R58.1, R59.2, U16.11
3V3_PGOOD: R60.1, U16.12
4V2: C23.1, C24.1, C62.1, C63.1, L5.1, R73.2, R82.2, U6.34, U6.35, U16.17
4V2_EN: R76.2, U16.18
4V2_FB: R73.1, R74.2, U16.16
4V2_PGOOD: R75.1, U16.15
4V2_VSENSE: C65.1, R81.2, R82.1
5V0: C7.1, C47.1, C48.1, C55.1, C56.1, C60.1, C61.1, D1.1, Q1.3, R5.2, R45.2, R84.2, U11.1, U11.12, U11.13, U11.14, U11.24, U16.1, U16.6, U16.7, U16.9, U16.20
5V0_FB: R45.1, R48.2, U11.10, U11.18
5V0_ISENSE: C68.1, U11.3
5V0_NBU: Q1.2, R44.1, U11.7
5V0_NBU_NSENS: C39.1, C40.1, C42.1, C46.1, L2.2, R42.2, R44.2, R61.2, R110.2, U11.6, U11.16, U12.14
5V0_NBU_NSENS_FB: C46.2, R42.1, R43.2, U12.16
5V0_NBU_NSENS_PGOOD: R77.1, U12.15
5V0_NBU_NSENS_SYNC: R78.2, U12.1
5V0_PGOOD: R71.1, U11.11
5V0_VSENSE: C66.1, R83.2, R84.1
12V0: C32.1, C33.1, C36.1, D4.C, F1.1, R80.2, U12.4, U12.5, U12.6
12V0_UNFUSED: F1.2, J2.C, J2.C'
12V0_VSENSE: C64.1, R79.2, R80.1
!5V0_BACKUP: R72.1, U11.20, U21.2
!BAT_CHRG: R63.1, U11.8
!BAT_FAULT: R67.1, U11.9
!CCS811_IRQ: R38.1, U10.3
!CCS811_RESET: R36.1, U10.2
!CCS811_WAKE: R37.1, U10.7
!RESET: R69.1, S1.1, S1.2, TC1.10, U18.36
!TFT_RESET: R32.1, U17.10
!TFT_TOUCH_IRQ: R47.1, U17.46
!TFT_TOUCH_RESET: R46.1, U17.47
!UI_BTN1: C41.1, R54.1, R55.2
!UI_BTN2: C35.1, R51.1, R52.2
!UI_BTN3: C11.1, R11.1, R14.2
!WIFI_RESET: CON2.1, R18.1, SJ1.2, U4.32
GBAT: C51.2, CON3.2, U13.2, U14.6, U15.3
GND: C1.2, C2.2, C3.2, C4.2, C5.2, C6.2, C7.2, C8.2, C11.2, C12.2, C13.2, C14.2, C15.2, C16.2, C17.1, C18.1, C19.1, C20.1, C21.2, C22.2, C23.2, C24.2, C25.2, C26.2, C27.2, C28.2, C29.2, C30.2, C31.2, C32.2, C33.2, C34.2, C35.2, C36.2, C37.2, C38.2, C39.2, C40.2, C41.2, C42.2, C47.2, C48.2, C49.2, C50.2, C52.2, C53.2, C54.2, C55.2, C56.2, C57.2, C58.2, C59.2, C60.2, C61.2, C62.2, C63.2, C64.2, C65.2, C66.2, C67.2, C68.2, C69.2, C73.2, CON2.6, D1.3, D4.A, D31.1, D32.1, E1.GND, E2.GND, J2.O, Q2.2, Q3.2, Q4.2, R2.1, R9.1, R12.1, R17.1, R19.2, R21.1, R24.1, R28.1, R31.1, R40.1, R43.1, R48.1, R49.1, R53.1, R59.1, R62.1, R70.1, R74.1, R76.1, R78.1, R79.1, R81.1, R83.1, R85.1, RFCON1.P$1, RFCON1.P$2, RFCON2.P$1, RFCON2.P$2, RFCON3.P$1, RFCON3.P$2, RFCON4.P$1, RFCON4.P$2, S1.3, S1.4, S2.3, S2.4, S3.3, S3.4, S4.3, S4.4, SIM1.C5, T5.2, TC1.3, TP4.TP, U1.5, U2.4, U3.4, U4.33, U5.9, U5.11, U6.8, U6.13, U6.19, U6.21, U6.27, U6.30, U6.31, U6.33, U6.36, U6.37, U7.2, U8.2, U9.1, U9.5, U9.7, U10.1, U10.PAD, U11.4, U11.5, U11.17, U11.25, U12.7, U12.8, U12.17, U15.1, U16.2, U16.5, U16.8, U16.19, U16.21, U17.11, U17.12, U17.13, U17.14, U17.15, U17.16, U17.17, U17.18, U17.19, U17.20, U17.21, U17.22, U17.23, U17.24, U17.25, U17.26, U17.27, U17.28, U17.29, U17.30, U17.31, U17.32, U17.43, U17.48, U17.49, U17.50, U18.16, U18.32, U18.55, U18.59, U18.83, U21.3
I2C0_SCL_SENS: R4.1, U7.6, U8.3, U9.4, U10.10
I2C0_SDA_SENS: R1.1, U7.1, U8.1, U9.3, U10.9
I2C1_SCL_TFT: R7.1, U17.44
I2C1_SDA_TFT: R6.1, U17.45
unnamed: U10.4, U10.5
unnamed: RFCON4.P$3, U6.32
unnamed: R26.1, SIM1.C2
unnamed: U1.1, U6.41
unnamed: R19.1, U4.31
unnamed: R23.2, U4.21
unnamed: C18.2, L1.2, R16.2, U4.2
unnamed: C17.2, E1.ANT, L1.1
unnamed: C8.1, U18.60
unnamed: R16.1, RFCON1.P$3
unnamed: SJ1.1, U4.8
unnamed: R40.2, U12.3
unnamed: C37.1, U12.2
unnamed: C38.1, U12.13
unnamed: C43.1, L2.1, U12.9, U12.10, U12.11
unnamed: D2.1, R28.2
unnamed: D2.2, U1.4
unnamed: R27.1, SIM1.C3
unnamed: D1.4, Q4.3, R5.1
unnamed: R34.1, R35.2, U6.20
unnamed: E2.ANT, R34.2
unnamed: R35.1, RFCON3.P$3
unnamed: TP8.TP, U6.28
unnamed: Q3.1, R30.2, R31.2
unnamed: TP1.TP, U6.26
unnamed: TP2.TP, U6.25
unnamed: T5.3, U6.39
unnamed: R33.1, T5.1
unnamed: D3.1, R2.2
unnamed: TP3.TP, U6.24
unnamed: TP5.TP, U6.40
unnamed: Q3.3, R64.1
unnamed: Q2.1, R3.2, R9.2
unnamed: B1.2, Q2.3, R68.1
unnamed: C43.2, U12.12
unnamed: Q1.1, U11.15
unnamed: L3.1, U11.21, U11.22
unnamed: R29.2, SIM1.C7
unnamed: R49.2, U11.2
unnamed: R50.1, U14.5
unnamed: R53.2, U14.2
unnamed: U14.3, U15.6
unnamed: U14.1, U15.4
unnamed: RFCON2.P$3, U5.10
unnamed: L4.1, U16.4
unnamed: C58.1, U16.13
unnamed: C59.1, U16.14
unnamed: L5.2, U16.3
unnamed: L6.2, U18.56
unnamed: TP6.TP, U6.23
unnamed: Q4.1, R10.1, R12.2
unnamed: R52.1, S3.1, S3.2
unnamed: R64.2, U17.2, U17.3
unnamed: R14.1, S4.1, S4.2
unnamed: TP7.TP, U6.22
unnamed: R55.1, S2.1, S2.2
unnamed: R111.2, U21.4
unnamed: D31.2, R110.1
unnamed: D32.2, R111.1
PF_THRESH: R61.1, R62.2, U11.19
QSPI_CLK: U2.6, U18.84
QSPI_CS0: R8.1, U2.1, U18.85
QSPI_D0: U2.5, U18.88
QSPI_D1: U2.2, U18.89
QSPI_D2: U2.3, U18.90
QSPI_D3: U2.7, U18.91
RFM_IRQ: R70.2, U5.2
RFM_RESET: R24.2, U5.1
SIM_CLK: R27.2, U6.16
SIM_DATA: C27.1, R29.1, U6.15
SIM_RST: R26.2, U6.17
SIM_VDD: C25.1, C26.1, SIM1.C1, U6.18
SWCLK: TC1.4, U18.76
SWDIO: TC1.2, U18.77
SWO: TC1.6, U18.78
US0_CS_WIFI: R21.2, U4.13
US1_CS_TFT: R66.1, U17.38
US3_CS_RFM: R25.1, U5.15
VBAT: C49.1, C50.1, C51.1, L3.2, R39.2, R50.2, R86.2, U11.23, U13.1
VBAT_NSENS: CON3.1, R39.1, U13.6
VBAT_VSENSE: C67.1, R85.2, R86.1
VIN_DET: J2.DT, R41.1
WIFI_BOOT: CON2.2, R20.1, U4.15
WIFI_EN: R17.2, U4.7
WIFI_LED: D3.2, U4.16
WIFI_QSPI_CLK: R23.1, U3.6
WIFI_QSPI_CS: R15.1, U3.1, U4.20
WIFI_QSPI_D0: U3.5, U4.23
WIFI_QSPI_D1: U3.2, U4.22
WIFI_QSPI_D2: U3.3, U4.19
WIFI_QSPI_D3: U3.7, U4.18
WIFI_RX_FW: CON2.4, U4.25
WIFI_TX_DBG: CON2.5, R22.1, U4.14
WIFI_TX_FW: CON2.3, U4.26
WIFI_XTAL_IN: C19.2, U4.28, Y3.1
WIFI_XTAL_OUT: C20.2, U4.27, Y3.2
