pepetech/iot-gateway/software/main/src/usart.c

#include "usart.h"

#if defined(USART0_MODE_SPI)
void usart0_init(uint32_t ulBaud, uint8_t ubMode, uint8_t ubBitMode, int8_t bMISOLocation, int8_t bMOSILocation, uint8_t ubCLKLocation)
{
    if(bMISOLocation > -1 && bMISOLocation > AFCHANLOC_MAX)
        return;

    if(bMOSILocation > -1 && bMOSILocation > AFCHANLOC_MAX)
        return;

    if(ubCLKLocation > AFCHANLOC_MAX)
        return;

    CMU->HFPERCLKEN0 |= CMU_HFPERCLKEN0_USART0;

    USART0->CMD = USART_CMD_CLEARRX | USART_CMD_CLEARTX | USART_CMD_TXTRIDIS | USART_CMD_RXBLOCKDIS | USART_CMD_TXDIS | USART_CMD_RXDIS;

    USART0->CTRL = USART_CTRL_TXBIL_EMPTY | USART_CTRL_CSMA_NOACTION | (ubBitMode == USART_SPI_MSB_FIRST ? USART_CTRL_MSBF : 0) | (ubMode & 1 ? USART_CTRL_CLKPHA_SAMPLETRAILING : USART_CTRL_CLKPHA_SAMPLELEADING) | (ubMode & 2 ? USART_CTRL_CLKPOL_IDLEHIGH : USART_CTRL_CLKPOL_IDLELOW) | USART_CTRL_SYNC;
    USART0->FRAME = USART_FRAME_DATABITS_EIGHT;
    USART0->CLKDIV = (uint32_t)((((float)HFPER_CLOCK_FREQ / (2.f * ulBaud)) - 1.f) * 256.f);

    USART0->ROUTEPEN = (bMISOLocation >= 0 ? USART_ROUTEPEN_RXPEN : 0) | (bMOSILocation >= 0 ? USART_ROUTEPEN_TXPEN : 0) | USART_ROUTEPEN_CLKPEN;
    USART0->ROUTELOC0 = ((uint32_t)(bMISOLocation >= 0 ? bMISOLocation : 0) << _USART_ROUTELOC0_RXLOC_SHIFT) | ((uint32_t)(bMOSILocation >= 0 ? bMOSILocation : 0) << _USART_ROUTELOC0_TXLOC_SHIFT) | ((uint32_t)ubCLKLocation << _USART_ROUTELOC0_CLKLOC_SHIFT);

    USART0->CMD = USART_CMD_MASTEREN | (bMOSILocation >= 0 ? USART_CMD_TXEN : 0) | (bMISOLocation >= 0 ? USART_CMD_RXEN : 0);
}
uint8_t usart0_spi_transfer_byte(const uint8_t ubData)
{
    while(USART0->STATUS & _USART_STATUS_TXBUFCNT_MASK);

    USART0->CMD = USART_CMD_CLEARRX;

    USART0->TXDATA = ubData;

    while(!(USART0->STATUS & USART_STATUS_TXC));

    return USART0->RXDATA;
}
void usart0_spi_write_byte(const uint8_t ubData, const uint8_t ubWait)
{
    while(!(USART0->STATUS & USART_STATUS_TXBL));

    USART0->TXDATA = ubData;

    while(ubWait && !(USART0->STATUS & USART_STATUS_TXC));
}
#else   // USART0_MODE_SPI
static volatile uint8_t *pubUSART0DMABuffer = NULL;
static volatile uint8_t *pubUSART0FIFO = NULL;
static volatile uint16_t usUSART0FIFOWritePos, usUSART0FIFOReadPos;
static ldma_descriptor_t __attribute__ ((aligned (4))) pUSART0DMADescriptor[2];

void _usart0_rx_isr()
{
    uint32_t ulFlags = USART0->IFC;

    if(ulFlags & USART_IFC_TCMP0)
    {
        ldma_ch_peri_req_disable(USART0_DMA_CHANNEL);

        while(ldma_ch_get_busy(USART0_DMA_CHANNEL));

        uint16_t usDMAXfersLeft = ldma_ch_get_remaining_xfers(USART0_DMA_CHANNEL); // Number of half words left
        uint32_t ulSize = (USART0_DMA_RX_BUFFER_SIZE >> 1) - (usDMAXfersLeft << 1); // Multiply to get number of bytes

        if(ulSize)
        {
            volatile uint8_t *pubDMANextDst = (volatile uint8_t *)ldma_ch_get_next_dst_addr(USART0_DMA_CHANNEL);
            volatile uint8_t *pubDMABufferReadPos = pubDMANextDst >= (pubUSART0DMABuffer + (USART0_DMA_RX_BUFFER_SIZE >> 1)) ? (pubUSART0DMABuffer + (USART0_DMA_RX_BUFFER_SIZE >> 1)) : pubUSART0DMABuffer;

            while(ulSize--)
            {
                pubUSART0FIFO[usUSART0FIFOWritePos++] = *pubDMABufferReadPos++;

                if(usUSART0FIFOWritePos >= USART0_FIFO_SIZE)
                    usUSART0FIFOWritePos = 0;
            }

        }

        while(USART0->STATUS & USART_STATUS_RXDATAV)
        {
            pubUSART0FIFO[usUSART0FIFOWritePos++] = USART0->RXDATA;

            if(usUSART0FIFOWritePos >= USART0_FIFO_SIZE)
                usUSART0FIFOWritePos = 0;
        }

        ldma_ch_load(USART0_DMA_CHANNEL, pUSART0DMADescriptor);
        ldma_ch_peri_req_enable(USART0_DMA_CHANNEL);
    }
}
static void usart0_dma_isr(uint8_t ubError)
{
    if(ubError)
    {
        ldma_ch_load(USART0_DMA_CHANNEL, pUSART0DMADescriptor);

        return;
    }

    volatile uint8_t *pubDMANextDst = (volatile uint8_t *)ldma_ch_get_next_dst_addr(USART0_DMA_CHANNEL);
    volatile uint8_t *pubDMABufferReadPos = pubDMANextDst >= (pubUSART0DMABuffer + (USART0_DMA_RX_BUFFER_SIZE >> 1)) ? pubUSART0DMABuffer : (pubUSART0DMABuffer + (USART0_DMA_RX_BUFFER_SIZE >> 1)); // If next destination address is on the second buffer it means that the first buffer has just gone full, copy from the first, and vice versa

    uint32_t ulSize = (USART0_DMA_RX_BUFFER_SIZE >> 1);

    while(ulSize--)
    {
        pubUSART0FIFO[usUSART0FIFOWritePos++] = *pubDMABufferReadPos++;

        if(usUSART0FIFOWritePos >= USART0_FIFO_SIZE)
            usUSART0FIFOWritePos = 0;
    }
}

void usart0_init(uint32_t ulBaud, uint32_t ulFrameSettings, int8_t bRXLocation, int8_t bTXLocation, int8_t bCTSLocation, int8_t bRTSLocation)
{
    if(bRXLocation > -1 && bRXLocation > AFCHANLOC_MAX)
        return;

    if(bTXLocation > -1 && bTXLocation > AFCHANLOC_MAX)
        return;

    if(bCTSLocation > -1 && bCTSLocation > AFCHANLOC_MAX)
        return;

    if(bRTSLocation > -1 && bRTSLocation > AFCHANLOC_MAX)
        return;

    CMU->HFPERCLKEN0 |= CMU_HFPERCLKEN0_USART0;

    USART0->CMD = USART_CMD_CLEARRX | USART_CMD_CLEARTX | USART_CMD_TXTRIDIS | USART_CMD_RXBLOCKDIS | USART_CMD_TXDIS | USART_CMD_RXDIS;

    free((uint8_t *)pubUSART0DMABuffer);
    free((uint8_t *)pubUSART0FIFO);

    pubUSART0DMABuffer = (volatile uint8_t *)malloc(USART0_DMA_RX_BUFFER_SIZE);

    if(!pubUSART0DMABuffer)
        return;

    memset((uint8_t *)pubUSART0DMABuffer, 0, USART0_DMA_RX_BUFFER_SIZE);

    pubUSART0FIFO = (volatile uint8_t *)malloc(USART0_FIFO_SIZE);

    if(!pubUSART0FIFO)
    {
        free((void *)pubUSART0DMABuffer);

        return;
    }

    memset((uint8_t *)pubUSART0FIFO, 0, USART0_FIFO_SIZE);

    usUSART0FIFOWritePos = 0;
    usUSART0FIFOReadPos = 0;

    USART0->CTRL = USART_CTRL_TXBIL_HALFFULL | USART_CTRL_CSMA_NOACTION | USART_CTRL_OVS_X16;
    USART0->CTRLX = (bCTSLocation >= 0 ? USART_CTRLX_CTSEN : 0);
    USART0->FRAME = ulFrameSettings;
    USART0->CLKDIV = (uint32_t)((((float)HFPER_CLOCK_FREQ / (16.f * ulBaud)) - 1.f) * 256.f);

    USART0->TIMECMP0 = USART_TIMECMP0_TSTOP_RXACT | USART_TIMECMP0_TSTART_RXEOF | 0x08; // RX Timeout after 8 baud times

    USART0->ROUTEPEN = (bRXLocation >= 0 ? USART_ROUTEPEN_RXPEN : 0) | (bTXLocation >= 0 ? USART_ROUTEPEN_TXPEN : 0) | (bCTSLocation >= 0 ? USART_ROUTEPEN_CTSPEN : 0) | (bRTSLocation >= 0 ? USART_ROUTEPEN_RTSPEN : 0);
    USART0->ROUTELOC0 = ((uint32_t)(bRXLocation >= 0 ? bRXLocation : 0) << _USART_ROUTELOC0_RXLOC_SHIFT) | ((uint32_t)(bTXLocation >= 0 ? bTXLocation : 0) << _USART_ROUTELOC0_TXLOC_SHIFT);
    USART0->ROUTELOC1 = ((uint32_t)(bCTSLocation >= 0 ? bCTSLocation : 0) << _USART_ROUTELOC1_CTSLOC_SHIFT) | ((uint32_t)(bRTSLocation >= 0 ? bRTSLocation : 0) << _USART_ROUTELOC1_RTSLOC_SHIFT);

    USART0->IFC = _USART_IFC_MASK; // Clear all flags
    IRQ_CLEAR(USART0_RX_IRQn); // Clear pending vector
    IRQ_SET_PRIO(USART0_RX_IRQn, 2, 1); // Set priority 2,1
    IRQ_ENABLE(USART0_RX_IRQn); // Enable vector
    USART0->IEN |= USART_IEN_TCMP0; // Enable TCMP0 flag

    ldma_ch_disable(USART0_DMA_CHANNEL);
    ldma_ch_peri_req_disable(USART0_DMA_CHANNEL);
    ldma_ch_req_clear(USART0_DMA_CHANNEL);

    ldma_ch_config(USART0_DMA_CHANNEL, LDMA_CH_REQSEL_SOURCESEL_USART0 | LDMA_CH_REQSEL_SIGSEL_USART0RXDATAV, LDMA_CH_CFG_SRCINCSIGN_DEFAULT, LDMA_CH_CFG_DSTINCSIGN_POSITIVE, LDMA_CH_CFG_ARBSLOTS_DEFAULT, 0);
    ldma_ch_set_isr(USART0_DMA_CHANNEL, usart0_dma_isr);

    pUSART0DMADescriptor[0].CTRL = LDMA_CH_CTRL_DSTMODE_ABSOLUTE | LDMA_CH_CTRL_SRCMODE_ABSOLUTE | LDMA_CH_CTRL_DSTINC_ONE | LDMA_CH_CTRL_SIZE_HALFWORD | LDMA_CH_CTRL_SRCINC_NONE | LDMA_CH_CTRL_IGNORESREQ | LDMA_CH_CTRL_REQMODE_BLOCK | LDMA_CH_CTRL_DONEIFSEN | LDMA_CH_CTRL_BLOCKSIZE_UNIT1 | ((((USART0_DMA_RX_BUFFER_SIZE >> 2) - 1) << _LDMA_CH_CTRL_XFERCNT_SHIFT) & _LDMA_CH_CTRL_XFERCNT_MASK) | LDMA_CH_CTRL_STRUCTTYPE_TRANSFER;
    pUSART0DMADescriptor[0].SRC = (void *)&USART0->RXDOUBLE;
    pUSART0DMADescriptor[0].DST = pubUSART0DMABuffer;
    pUSART0DMADescriptor[0].LINK = 0x00000010 | LDMA_CH_LINK_LINK | LDMA_CH_LINK_LINKMODE_RELATIVE;

    pUSART0DMADescriptor[1].CTRL = pUSART0DMADescriptor[0].CTRL;
    pUSART0DMADescriptor[1].SRC = pUSART0DMADescriptor[0].SRC;
    pUSART0DMADescriptor[1].DST = pubUSART0DMABuffer + (USART0_DMA_RX_BUFFER_SIZE >> 1);
    pUSART0DMADescriptor[1].LINK = 0xFFFFFFF0 | LDMA_CH_LINK_LINK | LDMA_CH_LINK_LINKMODE_RELATIVE;

    ldma_ch_load(USART0_DMA_CHANNEL, pUSART0DMADescriptor);
    ldma_ch_peri_req_enable(USART0_DMA_CHANNEL);
    ldma_ch_enable(USART0_DMA_CHANNEL);

    USART0->CMD = (bTXLocation >= 0 ? USART_CMD_TXEN : 0) | (bRXLocation >= 0 ? USART_CMD_RXEN : 0);
}
void usart0_write_byte(const uint8_t ubData)
{
    while(!(USART0->STATUS & USART_STATUS_TXBL));

    USART0->TXDATA = ubData;
}
uint8_t usart0_read_byte()
{
    if(!usart0_available())
        return 0;

    uint8_t ubData;

    ATOMIC_BLOCK(ATOMIC_RESTORESTATE)
    {
        ubData = pubUSART0FIFO[usUSART0FIFOReadPos++];

        if(usUSART0FIFOReadPos >= USART0_FIFO_SIZE)
            usUSART0FIFOReadPos = 0;
    }

    return ubData;
}
uint32_t usart0_available()
{
    return (USART0_FIFO_SIZE + usUSART0FIFOWritePos - usUSART0FIFOReadPos) % USART0_FIFO_SIZE;
}
void usart0_flush()
{
    usUSART0FIFOReadPos = usUSART0FIFOWritePos = 0;
}
#endif  // USART0_MODE_SPI

#if defined(USART1_MODE_SPI)
void usart1_init(uint32_t ulBaud, uint8_t ubMode, uint8_t ubBitMode, int8_t bMISOLocation, int8_t bMOSILocation, uint8_t ubCLKLocation)
{
    if(bMISOLocation > -1 && bMISOLocation > AFCHANLOC_MAX)
        return;

    if(bMOSILocation > -1 && bMOSILocation > AFCHANLOC_MAX)
        return;

    if(ubCLKLocation > AFCHANLOC_MAX)
        return;

    CMU->HFPERCLKEN0 |= CMU_HFPERCLKEN0_USART1;

    USART1->CMD = USART_CMD_CLEARRX | USART_CMD_CLEARTX | USART_CMD_TXTRIDIS | USART_CMD_RXBLOCKDIS | USART_CMD_TXDIS | USART_CMD_RXDIS;

    USART1->CTRL = USART_CTRL_TXBIL_EMPTY | USART_CTRL_CSMA_NOACTION | (ubBitMode == USART_SPI_MSB_FIRST ? USART_CTRL_MSBF : 0) | (ubMode & 1 ? USART_CTRL_CLKPHA_SAMPLETRAILING : USART_CTRL_CLKPHA_SAMPLELEADING) | (ubMode & 2 ? USART_CTRL_CLKPOL_IDLEHIGH : USART_CTRL_CLKPOL_IDLELOW) | USART_CTRL_SYNC;
    USART1->FRAME = USART_FRAME_DATABITS_EIGHT;
    USART1->CLKDIV = (uint32_t)((((float)HFPER_CLOCK_FREQ / (2.f * ulBaud)) - 1.f) * 256.f);

    USART1->ROUTEPEN = (bMISOLocation >= 0 ? USART_ROUTEPEN_RXPEN : 0) | (bMOSILocation >= 0 ? USART_ROUTEPEN_TXPEN : 0) | USART_ROUTEPEN_CLKPEN;
    USART1->ROUTELOC0 = ((uint32_t)(bMISOLocation >= 0 ? bMISOLocation : 0) << _USART_ROUTELOC0_RXLOC_SHIFT) | ((uint32_t)(bMOSILocation >= 0 ? bMOSILocation : 0) << _USART_ROUTELOC0_TXLOC_SHIFT) | ((uint32_t)ubCLKLocation << _USART_ROUTELOC0_CLKLOC_SHIFT);

    USART1->CMD = USART_CMD_MASTEREN | (bMOSILocation >= 0 ? USART_CMD_TXEN : 0) | (bMISOLocation >= 0 ? USART_CMD_RXEN : 0);
}
uint8_t usart1_spi_transfer_byte(const uint8_t ubData)
{
    while(USART1->STATUS & _USART_STATUS_TXBUFCNT_MASK);

    USART1->CMD = USART_CMD_CLEARRX;

    USART1->TXDATA = ubData;

    while(!(USART1->STATUS & USART_STATUS_TXC));

    return USART1->RXDATA;
}
void usart1_spi_write_byte(const uint8_t ubData, const uint8_t ubWait)
{
    while(!(USART1->STATUS & USART_STATUS_TXBL));

    USART1->TXDATA = ubData;

    while(ubWait && !(USART1->STATUS & USART_STATUS_TXC));
}
#else   // USART1_MODE_SPI
static volatile uint8_t *pubUSART1DMABuffer = NULL;
static volatile uint8_t *pubUSART1FIFO = NULL;
static volatile uint16_t usUSART1FIFOWritePos, usUSART1FIFOReadPos;
static ldma_descriptor_t __attribute__ ((aligned (4))) pUSART1DMADescriptor[2];

void _usart1_rx_isr()
{
    uint32_t ulFlags = USART1->IFC;

    if(ulFlags & USART_IFC_TCMP0)
    {
        ldma_ch_peri_req_disable(USART1_DMA_CHANNEL);

        while(ldma_ch_get_busy(USART1_DMA_CHANNEL));

        uint16_t usDMAXfersLeft = ldma_ch_get_remaining_xfers(USART1_DMA_CHANNEL); // Number of half words left
        uint32_t ulSize = (USART1_DMA_RX_BUFFER_SIZE >> 1) - (usDMAXfersLeft << 1); // Multiply to get number of bytes

        if(ulSize)
        {
            volatile uint8_t *pubDMANextDst = (volatile uint8_t *)ldma_ch_get_next_dst_addr(USART1_DMA_CHANNEL);
            volatile uint8_t *pubDMABufferReadPos = pubDMANextDst >= (pubUSART1DMABuffer + (USART1_DMA_RX_BUFFER_SIZE >> 1)) ? (pubUSART1DMABuffer + (USART1_DMA_RX_BUFFER_SIZE >> 1)) : pubUSART1DMABuffer;

            while(ulSize--)
            {
                pubUSART1FIFO[usUSART1FIFOWritePos++] = *pubDMABufferReadPos++;

                if(usUSART1FIFOWritePos >= USART1_FIFO_SIZE)
                    usUSART1FIFOWritePos = 0;
            }

        }

        while(USART1->STATUS & USART_STATUS_RXDATAV)
        {
            pubUSART1FIFO[usUSART1FIFOWritePos++] = USART1->RXDATA;

            if(usUSART1FIFOWritePos >= USART1_FIFO_SIZE)
                usUSART1FIFOWritePos = 0;
        }

        ldma_ch_load(USART1_DMA_CHANNEL, pUSART1DMADescriptor);
        ldma_ch_peri_req_enable(USART1_DMA_CHANNEL);
    }
}
static void usart1_dma_isr(uint8_t ubError)
{
    if(ubError)
    {
        ldma_ch_load(USART1_DMA_CHANNEL, pUSART1DMADescriptor);

        return;
    }

    volatile uint8_t *pubDMANextDst = (volatile uint8_t *)ldma_ch_get_next_dst_addr(USART1_DMA_CHANNEL);
    volatile uint8_t *pubDMABufferReadPos = pubDMANextDst >= (pubUSART1DMABuffer + (USART1_DMA_RX_BUFFER_SIZE >> 1)) ? pubUSART1DMABuffer : (pubUSART1DMABuffer + (USART1_DMA_RX_BUFFER_SIZE >> 1)); // If next destination address is on the second buffer it means that the first buffer has just gone full, copy from the first, and vice versa

    uint32_t ulSize = (USART1_DMA_RX_BUFFER_SIZE >> 1);

    while(ulSize--)
    {
        pubUSART1FIFO[usUSART1FIFOWritePos++] = *pubDMABufferReadPos++;

        if(usUSART1FIFOWritePos >= USART1_FIFO_SIZE)
            usUSART1FIFOWritePos = 0;
    }
}

void usart1_init(uint32_t ulBaud, uint32_t ulFrameSettings, int8_t bRXLocation, int8_t bTXLocation, int8_t bCTSLocation, int8_t bRTSLocation)
{
    if(bRXLocation > -1 && bRXLocation > AFCHANLOC_MAX)
        return;

    if(bTXLocation > -1 && bTXLocation > AFCHANLOC_MAX)
        return;

    if(bCTSLocation > -1 && bCTSLocation > AFCHANLOC_MAX)
        return;

    if(bRTSLocation > -1 && bRTSLocation > AFCHANLOC_MAX)
        return;

    CMU->HFPERCLKEN0 |= CMU_HFPERCLKEN0_USART1;

    USART1->CMD = USART_CMD_CLEARRX | USART_CMD_CLEARTX | USART_CMD_TXTRIDIS | USART_CMD_RXBLOCKDIS | USART_CMD_TXDIS | USART_CMD_RXDIS;

    free((uint8_t *)pubUSART1DMABuffer);
    free((uint8_t *)pubUSART1FIFO);

    pubUSART1DMABuffer = (volatile uint8_t *)malloc(USART1_DMA_RX_BUFFER_SIZE);

    if(!pubUSART1DMABuffer)
        return;

    memset((uint8_t *)pubUSART1DMABuffer, 0, USART1_DMA_RX_BUFFER_SIZE);

    pubUSART1FIFO = (volatile uint8_t *)malloc(USART1_FIFO_SIZE);

    if(!pubUSART1FIFO)
    {
        free((void *)pubUSART1DMABuffer);

        return;
    }

    memset((uint8_t *)pubUSART1FIFO, 0, USART1_FIFO_SIZE);

    usUSART1FIFOWritePos = 0;
    usUSART1FIFOReadPos = 0;

    USART1->CTRL = USART_CTRL_TXBIL_HALFFULL | USART_CTRL_CSMA_NOACTION | USART_CTRL_OVS_X16;
    USART1->CTRLX = (bCTSLocation >= 0 ? USART_CTRLX_CTSEN : 0);
    USART1->FRAME = ulFrameSettings;
    USART1->CLKDIV = (uint32_t)((((float)HFPER_CLOCK_FREQ / (16.f * ulBaud)) - 1.f) * 256.f);

    USART1->TIMECMP0 = USART_TIMECMP0_TSTOP_RXACT | USART_TIMECMP0_TSTART_RXEOF | 0x08; // RX Timeout after 8 baud times

    USART1->ROUTEPEN = (bRXLocation >= 0 ? USART_ROUTEPEN_RXPEN : 0) | (bTXLocation >= 0 ? USART_ROUTEPEN_TXPEN : 0) | (bCTSLocation >= 0 ? USART_ROUTEPEN_CTSPEN : 0) | (bRTSLocation >= 0 ? USART_ROUTEPEN_RTSPEN : 0);
    USART1->ROUTELOC0 = ((uint32_t)(bRXLocation >= 0 ? bRXLocation : 0) << _USART_ROUTELOC0_RXLOC_SHIFT) | ((uint32_t)(bTXLocation >= 0 ? bTXLocation : 0) << _USART_ROUTELOC0_TXLOC_SHIFT);
    USART1->ROUTELOC1 = ((uint32_t)(bCTSLocation >= 0 ? bCTSLocation : 0) << _USART_ROUTELOC1_CTSLOC_SHIFT) | ((uint32_t)(bRTSLocation >= 0 ? bRTSLocation : 0) << _USART_ROUTELOC1_RTSLOC_SHIFT);

    USART1->IFC = _USART_IFC_MASK; // Clear all flags
    IRQ_CLEAR(USART1_RX_IRQn); // Clear pending vector
    IRQ_SET_PRIO(USART1_RX_IRQn, 2, 1); // Set priority 2,1
    IRQ_ENABLE(USART1_RX_IRQn); // Enable vector
    USART1->IEN |= USART_IEN_TCMP0; // Enable TCMP0 flag

    ldma_ch_disable(USART1_DMA_CHANNEL);
    ldma_ch_peri_req_disable(USART1_DMA_CHANNEL);
    ldma_ch_req_clear(USART1_DMA_CHANNEL);

    ldma_ch_config(USART1_DMA_CHANNEL, LDMA_CH_REQSEL_SOURCESEL_USART1 | LDMA_CH_REQSEL_SIGSEL_USART1RXDATAV, LDMA_CH_CFG_SRCINCSIGN_DEFAULT, LDMA_CH_CFG_DSTINCSIGN_POSITIVE, LDMA_CH_CFG_ARBSLOTS_DEFAULT, 0);
    ldma_ch_set_isr(USART1_DMA_CHANNEL, usart1_dma_isr);

    pUSART1DMADescriptor[0].CTRL = LDMA_CH_CTRL_DSTMODE_ABSOLUTE | LDMA_CH_CTRL_SRCMODE_ABSOLUTE | LDMA_CH_CTRL_DSTINC_ONE | LDMA_CH_CTRL_SIZE_HALFWORD | LDMA_CH_CTRL_SRCINC_NONE | LDMA_CH_CTRL_IGNORESREQ | LDMA_CH_CTRL_REQMODE_BLOCK | LDMA_CH_CTRL_DONEIFSEN | LDMA_CH_CTRL_BLOCKSIZE_UNIT1 | ((((USART1_DMA_RX_BUFFER_SIZE >> 2) - 1) << _LDMA_CH_CTRL_XFERCNT_SHIFT) & _LDMA_CH_CTRL_XFERCNT_MASK) | LDMA_CH_CTRL_STRUCTTYPE_TRANSFER;
    pUSART1DMADescriptor[0].SRC = (void *)&USART1->RXDOUBLE;
    pUSART1DMADescriptor[0].DST = pubUSART1DMABuffer;
    pUSART1DMADescriptor[0].LINK = 0x00000010 | LDMA_CH_LINK_LINK | LDMA_CH_LINK_LINKMODE_RELATIVE;

    pUSART1DMADescriptor[1].CTRL = pUSART1DMADescriptor[0].CTRL;
    pUSART1DMADescriptor[1].SRC = pUSART1DMADescriptor[0].SRC;
    pUSART1DMADescriptor[1].DST = pubUSART1DMABuffer + (USART1_DMA_RX_BUFFER_SIZE >> 1);
    pUSART1DMADescriptor[1].LINK = 0xFFFFFFF0 | LDMA_CH_LINK_LINK | LDMA_CH_LINK_LINKMODE_RELATIVE;

    ldma_ch_load(USART1_DMA_CHANNEL, pUSART1DMADescriptor);
    ldma_ch_peri_req_enable(USART1_DMA_CHANNEL);
    ldma_ch_enable(USART1_DMA_CHANNEL);

    USART1->CMD = (bTXLocation >= 0 ? USART_CMD_TXEN : 0) | (bRXLocation >= 0 ? USART_CMD_RXEN : 0);
}
void usart1_write_byte(const uint8_t ubData)
{
    while(!(USART1->STATUS & USART_STATUS_TXBL));

    USART1->TXDATA = ubData;
}
uint8_t usart1_read_byte()
{
    if(!usart1_available())
        return 0;

    uint8_t ubData;

    ATOMIC_BLOCK(ATOMIC_RESTORESTATE)
    {
        ubData = pubUSART1FIFO[usUSART1FIFOReadPos++];

        if(usUSART1FIFOReadPos >= USART1_FIFO_SIZE)
            usUSART1FIFOReadPos = 0;
    }

    return ubData;
}
uint32_t usart1_available()
{
    return (USART1_FIFO_SIZE + usUSART1FIFOWritePos - usUSART1FIFOReadPos) % USART1_FIFO_SIZE;
}
void usart1_flush()
{
    usUSART1FIFOReadPos = usUSART1FIFOWritePos = 0;
}
#endif  // USART1_MODE_SPI

#if defined(USART2_MODE_SPI)
void usart2_init(uint32_t ulBaud, uint8_t ubMode, uint8_t ubBitMode, int8_t bMISOLocation, int8_t bMOSILocation, uint8_t ubCLKLocation)
{
    if(bMISOLocation > -1 && bMISOLocation > AFCHANLOC_MAX)
        return;

    if(bMOSILocation > -1 && bMOSILocation > AFCHANLOC_MAX)
        return;

    if(ubCLKLocation > AFCHANLOC_MAX)
        return;

    CMU->HFPERCLKEN0 |= CMU_HFPERCLKEN0_USART2;

    USART2->CMD = USART_CMD_CLEARRX | USART_CMD_CLEARTX | USART_CMD_TXTRIDIS | USART_CMD_RXBLOCKDIS | USART_CMD_TXDIS | USART_CMD_RXDIS;

    USART2->CTRL = USART_CTRL_TXBIL_EMPTY | USART_CTRL_CSMA_NOACTION | (ubBitMode == USART_SPI_MSB_FIRST ? USART_CTRL_MSBF : 0) | (ubMode & 1 ? USART_CTRL_CLKPHA_SAMPLETRAILING : USART_CTRL_CLKPHA_SAMPLELEADING) | (ubMode & 2 ? USART_CTRL_CLKPOL_IDLEHIGH : USART_CTRL_CLKPOL_IDLELOW) | USART_CTRL_SYNC;
    USART2->FRAME = USART_FRAME_DATABITS_EIGHT;
    USART2->CLKDIV = (uint32_t)((((float)HFPERB_CLOCK_FREQ / (2.f * ulBaud)) - 1.f) * 256.f);

    USART2->ROUTEPEN = (bMISOLocation >= 0 ? USART_ROUTEPEN_RXPEN : 0) | (bMOSILocation >= 0 ? USART_ROUTEPEN_TXPEN : 0) | USART_ROUTEPEN_CLKPEN;
    USART2->ROUTELOC0 = ((uint32_t)(bMISOLocation >= 0 ? bMISOLocation : 0) << _USART_ROUTELOC0_RXLOC_SHIFT) | ((uint32_t)(bMOSILocation >= 0 ? bMOSILocation : 0) << _USART_ROUTELOC0_TXLOC_SHIFT) | ((uint32_t)ubCLKLocation << _USART_ROUTELOC0_CLKLOC_SHIFT);

    USART2->CMD = USART_CMD_MASTEREN | (bMOSILocation >= 0 ? USART_CMD_TXEN : 0) | (bMISOLocation >= 0 ? USART_CMD_RXEN : 0);
}
uint8_t usart2_spi_transfer_byte(const uint8_t ubData)
{
    while(USART2->STATUS & _USART_STATUS_TXBUFCNT_MASK);

    USART2->CMD = USART_CMD_CLEARRX;

    USART2->TXDATA = ubData;

    while(!(USART2->STATUS & USART_STATUS_TXC));

    return USART2->RXDATA;
}
void usart2_spi_write_byte(const uint8_t ubData, const uint8_t ubWait)
{
    while(!(USART2->STATUS & USART_STATUS_TXBL));

    USART2->TXDATA = ubData;

    while(ubWait && !(USART2->STATUS & USART_STATUS_TXC));
}
#else   // USART2_MODE_SPI
static volatile uint8_t *pubUSART2DMABuffer = NULL;
static volatile uint8_t *pubUSART2FIFO = NULL;
static volatile uint16_t usUSART2FIFOWritePos, usUSART2FIFOReadPos;
static ldma_descriptor_t __attribute__ ((aligned (4))) pUSART2DMADescriptor[2];

void _usart2_rx_isr()
{
    uint32_t ulFlags = USART2->IFC;

    if(ulFlags & USART_IFC_TCMP0)
    {
        ldma_ch_peri_req_disable(USART2_DMA_CHANNEL);

        while(ldma_ch_get_busy(USART2_DMA_CHANNEL));

        uint16_t usDMAXfersLeft = ldma_ch_get_remaining_xfers(USART2_DMA_CHANNEL); // Number of half words left
        uint32_t ulSize = (USART2_DMA_RX_BUFFER_SIZE >> 1) - (usDMAXfersLeft << 1); // Multiply to get number of bytes

        if(ulSize)
        {
            volatile uint8_t *pubDMANextDst = (volatile uint8_t *)ldma_ch_get_next_dst_addr(USART2_DMA_CHANNEL);
            volatile uint8_t *pubDMABufferReadPos = pubDMANextDst >= (pubUSART2DMABuffer + (USART2_DMA_RX_BUFFER_SIZE >> 1)) ? (pubUSART2DMABuffer + (USART2_DMA_RX_BUFFER_SIZE >> 1)) : pubUSART2DMABuffer;

            while(ulSize--)
            {
                pubUSART2FIFO[usUSART2FIFOWritePos++] = *pubDMABufferReadPos++;

                if(usUSART2FIFOWritePos >= USART2_FIFO_SIZE)
                    usUSART2FIFOWritePos = 0;
            }

        }

        while(USART2->STATUS & USART_STATUS_RXDATAV)
        {
            pubUSART2FIFO[usUSART2FIFOWritePos++] = USART2->RXDATA;

            if(usUSART2FIFOWritePos >= USART2_FIFO_SIZE)
                usUSART2FIFOWritePos = 0;
        }

        ldma_ch_load(USART2_DMA_CHANNEL, pUSART2DMADescriptor);
        ldma_ch_peri_req_enable(USART2_DMA_CHANNEL);
    }
}
static void usart2_dma_isr(uint8_t ubError)
{
    if(ubError)
    {
        ldma_ch_load(USART2_DMA_CHANNEL, pUSART2DMADescriptor);

        return;
    }

    volatile uint8_t *pubDMANextDst = (volatile uint8_t *)ldma_ch_get_next_dst_addr(USART2_DMA_CHANNEL);
    volatile uint8_t *pubDMABufferReadPos = pubDMANextDst >= (pubUSART2DMABuffer + (USART2_DMA_RX_BUFFER_SIZE >> 1)) ? pubUSART2DMABuffer : (pubUSART2DMABuffer + (USART2_DMA_RX_BUFFER_SIZE >> 1)); // If next destination address is on the second buffer it means that the first buffer has just gone full, copy from the first, and vice versa

    uint32_t ulSize = (USART2_DMA_RX_BUFFER_SIZE >> 1);

    while(ulSize--)
    {
        pubUSART2FIFO[usUSART2FIFOWritePos++] = *pubDMABufferReadPos++;

        if(usUSART2FIFOWritePos >= USART2_FIFO_SIZE)
            usUSART2FIFOWritePos = 0;
    }
}

void usart2_init(uint32_t ulBaud, uint32_t ulFrameSettings, int8_t bRXLocation, int8_t bTXLocation, int8_t bCTSLocation, int8_t bRTSLocation)
{
    if(bRXLocation > -1 && bRXLocation > AFCHANLOC_MAX)
        return;

    if(bTXLocation > -1 && bTXLocation > AFCHANLOC_MAX)
        return;

    if(bCTSLocation > -1 && bCTSLocation > AFCHANLOC_MAX)
        return;

    if(bRTSLocation > -1 && bRTSLocation > AFCHANLOC_MAX)
        return;

    CMU->HFPERCLKEN0 |= CMU_HFPERCLKEN0_USART2;

    USART2->CMD = USART_CMD_CLEARRX | USART_CMD_CLEARTX | USART_CMD_TXTRIDIS | USART_CMD_RXBLOCKDIS | USART_CMD_TXDIS | USART_CMD_RXDIS;

    free((uint8_t *)pubUSART2DMABuffer);
    free((uint8_t *)pubUSART2FIFO);

    pubUSART2DMABuffer = (volatile uint8_t *)malloc(USART2_DMA_RX_BUFFER_SIZE);

    if(!pubUSART2DMABuffer)
        return;

    memset((uint8_t *)pubUSART2DMABuffer, 0, USART2_DMA_RX_BUFFER_SIZE);

    pubUSART2FIFO = (volatile uint8_t *)malloc(USART2_FIFO_SIZE);

    if(!pubUSART2FIFO)
    {
        free((void *)pubUSART2DMABuffer);

        return;
    }

    memset((uint8_t *)pubUSART2FIFO, 0, USART2_FIFO_SIZE);

    usUSART2FIFOWritePos = 0;
    usUSART2FIFOReadPos = 0;

    USART2->CTRL = USART_CTRL_TXBIL_HALFFULL | USART_CTRL_CSMA_NOACTION | USART_CTRL_OVS_X16;
    USART2->CTRLX = (bCTSLocation >= 0 ? USART_CTRLX_CTSEN : 0);
    USART2->FRAME = ulFrameSettings;
    USART2->CLKDIV = (uint32_t)((((float)HFPERB_CLOCK_FREQ / (16.f * ulBaud)) - 1.f) * 256.f);

    USART2->TIMECMP0 = USART_TIMECMP0_TSTOP_RXACT | USART_TIMECMP0_TSTART_RXEOF | 0x08; // RX Timeout after 8 baud times

    USART2->ROUTEPEN = (bRXLocation >= 0 ? USART_ROUTEPEN_RXPEN : 0) | (bTXLocation >= 0 ? USART_ROUTEPEN_TXPEN : 0) | (bCTSLocation >= 0 ? USART_ROUTEPEN_CTSPEN : 0) | (bRTSLocation >= 0 ? USART_ROUTEPEN_RTSPEN : 0);
    USART2->ROUTELOC0 = ((uint32_t)(bRXLocation >= 0 ? bRXLocation : 0) << _USART_ROUTELOC0_RXLOC_SHIFT) | ((uint32_t)(bTXLocation >= 0 ? bTXLocation : 0) << _USART_ROUTELOC0_TXLOC_SHIFT);
    USART2->ROUTELOC1 = ((uint32_t)(bCTSLocation >= 0 ? bCTSLocation : 0) << _USART_ROUTELOC1_CTSLOC_SHIFT) | ((uint32_t)(bRTSLocation >= 0 ? bRTSLocation : 0) << _USART_ROUTELOC1_RTSLOC_SHIFT);

    USART2->IFC = _USART_IFC_MASK; // Clear all flags
    IRQ_CLEAR(USART2_RX_IRQn); // Clear pending vector
    IRQ_SET_PRIO(USART2_RX_IRQn, 2, 1); // Set priority 2,1
    IRQ_ENABLE(USART2_RX_IRQn); // Enable vector
    USART2->IEN |= USART_IEN_TCMP0; // Enable TCMP0 flag

    ldma_ch_disable(USART2_DMA_CHANNEL);
    ldma_ch_peri_req_disable(USART2_DMA_CHANNEL);
    ldma_ch_req_clear(USART2_DMA_CHANNEL);

    ldma_ch_config(USART2_DMA_CHANNEL, LDMA_CH_REQSEL_SOURCESEL_USART2 | LDMA_CH_REQSEL_SIGSEL_USART2RXDATAV, LDMA_CH_CFG_SRCINCSIGN_DEFAULT, LDMA_CH_CFG_DSTINCSIGN_POSITIVE, LDMA_CH_CFG_ARBSLOTS_DEFAULT, 0);
    ldma_ch_set_isr(USART2_DMA_CHANNEL, usart2_dma_isr);

    pUSART2DMADescriptor[0].CTRL = LDMA_CH_CTRL_DSTMODE_ABSOLUTE | LDMA_CH_CTRL_SRCMODE_ABSOLUTE | LDMA_CH_CTRL_DSTINC_ONE | LDMA_CH_CTRL_SIZE_HALFWORD | LDMA_CH_CTRL_SRCINC_NONE | LDMA_CH_CTRL_IGNORESREQ | LDMA_CH_CTRL_REQMODE_BLOCK | LDMA_CH_CTRL_DONEIFSEN | LDMA_CH_CTRL_BLOCKSIZE_UNIT1 | ((((USART2_DMA_RX_BUFFER_SIZE >> 2) - 1) << _LDMA_CH_CTRL_XFERCNT_SHIFT) & _LDMA_CH_CTRL_XFERCNT_MASK) | LDMA_CH_CTRL_STRUCTTYPE_TRANSFER;
    pUSART2DMADescriptor[0].SRC = (void *)&USART2->RXDOUBLE;
    pUSART2DMADescriptor[0].DST = pubUSART2DMABuffer;
    pUSART2DMADescriptor[0].LINK = 0x00000010 | LDMA_CH_LINK_LINK | LDMA_CH_LINK_LINKMODE_RELATIVE;

    pUSART2DMADescriptor[1].CTRL = pUSART2DMADescriptor[0].CTRL;
    pUSART2DMADescriptor[1].SRC = pUSART2DMADescriptor[0].SRC;
    pUSART2DMADescriptor[1].DST = pubUSART2DMABuffer + (USART2_DMA_RX_BUFFER_SIZE >> 1);
    pUSART2DMADescriptor[1].LINK = 0xFFFFFFF0 | LDMA_CH_LINK_LINK | LDMA_CH_LINK_LINKMODE_RELATIVE;

    ldma_ch_load(USART2_DMA_CHANNEL, pUSART2DMADescriptor);
    ldma_ch_peri_req_enable(USART2_DMA_CHANNEL);
    ldma_ch_enable(USART2_DMA_CHANNEL);

    USART2->CMD = (bTXLocation >= 0 ? USART_CMD_TXEN : 0) | (bRXLocation >= 0 ? USART_CMD_RXEN : 0);
}
void usart2_write_byte(const uint8_t ubData)
{
    while(!(USART2->STATUS & USART_STATUS_TXBL));

    USART2->TXDATA = ubData;
}
uint8_t usart2_read_byte()
{
    if(!usart2_available())
        return 0;

    uint8_t ubData;

    ATOMIC_BLOCK(ATOMIC_RESTORESTATE)
    {
        ubData = pubUSART2FIFO[usUSART2FIFOReadPos++];

        if(usUSART2FIFOReadPos >= USART2_FIFO_SIZE)
            usUSART2FIFOReadPos = 0;
    }

    return ubData;
}
uint32_t usart2_available()
{
    return (USART2_FIFO_SIZE + usUSART2FIFOWritePos - usUSART2FIFOReadPos) % USART2_FIFO_SIZE;
}
void usart2_flush()
{
    usUSART2FIFOReadPos = usUSART2FIFOWritePos = 0;
}
#endif  // USART2_MODE_SPI

#if defined(USART3_MODE_SPI)
void usart3_init(uint32_t ulBaud, uint8_t ubMode, uint8_t ubBitMode, int8_t bMISOLocation, int8_t bMOSILocation, uint8_t ubCLKLocation)
{
    if(bMISOLocation > -1 && bMISOLocation > AFCHANLOC_MAX)
        return;

    if(bMOSILocation > -1 && bMOSILocation > AFCHANLOC_MAX)
        return;

    if(ubCLKLocation > AFCHANLOC_MAX)
        return;

    CMU->HFPERCLKEN0 |= CMU_HFPERCLKEN0_USART3;

    USART3->CMD = USART_CMD_CLEARRX | USART_CMD_CLEARTX | USART_CMD_TXTRIDIS | USART_CMD_RXBLOCKDIS | USART_CMD_TXDIS | USART_CMD_RXDIS;

    USART3->CTRL = USART_CTRL_TXBIL_EMPTY | USART_CTRL_CSMA_NOACTION | (ubBitMode == USART_SPI_MSB_FIRST ? USART_CTRL_MSBF : 0) | (ubMode & 1 ? USART_CTRL_CLKPHA_SAMPLETRAILING : USART_CTRL_CLKPHA_SAMPLELEADING) | (ubMode & 2 ? USART_CTRL_CLKPOL_IDLEHIGH : USART_CTRL_CLKPOL_IDLELOW) | USART_CTRL_SYNC;
    USART3->FRAME = USART_FRAME_DATABITS_EIGHT;
    USART3->CLKDIV = (uint32_t)((((float)HFPER_CLOCK_FREQ / (2.f * ulBaud)) - 1.f) * 256.f);

    USART3->ROUTEPEN = (bMISOLocation >= 0 ? USART_ROUTEPEN_RXPEN : 0) | (bMOSILocation >= 0 ? USART_ROUTEPEN_TXPEN : 0) | USART_ROUTEPEN_CLKPEN;
    USART3->ROUTELOC0 = ((uint32_t)(bMISOLocation >= 0 ? bMISOLocation : 0) << _USART_ROUTELOC0_RXLOC_SHIFT) | ((uint32_t)(bMOSILocation >= 0 ? bMOSILocation : 0) << _USART_ROUTELOC0_TXLOC_SHIFT) | ((uint32_t)ubCLKLocation << _USART_ROUTELOC0_CLKLOC_SHIFT);

    USART3->CMD = USART_CMD_MASTEREN | (bMOSILocation >= 0 ? USART_CMD_TXEN : 0) | (bMISOLocation >= 0 ? USART_CMD_RXEN : 0);
}
uint8_t usart3_spi_transfer_byte(const uint8_t ubData)
{
    while(USART3->STATUS & _USART_STATUS_TXBUFCNT_MASK);

    USART3->CMD = USART_CMD_CLEARRX;

    USART3->TXDATA = ubData;

    while(!(USART3->STATUS & USART_STATUS_TXC));

    return USART3->RXDATA;
}
void usart3_spi_write_byte(const uint8_t ubData, const uint8_t ubWait)
{
    while(!(USART3->STATUS & USART_STATUS_TXBL));

    USART3->TXDATA = ubData;

    while(ubWait && !(USART3->STATUS & USART_STATUS_TXC));
}
#else   // USART3_MODE_SPI
static volatile uint8_t *pubUSART3DMABuffer = NULL;
static volatile uint8_t *pubUSART3FIFO = NULL;
static volatile uint16_t usUSART3FIFOWritePos, usUSART3FIFOReadPos;
static ldma_descriptor_t __attribute__ ((aligned (4))) pUSART3DMADescriptor[2];

void _usart3_rx_isr()
{
    uint32_t ulFlags = USART3->IFC;

    if(ulFlags & USART_IFC_TCMP0)
    {
        ldma_ch_peri_req_disable(USART3_DMA_CHANNEL);

        while(ldma_ch_get_busy(USART3_DMA_CHANNEL));

        uint16_t usDMAXfersLeft = ldma_ch_get_remaining_xfers(USART3_DMA_CHANNEL); // Number of half words left
        uint32_t ulSize = (USART3_DMA_RX_BUFFER_SIZE >> 1) - (usDMAXfersLeft << 1); // Multiply to get number of bytes

        if(ulSize)
        {
            volatile uint8_t *pubDMANextDst = (volatile uint8_t *)ldma_ch_get_next_dst_addr(USART3_DMA_CHANNEL);
            volatile uint8_t *pubDMABufferReadPos = pubDMANextDst >= (pubUSART3DMABuffer + (USART3_DMA_RX_BUFFER_SIZE >> 1)) ? (pubUSART3DMABuffer + (USART3_DMA_RX_BUFFER_SIZE >> 1)) : pubUSART3DMABuffer;

            while(ulSize--)
            {
                pubUSART3FIFO[usUSART3FIFOWritePos++] = *pubDMABufferReadPos++;

                if(usUSART3FIFOWritePos >= USART3_FIFO_SIZE)
                    usUSART3FIFOWritePos = 0;
            }

        }

        while(USART3->STATUS & USART_STATUS_RXDATAV)
        {
            pubUSART3FIFO[usUSART3FIFOWritePos++] = USART3->RXDATA;

            if(usUSART3FIFOWritePos >= USART3_FIFO_SIZE)
                usUSART3FIFOWritePos = 0;
        }

        ldma_ch_load(USART3_DMA_CHANNEL, pUSART3DMADescriptor);
        ldma_ch_peri_req_enable(USART3_DMA_CHANNEL);
    }
}
static void usart3_dma_isr(uint8_t ubError)
{
    if(ubError)
    {
        ldma_ch_load(USART3_DMA_CHANNEL, pUSART3DMADescriptor);

        return;
    }

    volatile uint8_t *pubDMANextDst = (volatile uint8_t *)ldma_ch_get_next_dst_addr(USART3_DMA_CHANNEL);
    volatile uint8_t *pubDMABufferReadPos = pubDMANextDst >= (pubUSART3DMABuffer + (USART3_DMA_RX_BUFFER_SIZE >> 1)) ? pubUSART3DMABuffer : (pubUSART3DMABuffer + (USART3_DMA_RX_BUFFER_SIZE >> 1)); // If next destination address is on the second buffer it means that the first buffer has just gone full, copy from the first, and vice versa

    uint32_t ulSize = (USART3_DMA_RX_BUFFER_SIZE >> 1);

    while(ulSize--)
    {
        pubUSART3FIFO[usUSART3FIFOWritePos++] = *pubDMABufferReadPos++;

        if(usUSART3FIFOWritePos >= USART3_FIFO_SIZE)
            usUSART3FIFOWritePos = 0;
    }
}

void usart3_init(uint32_t ulBaud, uint32_t ulFrameSettings, int8_t bRXLocation, int8_t bTXLocation, int8_t bCTSLocation, int8_t bRTSLocation)
{
    if(bRXLocation > -1 && bRXLocation > AFCHANLOC_MAX)
        return;

    if(bTXLocation > -1 && bTXLocation > AFCHANLOC_MAX)
        return;

    if(bCTSLocation > -1 && bCTSLocation > AFCHANLOC_MAX)
        return;

    if(bRTSLocation > -1 && bRTSLocation > AFCHANLOC_MAX)
        return;

    CMU->HFPERCLKEN0 |= CMU_HFPERCLKEN0_USART3;

    USART3->CMD = USART_CMD_CLEARRX | USART_CMD_CLEARTX | USART_CMD_TXTRIDIS | USART_CMD_RXBLOCKDIS | USART_CMD_TXDIS | USART_CMD_RXDIS;

    free((uint8_t *)pubUSART3DMABuffer);
    free((uint8_t *)pubUSART3FIFO);

    pubUSART3DMABuffer = (volatile uint8_t *)malloc(USART3_DMA_RX_BUFFER_SIZE);

    if(!pubUSART3DMABuffer)
        return;

    memset((uint8_t *)pubUSART3DMABuffer, 0, USART3_DMA_RX_BUFFER_SIZE);

    pubUSART3FIFO = (volatile uint8_t *)malloc(USART3_FIFO_SIZE);

    if(!pubUSART3FIFO)
    {
        free((void *)pubUSART3DMABuffer);

        return;
    }

    memset((uint8_t *)pubUSART3FIFO, 0, USART3_FIFO_SIZE);

    usUSART3FIFOWritePos = 0;
    usUSART3FIFOReadPos = 0;

    USART3->CTRL = USART_CTRL_TXBIL_HALFFULL | USART_CTRL_CSMA_NOACTION | USART_CTRL_OVS_X16;
    USART3->CTRLX = (bCTSLocation >= 0 ? USART_CTRLX_CTSEN : 0);
    USART3->FRAME = ulFrameSettings;
    USART3->CLKDIV = (uint32_t)((((float)HFPER_CLOCK_FREQ / (16.f * ulBaud)) - 1.f) * 256.f);

    USART3->TIMECMP0 = USART_TIMECMP0_TSTOP_RXACT | USART_TIMECMP0_TSTART_RXEOF | 0x08; // RX Timeout after 8 baud times

    USART3->ROUTEPEN = (bRXLocation >= 0 ? USART_ROUTEPEN_RXPEN : 0) | (bTXLocation >= 0 ? USART_ROUTEPEN_TXPEN : 0) | (bCTSLocation >= 0 ? USART_ROUTEPEN_CTSPEN : 0) | (bRTSLocation >= 0 ? USART_ROUTEPEN_RTSPEN : 0);
    USART3->ROUTELOC0 = ((uint32_t)(bRXLocation >= 0 ? bRXLocation : 0) << _USART_ROUTELOC0_RXLOC_SHIFT) | ((uint32_t)(bTXLocation >= 0 ? bTXLocation : 0) << _USART_ROUTELOC0_TXLOC_SHIFT);
    USART3->ROUTELOC1 = ((uint32_t)(bCTSLocation >= 0 ? bCTSLocation : 0) << _USART_ROUTELOC1_CTSLOC_SHIFT) | ((uint32_t)(bRTSLocation >= 0 ? bRTSLocation : 0) << _USART_ROUTELOC1_RTSLOC_SHIFT);

    USART3->IFC = _USART_IFC_MASK; // Clear all flags
    IRQ_CLEAR(USART3_RX_IRQn); // Clear pending vector
    IRQ_SET_PRIO(USART3_RX_IRQn, 2, 1); // Set priority 2,1
    IRQ_ENABLE(USART3_RX_IRQn); // Enable vector
    USART3->IEN |= USART_IEN_TCMP0; // Enable TCMP0 flag

    ldma_ch_disable(USART3_DMA_CHANNEL);
    ldma_ch_peri_req_disable(USART3_DMA_CHANNEL);
    ldma_ch_req_clear(USART3_DMA_CHANNEL);

    ldma_ch_config(USART3_DMA_CHANNEL, LDMA_CH_REQSEL_SOURCESEL_USART3 | LDMA_CH_REQSEL_SIGSEL_USART3RXDATAV, LDMA_CH_CFG_SRCINCSIGN_DEFAULT, LDMA_CH_CFG_DSTINCSIGN_POSITIVE, LDMA_CH_CFG_ARBSLOTS_DEFAULT, 0);
    ldma_ch_set_isr(USART3_DMA_CHANNEL, usart3_dma_isr);

    pUSART3DMADescriptor[0].CTRL = LDMA_CH_CTRL_DSTMODE_ABSOLUTE | LDMA_CH_CTRL_SRCMODE_ABSOLUTE | LDMA_CH_CTRL_DSTINC_ONE | LDMA_CH_CTRL_SIZE_HALFWORD | LDMA_CH_CTRL_SRCINC_NONE | LDMA_CH_CTRL_IGNORESREQ | LDMA_CH_CTRL_REQMODE_BLOCK | LDMA_CH_CTRL_DONEIFSEN | LDMA_CH_CTRL_BLOCKSIZE_UNIT1 | ((((USART3_DMA_RX_BUFFER_SIZE >> 2) - 1) << _LDMA_CH_CTRL_XFERCNT_SHIFT) & _LDMA_CH_CTRL_XFERCNT_MASK) | LDMA_CH_CTRL_STRUCTTYPE_TRANSFER;
    pUSART3DMADescriptor[0].SRC = (void *)&USART3->RXDOUBLE;
    pUSART3DMADescriptor[0].DST = pubUSART3DMABuffer;
    pUSART3DMADescriptor[0].LINK = 0x00000010 | LDMA_CH_LINK_LINK | LDMA_CH_LINK_LINKMODE_RELATIVE;

    pUSART3DMADescriptor[1].CTRL = pUSART3DMADescriptor[0].CTRL;
    pUSART3DMADescriptor[1].SRC = pUSART3DMADescriptor[0].SRC;
    pUSART3DMADescriptor[1].DST = pubUSART3DMABuffer + (USART3_DMA_RX_BUFFER_SIZE >> 1);
    pUSART3DMADescriptor[1].LINK = 0xFFFFFFF0 | LDMA_CH_LINK_LINK | LDMA_CH_LINK_LINKMODE_RELATIVE;

    ldma_ch_load(USART3_DMA_CHANNEL, pUSART3DMADescriptor);
    ldma_ch_peri_req_enable(USART3_DMA_CHANNEL);
    ldma_ch_enable(USART3_DMA_CHANNEL);

    USART3->CMD = (bTXLocation >= 0 ? USART_CMD_TXEN : 0) | (bRXLocation >= 0 ? USART_CMD_RXEN : 0);
}
void usart3_write_byte(const uint8_t ubData)
{
    while(!(USART3->STATUS & USART_STATUS_TXBL));

    USART3->TXDATA = ubData;
}
uint8_t usart3_read_byte()
{
    if(!usart3_available())
        return 0;

    uint8_t ubData;

    ATOMIC_BLOCK(ATOMIC_RESTORESTATE)
    {
        ubData = pubUSART3FIFO[usUSART3FIFOReadPos++];

        if(usUSART3FIFOReadPos >= USART3_FIFO_SIZE)
            usUSART3FIFOReadPos = 0;
    }

    return ubData;
}
uint32_t usart3_available()
{
    return (USART3_FIFO_SIZE + usUSART3FIFOWritePos - usUSART3FIFOReadPos) % USART3_FIFO_SIZE;
}
void usart3_flush()
{
    usUSART3FIFOReadPos = usUSART3FIFOWritePos = 0;
}
#endif  // USART3_MODE_SPI

#if defined(USART4_MODE_SPI)
void usart4_init(uint32_t ulBaud, uint8_t ubMode, uint8_t ubBitMode, int8_t bMISOLocation, int8_t bMOSILocation, uint8_t ubCLKLocation)
{
    if(bMISOLocation > -1 && bMISOLocation > AFCHANLOC_MAX)
        return;

    if(bMOSILocation > -1 && bMOSILocation > AFCHANLOC_MAX)
        return;

    if(ubCLKLocation > AFCHANLOC_MAX)
        return;

    CMU->HFPERCLKEN0 |= CMU_HFPERCLKEN0_USART4;

    USART4->CMD = USART_CMD_CLEARRX | USART_CMD_CLEARTX | USART_CMD_TXTRIDIS | USART_CMD_RXBLOCKDIS | USART_CMD_TXDIS | USART_CMD_RXDIS;

    USART4->CTRL = USART_CTRL_TXBIL_EMPTY | USART_CTRL_CSMA_NOACTION | (ubBitMode == USART_SPI_MSB_FIRST ? USART_CTRL_MSBF : 0) | (ubMode & 1 ? USART_CTRL_CLKPHA_SAMPLETRAILING : USART_CTRL_CLKPHA_SAMPLELEADING) | (ubMode & 2 ? USART_CTRL_CLKPOL_IDLEHIGH : USART_CTRL_CLKPOL_IDLELOW) | USART_CTRL_SYNC;
    USART4->FRAME = USART_FRAME_DATABITS_EIGHT;
    USART4->CLKDIV = (uint32_t)((((float)HFPER_CLOCK_FREQ / (2.f * ulBaud)) - 1.f) * 256.f);

    USART4->ROUTEPEN = (bMISOLocation >= 0 ? USART_ROUTEPEN_RXPEN : 0) | (bMOSILocation >= 0 ? USART_ROUTEPEN_TXPEN : 0) | USART_ROUTEPEN_CLKPEN;
    USART4->ROUTELOC0 = ((uint32_t)(bMISOLocation >= 0 ? bMISOLocation : 0) << _USART_ROUTELOC0_RXLOC_SHIFT) | ((uint32_t)(bMOSILocation >= 0 ? bMOSILocation : 0) << _USART_ROUTELOC0_TXLOC_SHIFT) | ((uint32_t)ubCLKLocation << _USART_ROUTELOC0_CLKLOC_SHIFT);

    USART4->CMD = USART_CMD_MASTEREN | (bMOSILocation >= 0 ? USART_CMD_TXEN : 0) | (bMISOLocation >= 0 ? USART_CMD_RXEN : 0);
}
uint8_t usart4_spi_transfer_byte(const uint8_t ubData)
{
    while(USART4->STATUS & _USART_STATUS_TXBUFCNT_MASK);

    USART4->CMD = USART_CMD_CLEARRX;

    USART4->TXDATA = ubData;

    while(!(USART4->STATUS & USART_STATUS_TXC));

    return USART4->RXDATA;
}
void usart4_spi_write_byte(const uint8_t ubData, const uint8_t ubWait)
{
    while(!(USART4->STATUS & USART_STATUS_TXBL));

    USART4->TXDATA = ubData;

    while(ubWait && !(USART4->STATUS & USART_STATUS_TXC));
}
#else   // USART4_MODE_SPI
static volatile uint8_t *pubUSART4DMABuffer = NULL;
static volatile uint8_t *pubUSART4FIFO = NULL;
static volatile uint16_t usUSART4FIFOWritePos, usUSART4FIFOReadPos;
static ldma_descriptor_t __attribute__ ((aligned (4))) pUSART4DMADescriptor[2];

void _usart4_rx_isr()
{
    uint32_t ulFlags = USART4->IFC;

    if(ulFlags & USART_IFC_TCMP0)
    {
        ldma_ch_peri_req_disable(USART4_DMA_CHANNEL);

        while(ldma_ch_get_busy(USART4_DMA_CHANNEL));

        uint16_t usDMAXfersLeft = ldma_ch_get_remaining_xfers(USART4_DMA_CHANNEL); // Number of half words left
        uint32_t ulSize = (USART4_DMA_RX_BUFFER_SIZE >> 1) - (usDMAXfersLeft << 1); // Multiply to get number of bytes

        if(ulSize)
        {
            volatile uint8_t *pubDMANextDst = (volatile uint8_t *)ldma_ch_get_next_dst_addr(USART4_DMA_CHANNEL);
            volatile uint8_t *pubDMABufferReadPos = pubDMANextDst >= (pubUSART4DMABuffer + (USART4_DMA_RX_BUFFER_SIZE >> 1)) ? (pubUSART4DMABuffer + (USART4_DMA_RX_BUFFER_SIZE >> 1)) : pubUSART4DMABuffer;

            while(ulSize--)
            {
                pubUSART4FIFO[usUSART4FIFOWritePos++] = *pubDMABufferReadPos++;

                if(usUSART4FIFOWritePos >= USART4_FIFO_SIZE)
                    usUSART4FIFOWritePos = 0;
            }

        }

        while(USART4->STATUS & USART_STATUS_RXDATAV)
        {
            pubUSART4FIFO[usUSART4FIFOWritePos++] = USART4->RXDATA;

            if(usUSART4FIFOWritePos >= USART4_FIFO_SIZE)
                usUSART4FIFOWritePos = 0;
        }

        ldma_ch_load(USART4_DMA_CHANNEL, pUSART4DMADescriptor);
        ldma_ch_peri_req_enable(USART4_DMA_CHANNEL);
    }
}
static void usart4_dma_isr(uint8_t ubError)
{
    if(ubError)
    {
        ldma_ch_load(USART4_DMA_CHANNEL, pUSART4DMADescriptor);

        return;
    }

    volatile uint8_t *pubDMANextDst = (volatile uint8_t *)ldma_ch_get_next_dst_addr(USART4_DMA_CHANNEL);
    volatile uint8_t *pubDMABufferReadPos = pubDMANextDst >= (pubUSART4DMABuffer + (USART4_DMA_RX_BUFFER_SIZE >> 1)) ? pubUSART4DMABuffer : (pubUSART4DMABuffer + (USART4_DMA_RX_BUFFER_SIZE >> 1)); // If next destination address is on the second buffer it means that the first buffer has just gone full, copy from the first, and vice versa

    uint32_t ulSize = (USART4_DMA_RX_BUFFER_SIZE >> 1);

    while(ulSize--)
    {
        pubUSART4FIFO[usUSART4FIFOWritePos++] = *pubDMABufferReadPos++;

        if(usUSART4FIFOWritePos >= USART4_FIFO_SIZE)
            usUSART4FIFOWritePos = 0;
    }
}

void usart4_init(uint32_t ulBaud, uint32_t ulFrameSettings, int8_t bRXLocation, int8_t bTXLocation, int8_t bCTSLocation, int8_t bRTSLocation)
{
    if(bRXLocation > -1 && bRXLocation > AFCHANLOC_MAX)
        return;

    if(bTXLocation > -1 && bTXLocation > AFCHANLOC_MAX)
        return;

    if(bCTSLocation > -1 && bCTSLocation > AFCHANLOC_MAX)
        return;

    if(bRTSLocation > -1 && bRTSLocation > AFCHANLOC_MAX)
        return;

    CMU->HFPERCLKEN0 |= CMU_HFPERCLKEN0_USART4;

    USART4->CMD = USART_CMD_CLEARRX | USART_CMD_CLEARTX | USART_CMD_TXTRIDIS | USART_CMD_RXBLOCKDIS | USART_CMD_TXDIS | USART_CMD_RXDIS;

    free((uint8_t *)pubUSART4DMABuffer);
    free((uint8_t *)pubUSART4FIFO);

    pubUSART4DMABuffer = (volatile uint8_t *)malloc(USART4_DMA_RX_BUFFER_SIZE);

    if(!pubUSART4DMABuffer)
        return;

    memset((uint8_t *)pubUSART4DMABuffer, 0, USART4_DMA_RX_BUFFER_SIZE);

    pubUSART4FIFO = (volatile uint8_t *)malloc(USART4_FIFO_SIZE);

    if(!pubUSART4FIFO)
    {
        free((void *)pubUSART4DMABuffer);

        return;
    }

    memset((uint8_t *)pubUSART4FIFO, 0, USART4_FIFO_SIZE);

    usUSART4FIFOWritePos = 0;
    usUSART4FIFOReadPos = 0;

    USART4->CTRL = USART_CTRL_TXBIL_HALFFULL | USART_CTRL_CSMA_NOACTION | USART_CTRL_OVS_X16;
    USART4->CTRLX = (bCTSLocation >= 0 ? USART_CTRLX_CTSEN : 0);
    USART4->FRAME = ulFrameSettings;
    USART4->CLKDIV = (uint32_t)((((float)HFPER_CLOCK_FREQ / (16.f * ulBaud)) - 1.f) * 256.f);

    USART4->TIMECMP0 = USART_TIMECMP0_TSTOP_RXACT | USART_TIMECMP0_TSTART_RXEOF | 0x08; // RX Timeout after 8 baud times

    USART4->ROUTEPEN = (bRXLocation >= 0 ? USART_ROUTEPEN_RXPEN : 0) | (bTXLocation >= 0 ? USART_ROUTEPEN_TXPEN : 0) | (bCTSLocation >= 0 ? USART_ROUTEPEN_CTSPEN : 0) | (bRTSLocation >= 0 ? USART_ROUTEPEN_RTSPEN : 0);
    USART4->ROUTELOC0 = ((uint32_t)(bRXLocation >= 0 ? bRXLocation : 0) << _USART_ROUTELOC0_RXLOC_SHIFT) | ((uint32_t)(bTXLocation >= 0 ? bTXLocation : 0) << _USART_ROUTELOC0_TXLOC_SHIFT);
    USART4->ROUTELOC1 = ((uint32_t)(bCTSLocation >= 0 ? bCTSLocation : 0) << _USART_ROUTELOC1_CTSLOC_SHIFT) | ((uint32_t)(bRTSLocation >= 0 ? bRTSLocation : 0) << _USART_ROUTELOC1_RTSLOC_SHIFT);

    USART4->IFC = _USART_IFC_MASK; // Clear all flags
    IRQ_CLEAR(USART4_RX_IRQn); // Clear pending vector
    IRQ_SET_PRIO(USART4_RX_IRQn, 2, 1); // Set priority 2,1
    IRQ_ENABLE(USART4_RX_IRQn); // Enable vector
    USART4->IEN |= USART_IEN_TCMP0; // Enable TCMP0 flag

    ldma_ch_disable(USART4_DMA_CHANNEL);
    ldma_ch_peri_req_disable(USART4_DMA_CHANNEL);
    ldma_ch_req_clear(USART4_DMA_CHANNEL);

    ldma_ch_config(USART4_DMA_CHANNEL, LDMA_CH_REQSEL_SOURCESEL_USART4 | LDMA_CH_REQSEL_SIGSEL_USART4RXDATAV, LDMA_CH_CFG_SRCINCSIGN_DEFAULT, LDMA_CH_CFG_DSTINCSIGN_POSITIVE, LDMA_CH_CFG_ARBSLOTS_DEFAULT, 0);
    ldma_ch_set_isr(USART4_DMA_CHANNEL, usart4_dma_isr);

    pUSART4DMADescriptor[0].CTRL = LDMA_CH_CTRL_DSTMODE_ABSOLUTE | LDMA_CH_CTRL_SRCMODE_ABSOLUTE | LDMA_CH_CTRL_DSTINC_ONE | LDMA_CH_CTRL_SIZE_HALFWORD | LDMA_CH_CTRL_SRCINC_NONE | LDMA_CH_CTRL_IGNORESREQ | LDMA_CH_CTRL_REQMODE_BLOCK | LDMA_CH_CTRL_DONEIFSEN | LDMA_CH_CTRL_BLOCKSIZE_UNIT1 | ((((USART4_DMA_RX_BUFFER_SIZE >> 2) - 1) << _LDMA_CH_CTRL_XFERCNT_SHIFT) & _LDMA_CH_CTRL_XFERCNT_MASK) | LDMA_CH_CTRL_STRUCTTYPE_TRANSFER;
    pUSART4DMADescriptor[0].SRC = (void *)&USART4->RXDOUBLE;
    pUSART4DMADescriptor[0].DST = pubUSART4DMABuffer;
    pUSART4DMADescriptor[0].LINK = 0x00000010 | LDMA_CH_LINK_LINK | LDMA_CH_LINK_LINKMODE_RELATIVE;

    pUSART4DMADescriptor[1].CTRL = pUSART4DMADescriptor[0].CTRL;
    pUSART4DMADescriptor[1].SRC = pUSART4DMADescriptor[0].SRC;
    pUSART4DMADescriptor[1].DST = pubUSART4DMABuffer + (USART4_DMA_RX_BUFFER_SIZE >> 1);
    pUSART4DMADescriptor[1].LINK = 0xFFFFFFF0 | LDMA_CH_LINK_LINK | LDMA_CH_LINK_LINKMODE_RELATIVE;

    ldma_ch_load(USART4_DMA_CHANNEL, pUSART4DMADescriptor);
    ldma_ch_peri_req_enable(USART4_DMA_CHANNEL);
    ldma_ch_enable(USART4_DMA_CHANNEL);

    USART4->CMD = (bTXLocation >= 0 ? USART_CMD_TXEN : 0) | (bRXLocation >= 0 ? USART_CMD_RXEN : 0);
}
void usart4_write_byte(const uint8_t ubData)
{
    while(!(USART4->STATUS & USART_STATUS_TXBL));

    USART4->TXDATA = ubData;
}
uint8_t usart4_read_byte()
{
    if(!usart4_available())
        return 0;

    uint8_t ubData;

    ATOMIC_BLOCK(ATOMIC_RESTORESTATE)
    {
        ubData = pubUSART4FIFO[usUSART4FIFOReadPos++];

        if(usUSART4FIFOReadPos >= USART4_FIFO_SIZE)
            usUSART4FIFOReadPos = 0;
    }

    return ubData;
}
uint32_t usart4_available()
{
    return (USART4_FIFO_SIZE + usUSART4FIFOWritePos - usUSART4FIFOReadPos) % USART4_FIFO_SIZE;
}
void usart4_flush()
{
    usUSART4FIFOReadPos = usUSART4FIFOWritePos = 0;
}
#endif  // USART4_MODE_SPI

#if defined(USART5_MODE_SPI)
void usart5_init(uint32_t ulBaud, uint8_t ubMode, uint8_t ubBitMode, int8_t bMISOLocation, int8_t bMOSILocation, uint8_t ubCLKLocation)
{
    if(bMISOLocation > -1 && bMISOLocation > AFCHANLOC_MAX)
        return;

    if(bMOSILocation > -1 && bMOSILocation > AFCHANLOC_MAX)
        return;

    if(ubCLKLocation > AFCHANLOC_MAX)
        return;

    CMU->HFPERCLKEN0 |= CMU_HFPERCLKEN0_USART5;

    USART5->CMD = USART_CMD_CLEARRX | USART_CMD_CLEARTX | USART_CMD_TXTRIDIS | USART_CMD_RXBLOCKDIS | USART_CMD_TXDIS | USART_CMD_RXDIS;

    USART5->CTRL = USART_CTRL_TXBIL_EMPTY | USART_CTRL_CSMA_NOACTION | (ubBitMode == USART_SPI_MSB_FIRST ? USART_CTRL_MSBF : 0) | (ubMode & 1 ? USART_CTRL_CLKPHA_SAMPLETRAILING : USART_CTRL_CLKPHA_SAMPLELEADING) | (ubMode & 2 ? USART_CTRL_CLKPOL_IDLEHIGH : USART_CTRL_CLKPOL_IDLELOW) | USART_CTRL_SYNC;
    USART5->FRAME = USART_FRAME_DATABITS_EIGHT;
    USART5->CLKDIV = (uint32_t)((((float)HFPER_CLOCK_FREQ / (2.f * ulBaud)) - 1.f) * 256.f);

    USART5->ROUTEPEN = (bMISOLocation >= 0 ? USART_ROUTEPEN_RXPEN : 0) | (bMOSILocation >= 0 ? USART_ROUTEPEN_TXPEN : 0) | USART_ROUTEPEN_CLKPEN;
    USART5->ROUTELOC0 = ((uint32_t)(bMISOLocation >= 0 ? bMISOLocation : 0) << _USART_ROUTELOC0_RXLOC_SHIFT) | ((uint32_t)(bMOSILocation >= 0 ? bMOSILocation : 0) << _USART_ROUTELOC0_TXLOC_SHIFT) | ((uint32_t)ubCLKLocation << _USART_ROUTELOC0_CLKLOC_SHIFT);

    USART5->CMD = USART_CMD_MASTEREN | (bMOSILocation >= 0 ? USART_CMD_TXEN : 0) | (bMISOLocation >= 0 ? USART_CMD_RXEN : 0);
}
uint8_t usart5_spi_transfer_byte(const uint8_t ubData)
{
    while(USART5->STATUS & _USART_STATUS_TXBUFCNT_MASK);

    USART5->CMD = USART_CMD_CLEARRX;

    USART5->TXDATA = ubData;

    while(!(USART5->STATUS & USART_STATUS_TXC));

    return USART5->RXDATA;
}
void usart5_spi_write_byte(const uint8_t ubData, const uint8_t ubWait)
{
    while(!(USART5->STATUS & USART_STATUS_TXBL));

    USART5->TXDATA = ubData;

    while(ubWait && !(USART5->STATUS & USART_STATUS_TXC));
}
#else   // USART5_MODE_SPI
static volatile uint8_t *pubUSART5DMABuffer = NULL;
static volatile uint8_t *pubUSART5FIFO = NULL;
static volatile uint16_t usUSART5FIFOWritePos, usUSART5FIFOReadPos;
static ldma_descriptor_t __attribute__ ((aligned (4))) pUSART5DMADescriptor[2];

void _usart5_rx_isr()
{
    uint32_t ulFlags = USART5->IFC;

    if(ulFlags & USART_IFC_TCMP0)
    {
        ldma_ch_peri_req_disable(USART5_DMA_CHANNEL);

        while(ldma_ch_get_busy(USART5_DMA_CHANNEL));

        uint16_t usDMAXfersLeft = ldma_ch_get_remaining_xfers(USART5_DMA_CHANNEL); // Number of half words left
        uint32_t ulSize = (USART5_DMA_RX_BUFFER_SIZE >> 1) - (usDMAXfersLeft << 1); // Multiply to get number of bytes

        if(ulSize)
        {
            volatile uint8_t *pubDMANextDst = (volatile uint8_t *)ldma_ch_get_next_dst_addr(USART5_DMA_CHANNEL);
            volatile uint8_t *pubDMABufferReadPos = pubDMANextDst >= (pubUSART5DMABuffer + (USART5_DMA_RX_BUFFER_SIZE >> 1)) ? (pubUSART5DMABuffer + (USART5_DMA_RX_BUFFER_SIZE >> 1)) : pubUSART5DMABuffer;

            while(ulSize--)
            {
                pubUSART5FIFO[usUSART5FIFOWritePos++] = *pubDMABufferReadPos++;

                if(usUSART5FIFOWritePos >= USART5_FIFO_SIZE)
                    usUSART5FIFOWritePos = 0;
            }

        }

        while(USART5->STATUS & USART_STATUS_RXDATAV)
        {
            pubUSART5FIFO[usUSART5FIFOWritePos++] = USART5->RXDATA;

            if(usUSART5FIFOWritePos >= USART5_FIFO_SIZE)
                usUSART5FIFOWritePos = 0;
        }

        ldma_ch_load(USART5_DMA_CHANNEL, pUSART5DMADescriptor);
        ldma_ch_peri_req_enable(USART5_DMA_CHANNEL);
    }
}
static void usart5_dma_isr(uint8_t ubError)
{
    if(ubError)
    {
        ldma_ch_load(USART5_DMA_CHANNEL, pUSART5DMADescriptor);

        return;
    }

    volatile uint8_t *pubDMANextDst = (volatile uint8_t *)ldma_ch_get_next_dst_addr(USART5_DMA_CHANNEL);
    volatile uint8_t *pubDMABufferReadPos = pubDMANextDst >= (pubUSART5DMABuffer + (USART5_DMA_RX_BUFFER_SIZE >> 1)) ? pubUSART5DMABuffer : (pubUSART5DMABuffer + (USART5_DMA_RX_BUFFER_SIZE >> 1)); // If next destination address is on the second buffer it means that the first buffer has just gone full, copy from the first, and vice versa

    uint32_t ulSize = (USART5_DMA_RX_BUFFER_SIZE >> 1);

    while(ulSize--)
    {
        pubUSART5FIFO[usUSART5FIFOWritePos++] = *pubDMABufferReadPos++;

        if(usUSART5FIFOWritePos >= USART5_FIFO_SIZE)
            usUSART5FIFOWritePos = 0;
    }
}

void usart5_init(uint32_t ulBaud, uint32_t ulFrameSettings, int8_t bRXLocation, int8_t bTXLocation, int8_t bCTSLocation, int8_t bRTSLocation)
{
    if(bRXLocation > -1 && bRXLocation > AFCHANLOC_MAX)
        return;

    if(bTXLocation > -1 && bTXLocation > AFCHANLOC_MAX)
        return;

    if(bCTSLocation > -1 && bCTSLocation > AFCHANLOC_MAX)
        return;

    if(bRTSLocation > -1 && bRTSLocation > AFCHANLOC_MAX)
        return;

    CMU->HFPERCLKEN0 |= CMU_HFPERCLKEN0_USART5;

    USART5->CMD = USART_CMD_CLEARRX | USART_CMD_CLEARTX | USART_CMD_TXTRIDIS | USART_CMD_RXBLOCKDIS | USART_CMD_TXDIS | USART_CMD_RXDIS;

    free((uint8_t *)pubUSART5DMABuffer);
    free((uint8_t *)pubUSART5FIFO);

    pubUSART5DMABuffer = (volatile uint8_t *)malloc(USART5_DMA_RX_BUFFER_SIZE);

    if(!pubUSART5DMABuffer)
        return;

    memset((uint8_t *)pubUSART5DMABuffer, 0, USART5_DMA_RX_BUFFER_SIZE);

    pubUSART5FIFO = (volatile uint8_t *)malloc(USART5_FIFO_SIZE);

    if(!pubUSART5FIFO)
    {
        free((void *)pubUSART5DMABuffer);

        return;
    }

    memset((uint8_t *)pubUSART5FIFO, 0, USART5_FIFO_SIZE);

    usUSART5FIFOWritePos = 0;
    usUSART5FIFOReadPos = 0;

    USART5->CTRL = USART_CTRL_TXBIL_HALFFULL | USART_CTRL_CSMA_NOACTION | USART_CTRL_OVS_X16;
    USART5->CTRLX = (bCTSLocation >= 0 ? USART_CTRLX_CTSEN : 0);
    USART5->FRAME = ulFrameSettings;
    USART5->CLKDIV = (uint32_t)((((float)HFPER_CLOCK_FREQ / (16.f * ulBaud)) - 1.f) * 256.f);

    USART5->TIMECMP0 = USART_TIMECMP0_TSTOP_RXACT | USART_TIMECMP0_TSTART_RXEOF | 0x08; // RX Timeout after 8 baud times

    USART5->ROUTEPEN = (bRXLocation >= 0 ? USART_ROUTEPEN_RXPEN : 0) | (bTXLocation >= 0 ? USART_ROUTEPEN_TXPEN : 0) | (bCTSLocation >= 0 ? USART_ROUTEPEN_CTSPEN : 0) | (bRTSLocation >= 0 ? USART_ROUTEPEN_RTSPEN : 0);
    USART5->ROUTELOC0 = ((uint32_t)(bRXLocation >= 0 ? bRXLocation : 0) << _USART_ROUTELOC0_RXLOC_SHIFT) | ((uint32_t)(bTXLocation >= 0 ? bTXLocation : 0) << _USART_ROUTELOC0_TXLOC_SHIFT);
    USART5->ROUTELOC1 = ((uint32_t)(bCTSLocation >= 0 ? bCTSLocation : 0) << _USART_ROUTELOC1_CTSLOC_SHIFT) | ((uint32_t)(bRTSLocation >= 0 ? bRTSLocation : 0) << _USART_ROUTELOC1_RTSLOC_SHIFT);

    USART5->IFC = _USART_IFC_MASK; // Clear all flags
    IRQ_CLEAR(USART5_RX_IRQn); // Clear pending vector
    IRQ_SET_PRIO(USART5_RX_IRQn, 2, 1); // Set priority 2,1
    IRQ_ENABLE(USART5_RX_IRQn); // Enable vector
    USART5->IEN |= USART_IEN_TCMP0; // Enable TCMP0 flag

    ldma_ch_disable(USART5_DMA_CHANNEL);
    ldma_ch_peri_req_disable(USART5_DMA_CHANNEL);
    ldma_ch_req_clear(USART5_DMA_CHANNEL);

    ldma_ch_config(USART5_DMA_CHANNEL, LDMA_CH_REQSEL_SOURCESEL_USART5 | LDMA_CH_REQSEL_SIGSEL_USART5RXDATAV, LDMA_CH_CFG_SRCINCSIGN_DEFAULT, LDMA_CH_CFG_DSTINCSIGN_POSITIVE, LDMA_CH_CFG_ARBSLOTS_DEFAULT, 0);
    ldma_ch_set_isr(USART5_DMA_CHANNEL, usart5_dma_isr);

    pUSART5DMADescriptor[0].CTRL = LDMA_CH_CTRL_DSTMODE_ABSOLUTE | LDMA_CH_CTRL_SRCMODE_ABSOLUTE | LDMA_CH_CTRL_DSTINC_ONE | LDMA_CH_CTRL_SIZE_HALFWORD | LDMA_CH_CTRL_SRCINC_NONE | LDMA_CH_CTRL_IGNORESREQ | LDMA_CH_CTRL_REQMODE_BLOCK | LDMA_CH_CTRL_DONEIFSEN | LDMA_CH_CTRL_BLOCKSIZE_UNIT1 | ((((USART5_DMA_RX_BUFFER_SIZE >> 2) - 1) << _LDMA_CH_CTRL_XFERCNT_SHIFT) & _LDMA_CH_CTRL_XFERCNT_MASK) | LDMA_CH_CTRL_STRUCTTYPE_TRANSFER;
    pUSART5DMADescriptor[0].SRC = (void *)&USART5->RXDOUBLE;
    pUSART5DMADescriptor[0].DST = pubUSART5DMABuffer;
    pUSART5DMADescriptor[0].LINK = 0x00000010 | LDMA_CH_LINK_LINK | LDMA_CH_LINK_LINKMODE_RELATIVE;

    pUSART5DMADescriptor[1].CTRL = pUSART5DMADescriptor[0].CTRL;
    pUSART5DMADescriptor[1].SRC = pUSART5DMADescriptor[0].SRC;
    pUSART5DMADescriptor[1].DST = pubUSART5DMABuffer + (USART5_DMA_RX_BUFFER_SIZE >> 1);
    pUSART5DMADescriptor[1].LINK = 0xFFFFFFF0 | LDMA_CH_LINK_LINK | LDMA_CH_LINK_LINKMODE_RELATIVE;

    ldma_ch_load(USART5_DMA_CHANNEL, pUSART5DMADescriptor);
    ldma_ch_peri_req_enable(USART5_DMA_CHANNEL);
    ldma_ch_enable(USART5_DMA_CHANNEL);

    USART5->CMD = (bTXLocation >= 0 ? USART_CMD_TXEN : 0) | (bRXLocation >= 0 ? USART_CMD_RXEN : 0);
}
void usart5_write_byte(const uint8_t ubData)
{
    while(!(USART5->STATUS & USART_STATUS_TXBL));

    USART5->TXDATA = ubData;
}
uint8_t usart5_read_byte()
{
    if(!usart5_available())
        return 0;

    uint8_t ubData;

    ATOMIC_BLOCK(ATOMIC_RESTORESTATE)
    {
        ubData = pubUSART5FIFO[usUSART5FIFOReadPos++];

        if(usUSART5FIFOReadPos >= USART5_FIFO_SIZE)
            usUSART5FIFOReadPos = 0;
    }

    return ubData;
}
uint32_t usart5_available()
{
    return (USART5_FIFO_SIZE + usUSART5FIFOWritePos - usUSART5FIFOReadPos) % USART5_FIFO_SIZE;
}
void usart5_flush()
{
    usUSART5FIFOReadPos = usUSART5FIFOWritePos = 0;
}
#endif  // USART5_MODE_SPI
