pepetech/iot-gateway/software/main/src/include/ft6x06.h

#ifndef __FT6X06_H__
#define __FT6X06_H__

#include <em_device.h>
#include <stdlib.h>
#include "systick.h"
#include "atomic.h"
#include "gpio.h"
#include "i2c.h"

#include "debug_macros.h"

#define FT6X06_I2C_ADDR 0x38

// Registers
#define FT6X06_DEV_MODE                 0x00
#define FT6X06_GEST_ID                  0x01
#define FT6X06_TD_STATUS                0x02
#define FT6X06_P1_XH                    0x03
#define FT6X06_P1_XL                    0x04
#define FT6X06_P1_YH                    0x05
#define FT6X06_P1_YL                    0x06
#define FT6X06_P1_WEIGHT                0x07
#define FT6X06_P1_MISC                  0x08
#define FT6X06_P2_XH                    0x09
#define FT6X06_P2_XL                    0x0A
#define FT6X06_P2_YH                    0x0B
#define FT6X06_P2_YL                    0x0C
#define FT6X06_P2_WEIGHT                0x0D
#define FT6X06_P2_MISC                  0x0E
#define FT6X06_TH_GROUP                 0x80
#define FT6X06_TH_DIFF                  0x85
#define FT6X06_CTRL                     0x86
#define FT6X06_TIMEENTERMONITOR         0x87
#define FT6X06_PERIODACTIVE             0x88
#define FT6X06_PERIODMONITOR            0x89
#define FT6X06_RADIAN_VALUE             0x91
#define FT6X06_OFFSET_LEFT_RIGHT        0x92
#define FT6X06_OFFSET_UP_DOWN           0x19
#define FT6X06_DISTANCE_LEFT_RIGHT      0x94
#define FT6X06_DISTANCE_UP_DOWN         0x95
#define FT6X06_DISTANCE_ZOOM            0x96
#define FT6X06_LIB_VER_H                0xA1
#define FT6X06_LIB_VER_L                0xA2
#define FT6X06_CIPHER                   0xA3
#define FT6X06_G_MODE                   0xA4
#define FT6X06_PWR_MODE                 0xA5
#define FT6X06_FIRMID                   0xA6
#define FT6X06_FOCALTECH_ID             0xA8
#define FT6X06_RELEASE_CODE_ID          0xAF
#define FT6X06_STATE                    0xBC

// Device Mode
#define FT6X06_WORKING_MODE     0b000
#define FT6X06_FACTORY_MODE     0b100

// Gesture ID
#define FT6X06_MOVE_UP          0x10
#define FT6X06_MOVE_RIGHT       0x14
#define FT6X06_MOVE_DOWN        0x18
#define FT6X06_MOVE_LEFT        0x1C
#define FT6X06_ZOOM_IN          0x48
#define FT6X06_ZOOM_OUT         0x49
#define FT6X06_NO_GESTURE       0x00

// Valid touch point
#define FT6X06_VALID_TP         0x0F

// Event Flag
#define FT6X06_EVNT_PRESS_DOWN  0b00
#define FT6X06_EVNT_LIFT_UP     0b01
#define FT6X06_EVNT_CONTACT     0b10
#define FT6X06_EVNT_NO_EVENT    0b11

// ID's (verification pending)
#define FT62XX_VENDID 0x11
#define FT6206_CHIPID 0x06
#define FT6236_CHIPID 0x36
#define FT6236U_CHIPID 0x64

typedef struct
{
    uint8_t ubID;
    uint8_t ubStat;
    uint8_t ubEvnt1;
    uint16_t usX1;
    uint16_t usY1;
    uint8_t ubZ1;       // touch pressure
    uint8_t ubA1;       // touch Area
    uint8_t ubEvnt2;
    uint16_t usX2;
    uint16_t usY2;
    uint8_t ubZ2;       // touch pressure
    uint8_t ubA2;       // touch Area
} touch_points_t;

uint8_t ft6x06_init();

uint8_t ft6x06_get_vendor_id();
uint8_t ft6x06_get_chip_id();
uint8_t ft6x06_get_firmware_version();

uint8_t ft6x06_get_point_rate();
uint8_t ft6x06_get_threshold();
void ft6x06_set_threshold(uint8_t ubThreshold);

uint8_t ft6x06_get_touch_stat();

void ft6x06_get_points(touch_points_t *pTpData);

#endif // __FT6X06_H__
