pepetech/iot-gateway/software/wifi/bootloader/src/include/loader.h

const uint32_t entry_addr = 0x4010fcb4;

const uint32_t _text_addr = 0x4010fc00;
const uint32_t _text_len = 192;
const uint8_t  _text_data[] = {
	0x00, 0x00, 0x00, 0x00, 0x00, 0x00, 0x00, 0x00, 0x00, 0x00, 0x00, 0x00, 0x00, 0x00, 0x00, 0x00,
	0x00, 0x00, 0x00, 0x00, 0x00, 0x00, 0x00, 0x00, 0x00, 0x00, 0x00, 0x00, 0x00, 0x00, 0x00, 0x00,
	0x00, 0x00, 0x00, 0x00, 0x00, 0x00, 0x00, 0x00, 0x00, 0x00, 0x00, 0x00, 0x00, 0x00, 0x00, 0x00,
	0x00, 0x10, 0x00, 0x00, 0x1c, 0x4b, 0x00, 0x40, 0x12, 0xc1, 0xc0, 0xc9, 0xe1, 0x8b, 0x31, 0xcd,
	0x02, 0x0c, 0x84, 0xe9, 0xc1, 0xf9, 0xb1, 0x09, 0xf1, 0xd9, 0xd1, 0xc2, 0xcc, 0x08, 0x01, 0xf9,
	0xff, 0xc0, 0x00, 0x00, 0xf8, 0x31, 0xe2, 0x01, 0x09, 0x86, 0x10, 0x00, 0x2d, 0x0c, 0x3d, 0x01,
	0x0c, 0x84, 0x01, 0xf4, 0xff, 0xc0, 0x00, 0x00, 0x8b, 0xcc, 0x78, 0x01, 0xd8, 0x11, 0x46, 0x09,
	0x00, 0x21, 0xef, 0xff, 0x5d, 0x0d, 0xd7, 0xb2, 0x02, 0x20, 0x52, 0x20, 0x2d, 0x0c, 0x3d, 0x07,
	0x4d, 0x05, 0x59, 0x51, 0x79, 0x41, 0x01, 0xeb, 0xff, 0xc0, 0x00, 0x00, 0x58, 0x51, 0x78, 0x41,
	0x5a, 0xcc, 0x5a, 0x77, 0x50, 0xdd, 0xc0, 0x56, 0x6d, 0xfd, 0x0b, 0x6e, 0x60, 0xe0, 0x74, 0x56,
	0x9e, 0xfb, 0x08, 0xf1, 0x2d, 0x0f, 0xc8, 0xe1, 0xd8, 0xd1, 0xe8, 0xc1, 0xf8, 0xb1, 0x12, 0xc1,
	0x40, 0x0d, 0xf0, 0x00, 0xfd, 0x00, 0x05, 0xf8, 0xff, 0x0d, 0x0f, 0xa0, 0x02, 0x00, 0x0d, 0xf0,
};
