pepetech/iot-gateway/(commit log)

2019-03-24 Change libs to new scheme
    [iot_gateway.brd, iot_gateway.sch]
2019-03-24 Fix typo in library name
    [iot_gateway.sch]
2019-03-25 Update libraries
    [iot_gateway.brd, iot_gateway.sch]
2019-03-26 Final board ordered
    [iot_gateway.brd, iot_gateway.sch]
2019-03-27 Add .gitignore to PCB files
2019-03-30 Change gateway sch frame
    [iot_gateway.brd, iot_gateway.sch]
2019-04-16 pin defaults corrections
2019-04-16 added display driver
2019-04-16 Add backlight PWM. Add print of battery status
2019-04-18 Add SPI slave Added IO configuration Added new register bits
2019-04-19 Organize GPIO comments Add power rail measurements
2019-04-20 Work on wifi SPI slave
2019-04-20 Experiment with OPAMP + ACMP to monitor battery
2019-04-20 More ACMP work Add external interrupts
2019-04-21 Typo fixes Added USART DMA (needs testing)
    [bmp280.c, main.c, usart.c, usart.h]
2019-04-21 Forgot to switch USART back to SPI mode
2019-04-24 Random changes and typo fixes
    [adc.c, gpio.c, main.c]
2019-04-25 Use I2C macros Add CCS811 header Add SI7021 header
2019-04-29 Tested SI1145 Fixed RMU library
    [main.c]
2019-04-30 added driver for the tft touch controller
2019-04-30 Fix WS2812 and FT6x36
    [ft6x36.c, gpio.c, gpio.h, main.c, ws2812b.c]
2019-04-30 i2c bugfixing
2019-05-03 display button funcionality
2019-05-03 display draw button minor fix
    [main.c, tft.c]
2019-05-06 Fix hardware errors
    [iot_gateway.brd, iot_gateway.sch]
2019-05-06 Add most recent gerbers
2019-05-30 Fix typos and enable Flash prefetching
    [usart.c]
2019-05-30 Allow DCDC 0 mA reverse current
2019-07-09 Fix bug in RFM69 library
    [rfm69.c]
2019-08-05 Zero variables before i2c read
2019-08-05 Huge code rework Changed ILI9488 read id function, needs testing All code needs testing
    [blob_fifo.c, blob_fifo.h, bmp280.c, bmp280.h, ccs811.c, ccs811.h, ft6x36.c, gpio.h]
2019-12-14 Start schematic redesign
    [iot-gateway.brd, iot-gateway.sch, iot_gateway.brd]
2019-12-27 Big changes to main schematic Finished USB/PD daughter board
    [iot-gateway-main.brd, iot-gateway-main.sch, iot-gateway-usb-pd.brd, iot-gateway-usb-pd.sch, iot-gateway.sch]
2019-12-28 Place everything important inside the board space and start routing
    [iot-gateway-main.brd, iot-gateway-main.sch, iot-gateway-usb-pd.brd, iot-gateway-usb-pd.sch]
2019-12-28 Add case 3D models
    [iot-gateway-box.stl, iot-gateway-cover.stl, iot-gateway-usb-pd.brd]
2019-12-28 Connect IOs to MCU
    [iot-gateway-main.brd, iot-gateway-main.sch, iot-gateway-usb-pd.brd]
2019-12-31 Update libraries Finish routing Generate schematic PDF files
    [iot-gateway-main.brd, iot-gateway-main.sch, iot-gateway-usb-pd.sch]
2020-01-01 Start machine gun process
    [iot-gateway-main.brd]
2020-01-02 Maybe finished?
    [iot-gateway-main.brd, iot-gateway-main.sch]
2020-02-03 Fix ADC precision loss by right shift instead of dividing (already fixed before but came back?)
    [iot-gateway-main.brd, iot-gateway-main.sch]
2020-03-07 Change 5V_NBU regulator to LT8640S
    [iot-gateway-main.brd, iot-gateway-main.sch]
2021-02-01 Fix ADC stuck in low accuracy bias mode Update GCC and CMSIS
    [adc.c]
2021-02-05 Add gerber files for production
